seancaulfield/tick/README.md

tick
====

Terribly Illuminated Chronology Keeper
