seancaulfield/tick/hardware/DESCRIPTION.md

Terribly Illuminated Chronology Keeper (T.I.C.K) Mk 4.6.4

RTC, microcontroller, and whatever else my crazy brain thinks would be a good idea to throw in there. Don't ask what happened to the other revisions.

* Includes integrated RTC (DS3231) with CR2032 battery backup.
* ATMega328P uC
* 7-segment, 4 digit LED clock display, 0.8" digit height
* 7-segment, 8 digit LED date display, 0.4" digit height
* 96mm x 53mm PCB, should fit in a Hammond 1591C series enclosure

Design files in EAGLE format, firmware, and licensing info available on github:

[https://github.com/schizobovine/tick](https://github.com/schizobovine/tick)
