seancaulfield/tick/hardware/tick-pcf2129t-breakout-mk-1.0.brd

## EAGLE design hardware/tick-pcf2129t-breakout-mk-1.0.brd (2019-09-15)

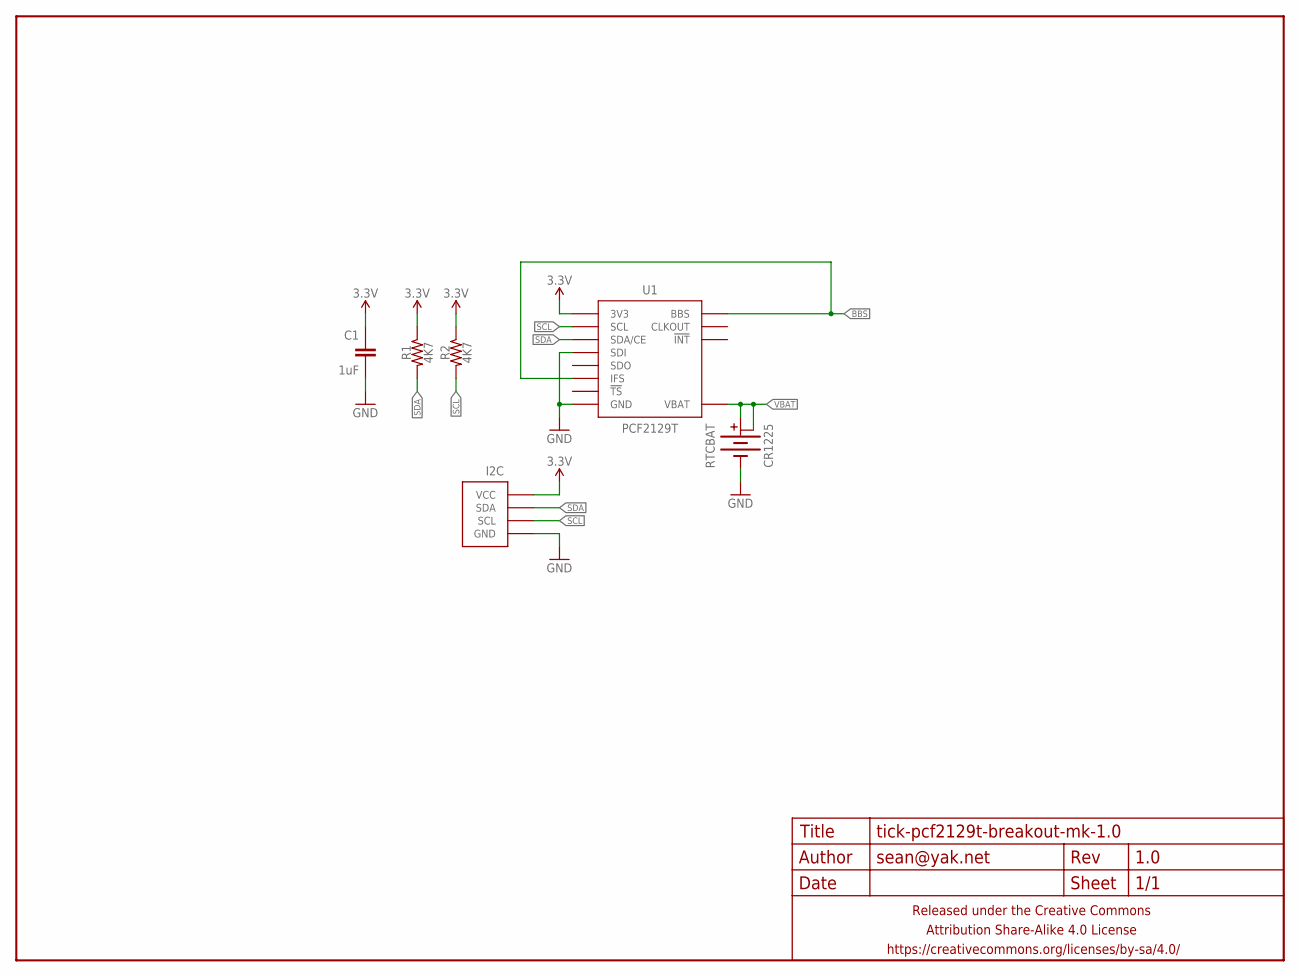
[picture p4: schematic tick-pcf2129t-breakout-mk-1.0.sch]

Parts:
C1: 1uF; C0603-TIGHTER
FRAME1: FRAME-LETTERNO_PACKAGE; DUMMY
I2C: M04-I2CPTH-0.1IN-CENTERED; 1X04-PTH-VERT-I2C-CENTERED
R1, R2: 4K7; R0603-TIGHTER
RTCBAT: CR1225; BATTCON_12MM_SMD
U1: PCF2129T; SO16W

Connections:
3.3V: C1.1, I2C.VCC, R1.1, R2.1, U1.16 (3V3)
BBS: U1.5 (IFS), U1.14 (BBS)
GND: C1.2, I2C.GND, RTCBAT.-, U1.2 (SDI), U1.8 (GND)
SCL: I2C.SCL, R2.2, U1.1 (SCL)
SDA: I2C.SDA, R1.2, U1.4 (SDA/CE)
VBAT: RTCBAT.+@1 (+), RTCBAT.+@2 (+1), U1.15 (VBAT)

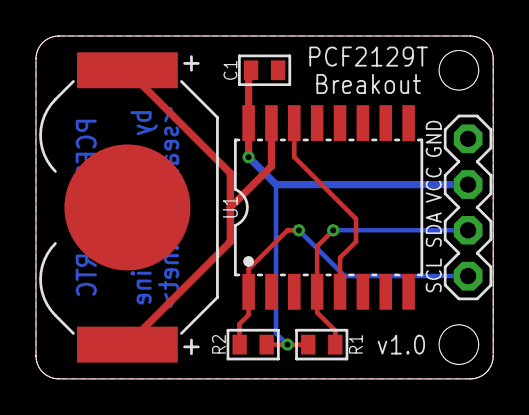
[picture p5: board tick-pcf2129t-breakout-mk-1.0.brd from above]

Board: 2 copper layers, 25.4 x 19.1 mm, 8 parts (1 on the bottom side), 6 nets.

Other parts of the board:
U$1: COW_SMALL
