seancaulfield/tick/hardware/tick-pi-mk-1.0.brd

## EAGLE design hardware/tick-pi-mk-1.0.brd (2019-09-15)

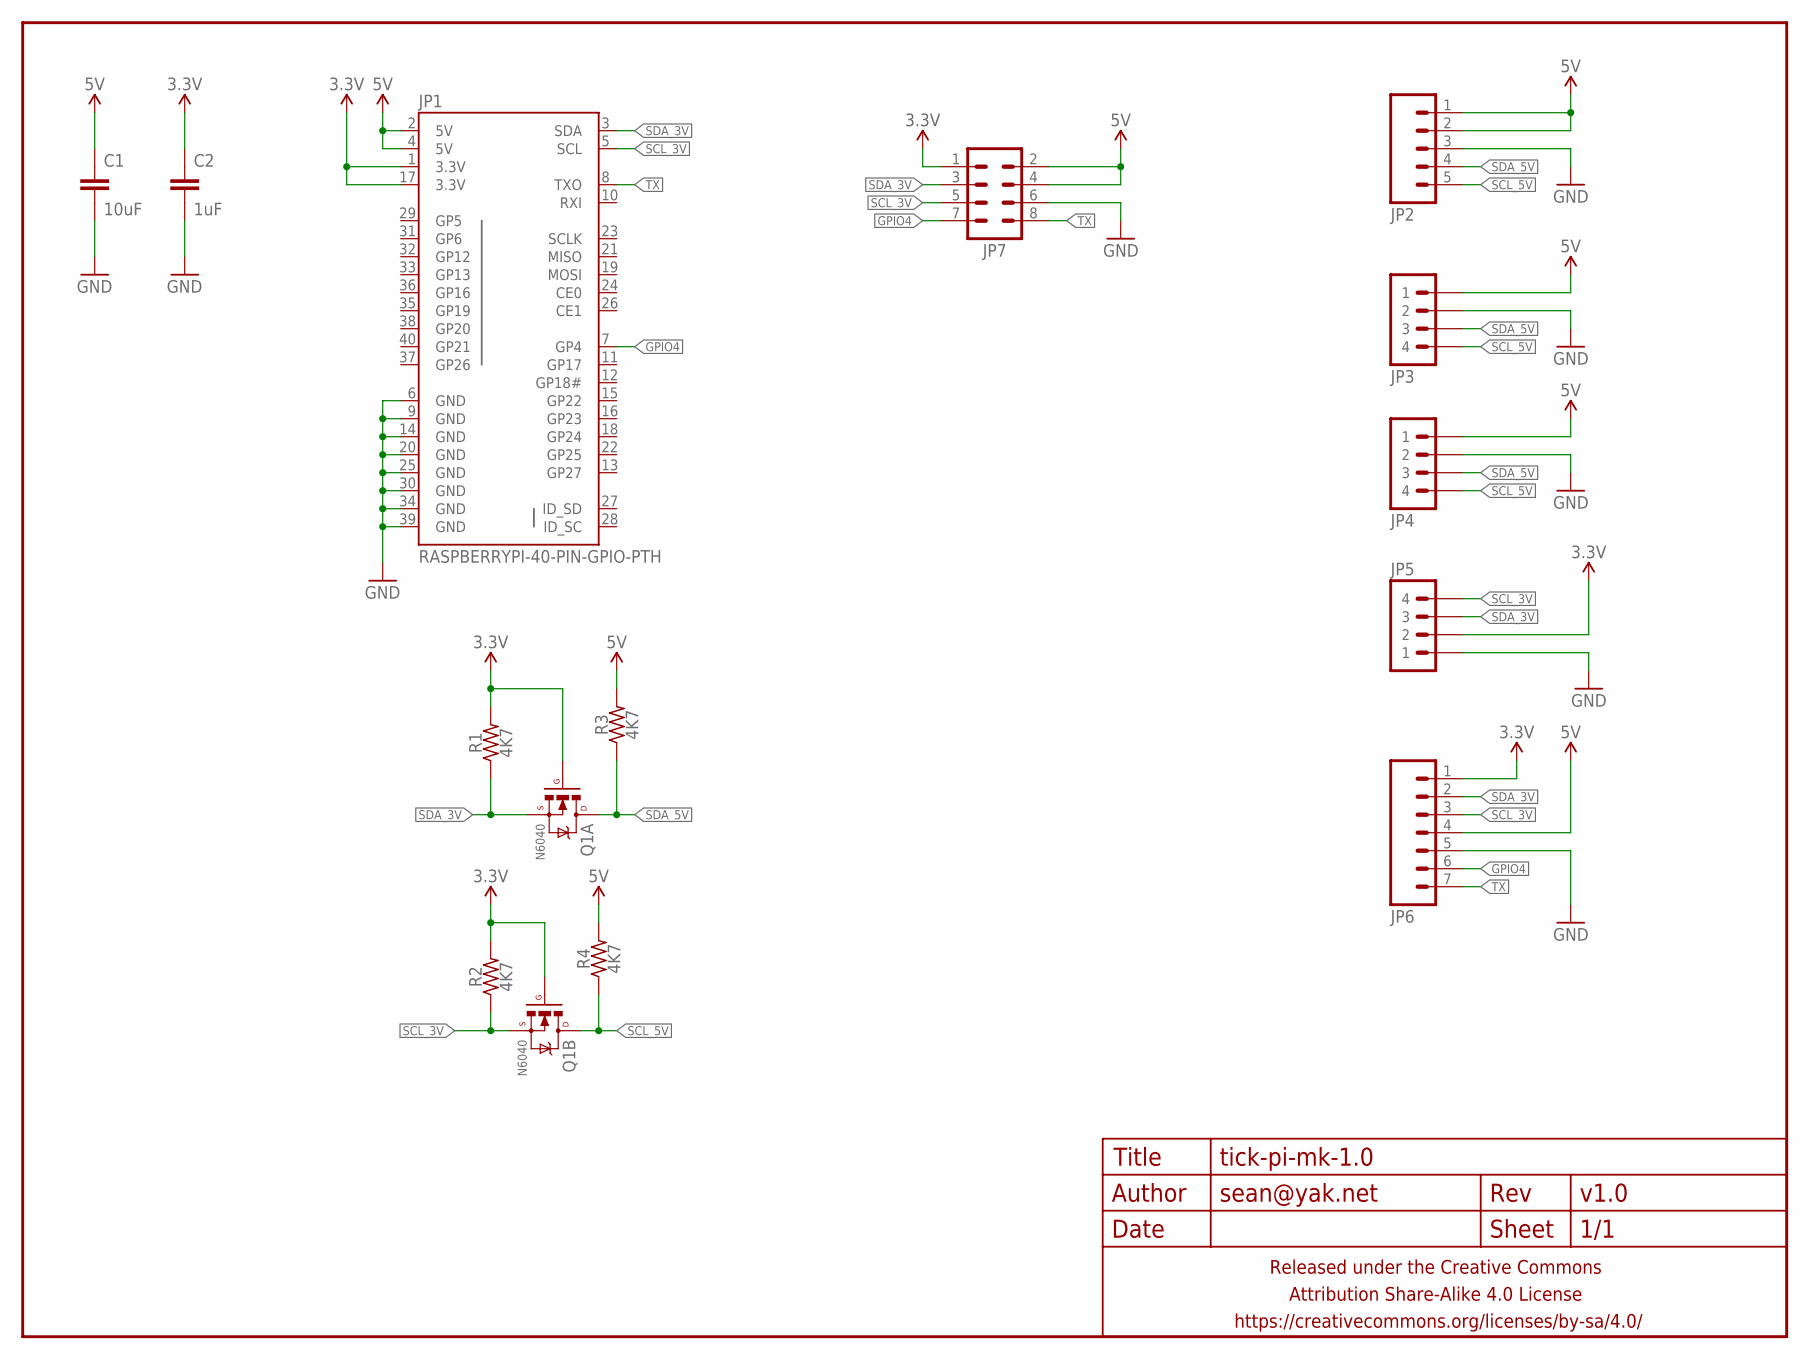
[picture p6: schematic tick-pi-mk-1.0.sch]

Parts:
C1: 10uF; C0805-TIGHTER
C2: 1uF; C0805-TIGHTER
FRAME1: FRAME-LETTERNO_PACKAGE; DUMMY
JP1: RASPBERRYPI-40-PIN-GPIO-PTH; 2X20_PTH
JP2: M05PTH-CENTERED-RA-FEMALE; 1X05_PTH_CENTERED_RA_FEMALE
JP3, JP4, JP5: M04PTH; 1X04-PTH-VERT
JP6: M07; 1X07
JP7: M04X2PTH; 2X4_PTH
Q1: N6040; SO08
R1, R2, R3, R4: 4K7; R0603

Connections:
3.3V: C2.1, JP1.1 (3.3V), JP1.17 (3.3V), JP5.2, JP6.1, JP7.1, Q1.2 (G), Q1.4 (G), R1.2, R2.2
5V: C1.1, JP1.2 (5V), JP1.4 (5V), JP2.1, JP2.2, JP3.1, JP4.1, JP6.4, JP7.2, JP7.4, R3.2, R4.2
GND: C1.2, C2.2, JP1.6 (GND), JP1.9 (GND), JP1.14 (GND), JP1.20 (GND), JP1.25 (GND), JP1.30 (GND), JP1.34 (GND), JP1.39 (GND), JP2.3, JP3.2, JP4.2, JP5.1, JP6.5, JP7.6
GPIO4: JP1.7 (GP4), JP6.6, JP7.7
SCL_3V: JP1.5 (SCL), JP5.4, JP6.3, JP7.5, Q1.3 (S), R2.1
SCL_5V: JP2.5, JP3.4, JP4.4, Q1.5 (D), Q1.6 (D), R4.1
SDA_3V: JP1.3 (SDA), JP5.3, JP6.2, JP7.3, Q1.1 (S), R1.1
SDA_5V: JP2.4, JP3.3, JP4.3, Q1.7 (D), Q1.8 (D), R3.1
TX: JP1.8 (TXO), JP6.7, JP7.8

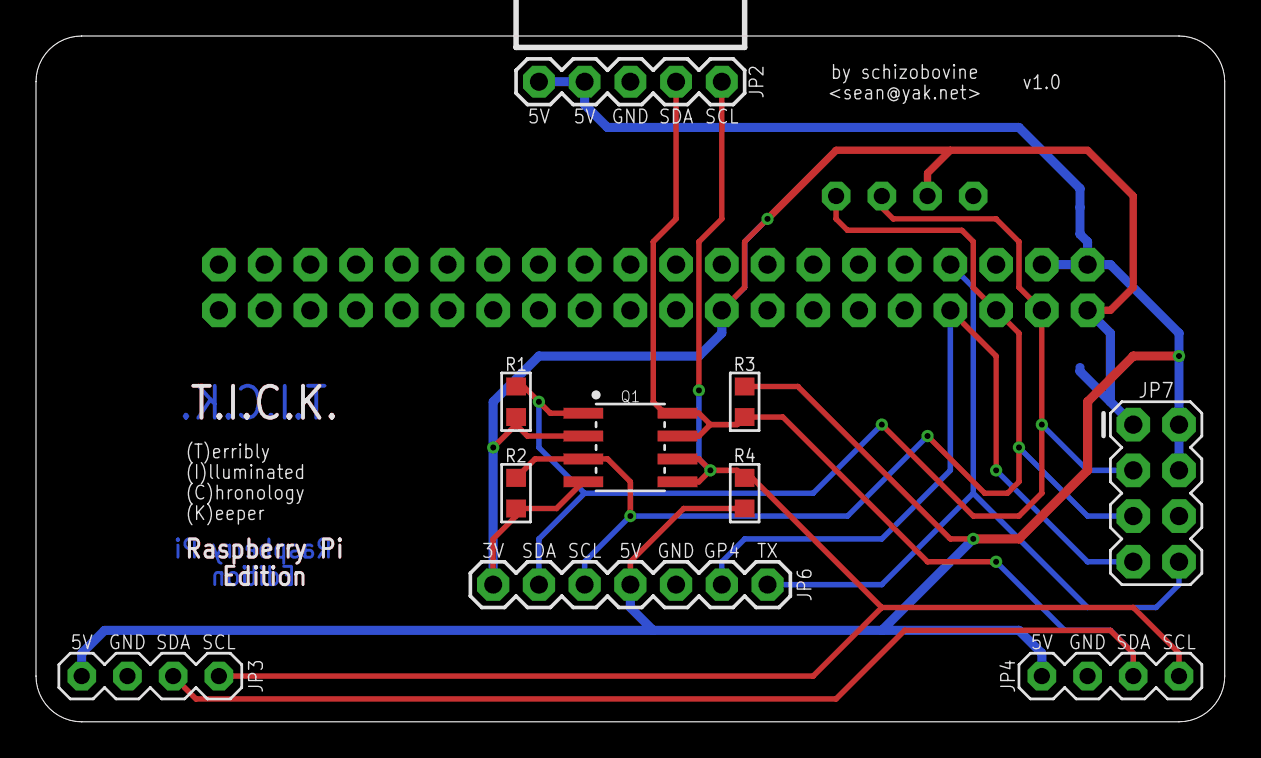
[picture p7: board tick-pi-mk-1.0.brd from above]

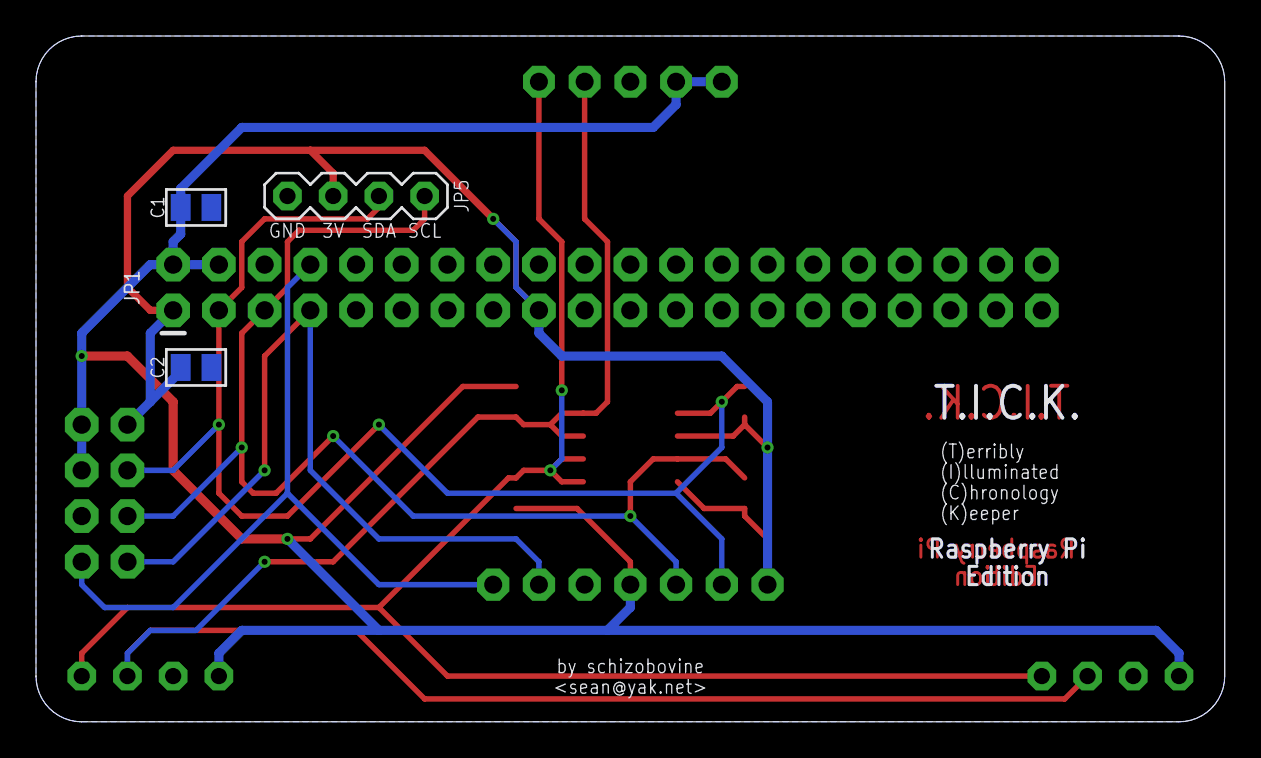
[picture p8: board tick-pi-mk-1.0.brd from below]

Board: 2 copper layers, 66.0 x 38.1 mm, 15 parts (4 on the bottom side), 9 nets.
