seancaulfield/tick/hardware/tick-wifi-mk-1.2.brd

## EAGLE design hardware/tick-wifi-mk-1.2.brd (2016-08-26)

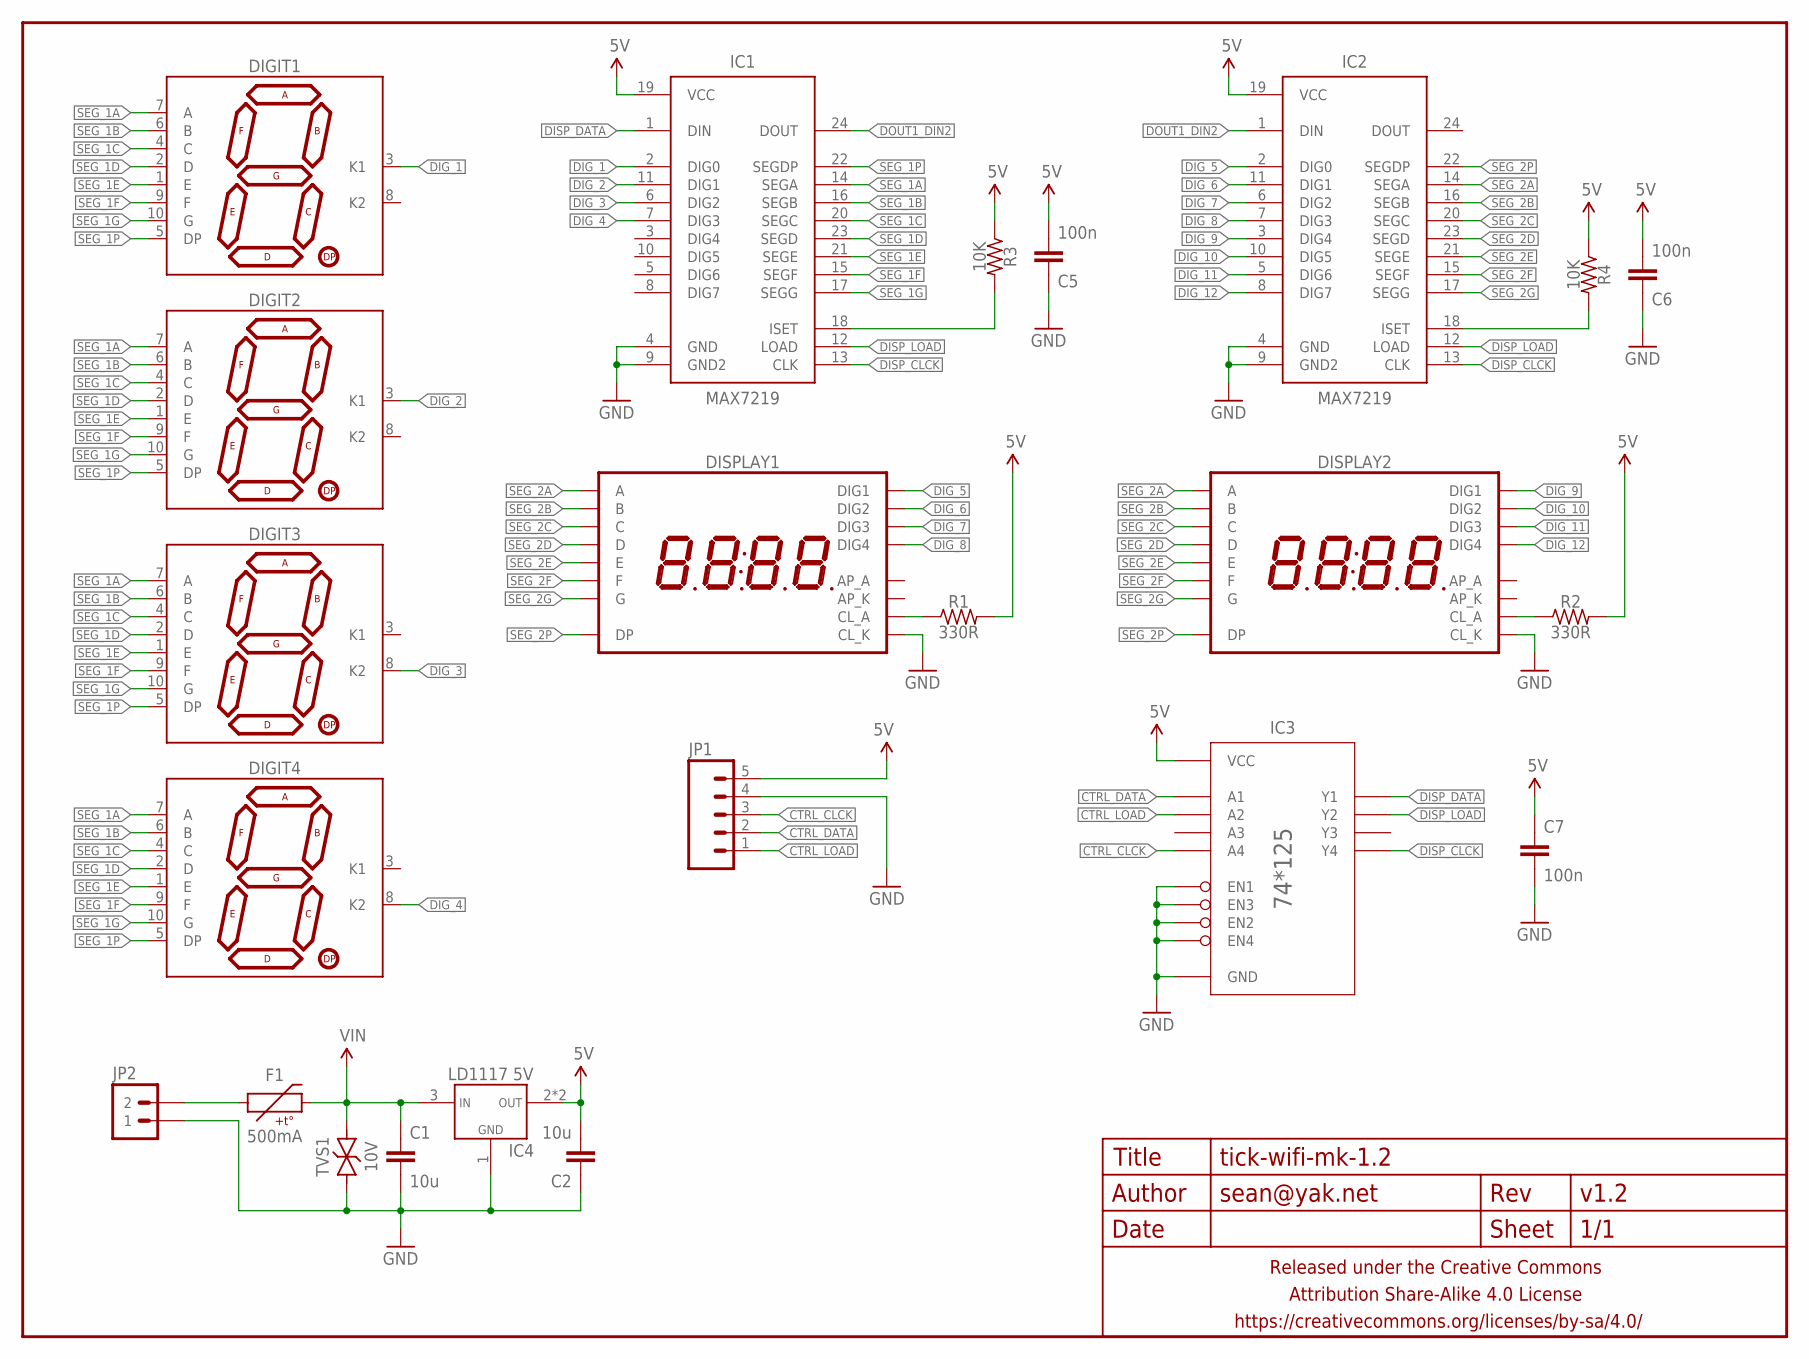
[picture p9: schematic tick-wifi-mk-1.2.sch]

Parts:
C1, C2: 10u; C1210
C5, C6, C7: 100n; C0603
DIGIT1, DIGIT2, DIGIT3, DIGIT4: 7SEG_1DIGPTH-25.4MM-BARE; 7SEG_1DIG_25.4MM_NOSILK
DISPLAY1, DISPLAY2: 7SEG_4DIGIT_COLON_APOS; 7SEG_4DIG_10MM
F1: 500mA; PTC-1210
FRAME1: FRAME-LETTERNO_PACKAGE; DUMMY
IC1, IC2: MAX7219; SO24W
IC3: 74HC125; SO14
IC4: LD1117 5V; SOT223
JP1: M05PTH-CENTERED; 1X05_PTH_CENTERED
JP2: M02PTH-CENTERED-R+; 1X02-CENTER-R+
R1, R2: 330R; R0603
R3, R4: 10K; R0603
TVS1: 10V; SMA-DIODE-TVS-BIDIR

Connections:
5V: C2.2, C5.2, C6.2, C7.1, IC1.19 (VCC), IC2.19 (VCC), IC3.14 (VCC), IC4.2 (VOUT), IC4.4 (VOUT), JP1.5, R1.2, R2.2, R3.1, R4.1
CTRL_CLCK: IC3.12 (A4), JP1.3
CTRL_DATA: IC3.2 (A1), JP1.2
CTRL_LOAD: IC3.5 (A2), JP1.1
DIG_1: DIGIT1.3 (K1), IC1.2 (DIG0)
DIG_2: DIGIT2.3 (K1), IC1.11 (DIG1)
DIG_3: DIGIT3.8 (K2), IC1.6 (DIG2)
DIG_4: DIGIT4.8 (K2), IC1.7 (DIG3)
DIG_5: DISPLAY1.1 (DIG1), IC2.2 (DIG0)
DIG_6: DISPLAY1.2 (DIG2), IC2.11 (DIG1)
DIG_7: DISPLAY1.6 (DIG3), IC2.6 (DIG2)
DIG_8: DISPLAY1.8 (DIG4), IC2.7 (DIG3)
DIG_9: DISPLAY2.1 (DIG1), IC2.3 (DIG4)
DIG_10: DISPLAY2.2 (DIG2), IC2.10 (DIG5)
DIG_11: DISPLAY2.6 (DIG3), IC2.5 (DIG6)
DIG_12: DISPLAY2.8 (DIG4), IC2.8 (DIG7)
DISP_CLCK: IC1.13 (CLK), IC2.13 (CLK), IC3.11 (Y4)
DISP_DATA: IC1.1 (DIN), IC3.3 (Y1)
DISP_LOAD: IC1.12 (LOAD), IC2.12 (LOAD), IC3.6 (Y2)
DOUT1_DIN2: IC1.24 (DOUT), IC2.1 (DIN)
GND: C1.2, C2.1, C5.1, C6.1, C7.2, DISPLAY1.12 (CL_K), DISPLAY2.12 (CL_K), IC1.4 (GND), IC1.9 (GND2), IC2.4 (GND), IC2.9 (GND2), IC3.1 (EN1), IC3.4 (EN2), IC3.7 (GND), IC3.10 (EN3), IC3.13 (EN4), IC4.1 (GND), JP1.4, JP2.1, TVS1.1
unnamed: F1.1, JP2.2
unnamed: IC2.18 (ISET), R4.2
unnamed: DISPLAY1.4 (CL_A), R1.1
unnamed: IC1.18 (ISET), R3.2
unnamed: DISPLAY2.4 (CL_A), R2.1
SEG_1A: DIGIT1.7 (A), DIGIT2.7 (A), DIGIT3.7 (A), DIGIT4.7 (A), IC1.14 (SEGA)
SEG_1B: DIGIT1.6 (B), DIGIT2.6 (B), DIGIT3.6 (B), DIGIT4.6 (B), IC1.16 (SEGB)
SEG_1C: DIGIT1.4 (C), DIGIT2.4 (C), DIGIT3.4 (C), DIGIT4.4 (C), IC1.20 (SEGC)
SEG_1D: DIGIT1.2 (D), DIGIT2.2 (D), DIGIT3.2 (D), DIGIT4.2 (D), IC1.23 (SEGD)
SEG_1E: DIGIT1.1 (E), DIGIT2.1 (E), DIGIT3.1 (E), DIGIT4.1 (E), IC1.21 (SEGE)
SEG_1F: DIGIT1.9 (F), DIGIT2.9 (F), DIGIT3.9 (F), DIGIT4.9 (F), IC1.15 (SEGF)
SEG_1G: DIGIT1.10 (G), DIGIT2.10 (G), DIGIT3.10 (G), DIGIT4.10 (G), IC1.17 (SEGG)
SEG_1P: DIGIT1.5 (DP), DIGIT2.5 (DP), DIGIT3.5 (DP), DIGIT4.5 (DP), IC1.22 (SEGDP)
SEG_2A: DISPLAY1.14 (A), DISPLAY2.14 (A), IC2.14 (SEGA)
SEG_2B: DISPLAY1.16 (B), DISPLAY2.16 (B), IC2.16 (SEGB)
SEG_2C: DISPLAY1.13 (C), DISPLAY2.13 (C), IC2.20 (SEGC)
SEG_2D: DISPLAY1.3 (D), DISPLAY2.3 (D), IC2.23 (SEGD)
SEG_2E: DISPLAY1.5 (E), DISPLAY2.5 (E), IC2.21 (SEGE)
SEG_2F: DISPLAY1.11 (F), DISPLAY2.11 (F), IC2.15 (SEGF)
SEG_2G: DISPLAY1.15 (G), DISPLAY2.15 (G), IC2.17 (SEGG)
SEG_2P: DISPLAY1.7 (DP), DISPLAY2.7 (DP), IC2.22 (SEGDP)
VIN: C1.1, F1.2, IC4.3 (VIN), TVS1.2

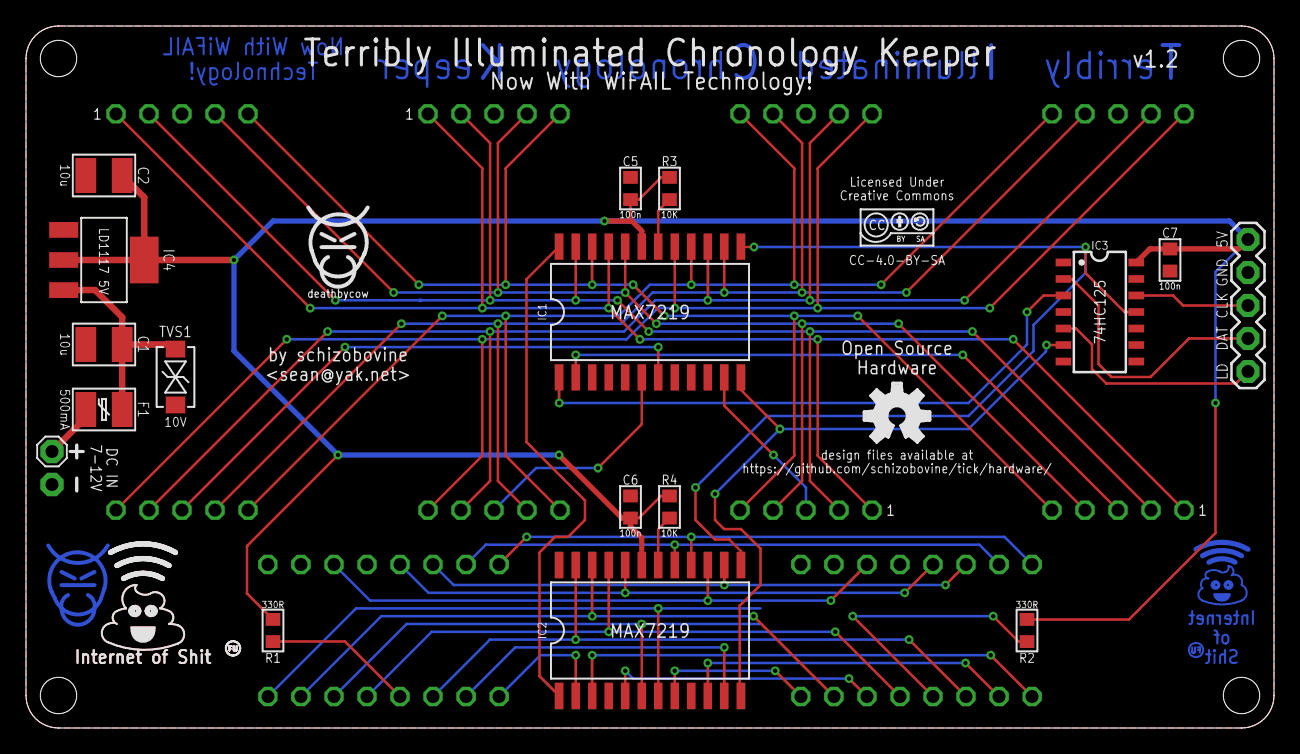
[picture p10: board tick-wifi-mk-1.2.brd from above]

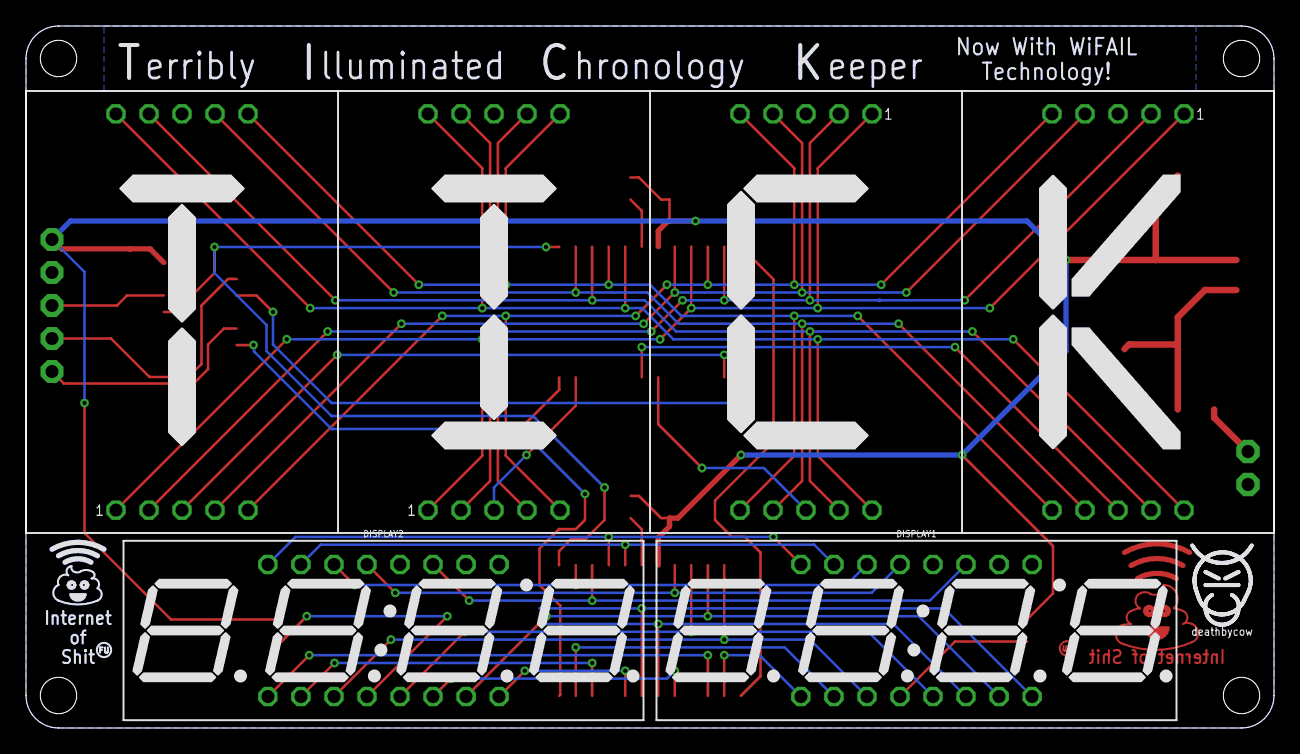
[picture p11: board tick-wifi-mk-1.2.brd from below]

Board: 2 copper layers, 96.0 x 54.0 mm, 34 parts (11 on the bottom side), 43 nets.

Other parts of the board:
U$1: TICK_SYMBOL
U$2, U$5: COW_SMALL
U$3: INTERNET_OF_SHIT_TEXT_METAL
U$4: INTERNET_OF_SHIT_TEXT
U$6: CC-BY-SA-4.0-NO-URL
U$7: OSHWLOGO_SILKONLY
U$8: INTERNET_OF_SHIT_JR_METAL
U$9: COW_SMALL_METAL_NOTEXT
U$10: F_YOU_MARK_METAL
