seancaulfield/tick/hardware/tick-wifi-mini-mk-1.3.brd

## EAGLE design hardware/tick-wifi-mini-mk-1.3.brd (2016-08-19)

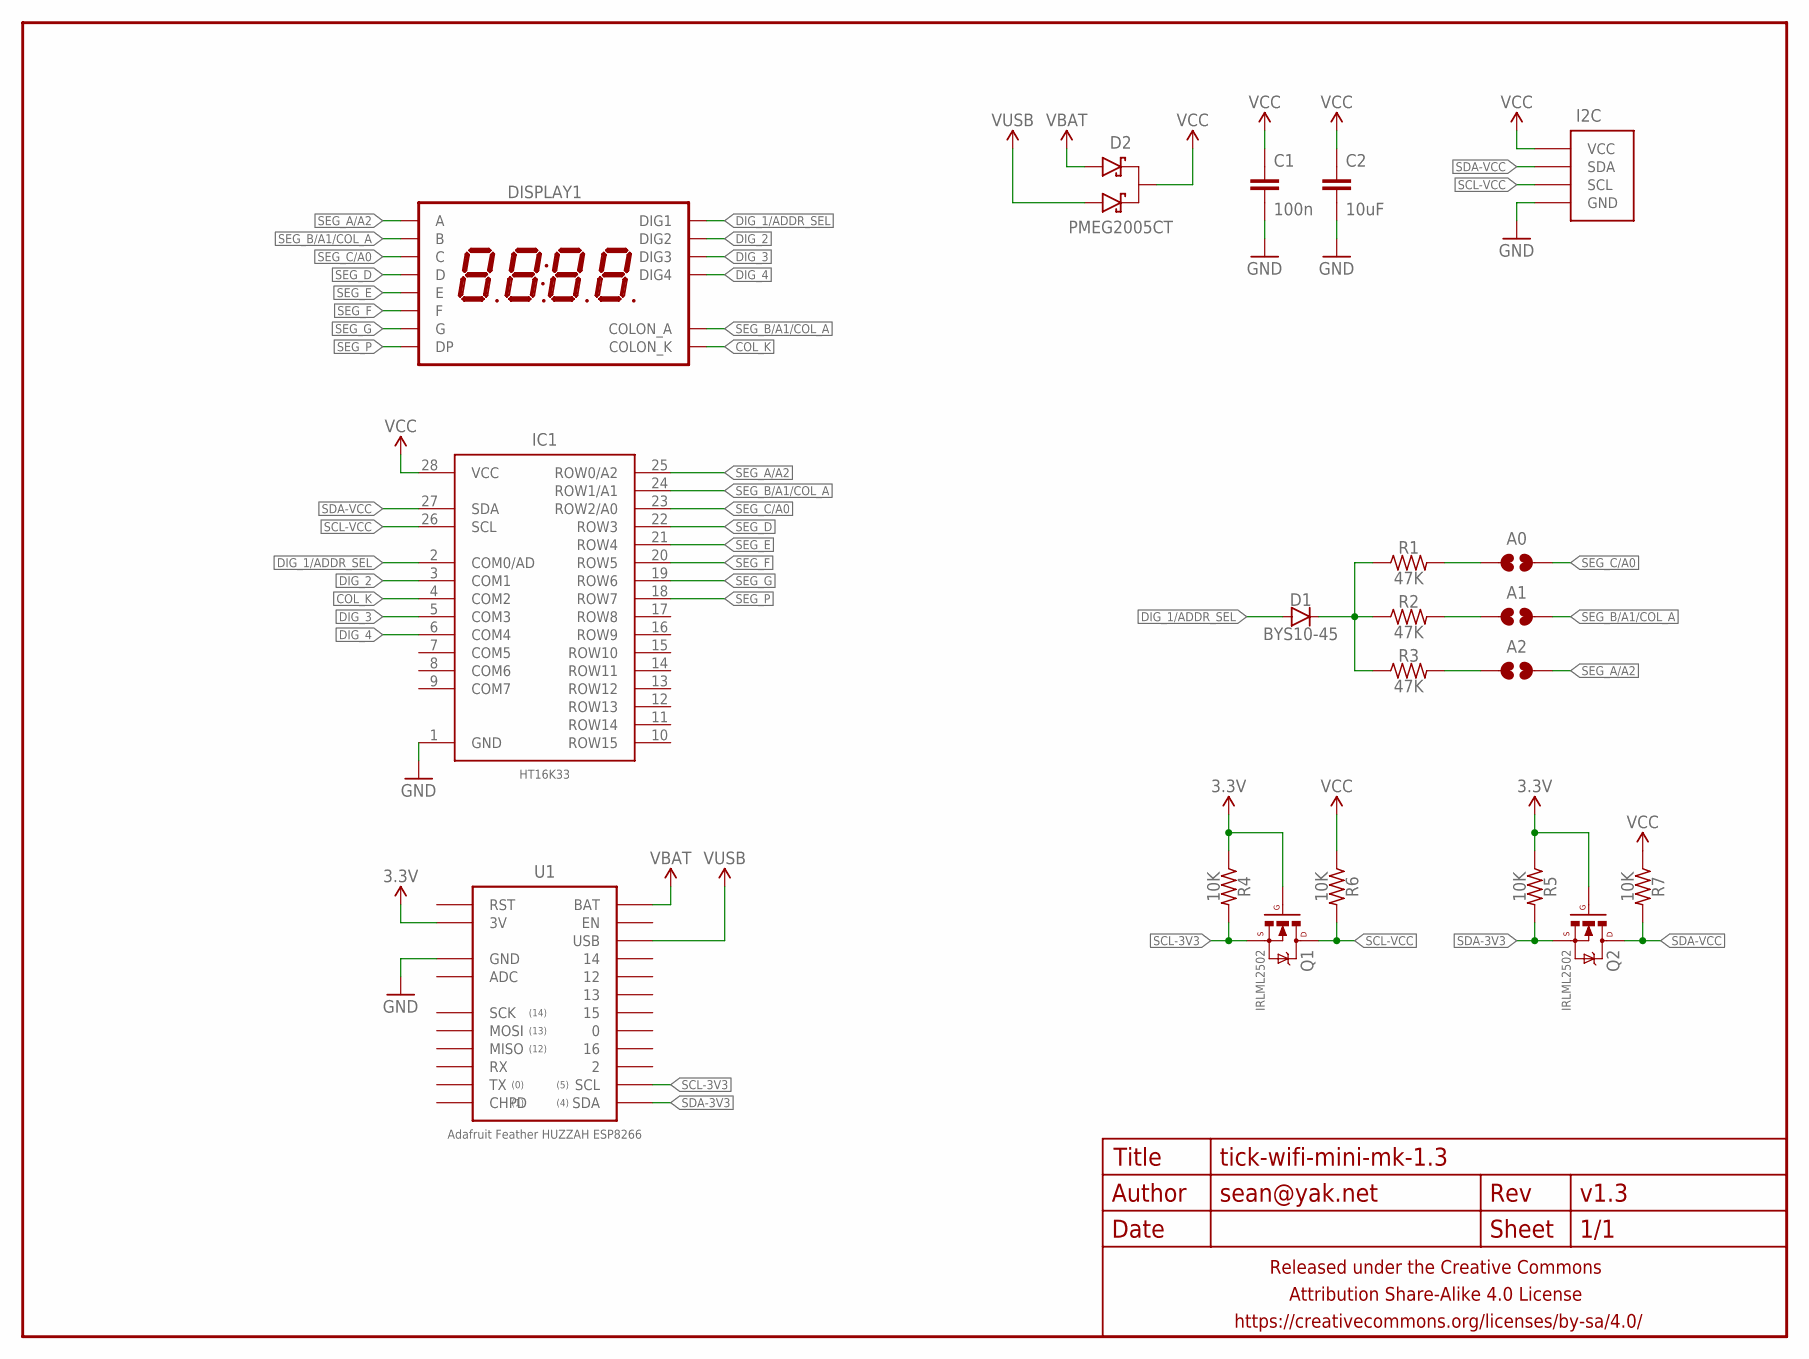
[picture p12: schematic tick-wifi-mini-mk-1.3.sch]

Parts:
A0, A1, A2: JUMPER-PAD-2-NOYES_SILK; PAD-JUMPER-2-NO_YES_SILK
C1: 100n; C0603-TIGHTER
C2: 10uF; C0805-TIGHTER
D1: BYS10-45; SOD323
D2: PMEG2005CT; SOT23
DISPLAY1: 7SEG_4DIGIT_COLON14.2MM-CC; 7SEG_4DIG_0.56IN_14MM_ADAFRUIT
FRAME1: FRAME-LETTERNO_PACKAGE; DUMMY
I2C: M04-I2CPTH-2MM-CENTERED; 1X04-2MM-CENTERED-I2C
IC1: HT16K33; SOIC28W
Q1, Q2: IRLML2502; SOT23
R1, R2, R3: 47K; R0603-TIGHTER
R4, R5, R6, R7: 10K; R0603-TIGHTER
U1: Adafruit Feather HUZZAH ESP8266; ADAFRUIT_FEATHER_HUZZAH_NOSILK

Connections:
3.3V: Q1.1 (G), Q2.1 (G), R4.1, R5.1, U1.3V
COL_K: DISPLAY1.P$7 (COLON_K), IC1.4 (COM2)
DIG_1/ADDR_SEL: D1.A, DISPLAY1.P$14 (DIG1), IC1.2 (COM0/AD)
DIG_2: DISPLAY1.P$11 (DIG2), IC1.3 (COM1)
DIG_3: DISPLAY1.P$10 (DIG3), IC1.5 (COM3)
DIG_4: DISPLAY1.P$6 (DIG4), IC1.6 (COM4)
GND: C1.2, C2.2, I2C.1 (GND), IC1.1 (GND), U1.GND@0 (GND)
unnamed: D1.C, R1.1, R2.1, R3.1
unnamed: A0.1, R1.2
unnamed: A1.1, R2.2
unnamed: A2.1, R3.2
SCL-3V3: Q1.2 (S), R4.2, U1.SCL
SCL-VCC: I2C.4 (SCL), IC1.26 (SCL), Q1.3 (D), R6.2
SDA-3V3: Q2.2 (S), R5.2, U1.SDA
SDA-VCC: I2C.3 (SDA), IC1.27 (SDA), Q2.3 (D), R7.2
SEG_A/A2: A2.2, DISPLAY1.P$13 (A), IC1.25 (ROW0/A2)
SEG_B/A1/COL_A: A1.2, DISPLAY1.P$8 (COLON_A), DISPLAY1.P$9 (B), IC1.24 (ROW1/A1)
SEG_C/A0: A0.2, DISPLAY1.P$4 (C), IC1.23 (ROW2/A0)
SEG_D: DISPLAY1.P$2 (D), IC1.22 (ROW3)
SEG_E: DISPLAY1.P$1 (E), IC1.21 (ROW4)
SEG_F: DISPLAY1.P$12 (F), IC1.20 (ROW5)
SEG_G: DISPLAY1.P$5 (G), IC1.19 (ROW6)
SEG_P: DISPLAY1.P$3 (DP), IC1.18 (ROW7)
VBAT: D2.1 (A1), U1.BAT
VCC: C1.1, C2.1, D2.3 (K), I2C.2 (VCC), IC1.28 (VCC), R6.1, R7.1
VUSB: D2.2 (A2), U1.USB

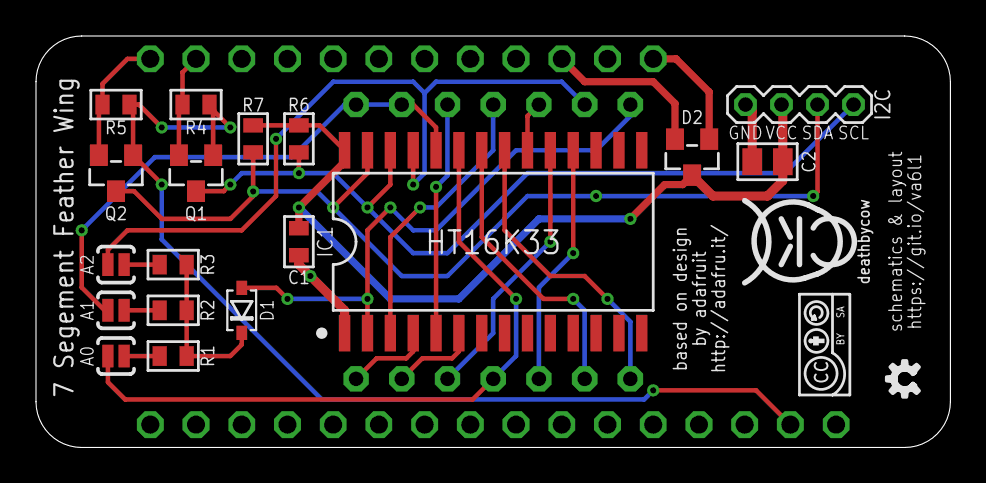
[picture p13: board tick-wifi-mini-mk-1.3.brd from above]

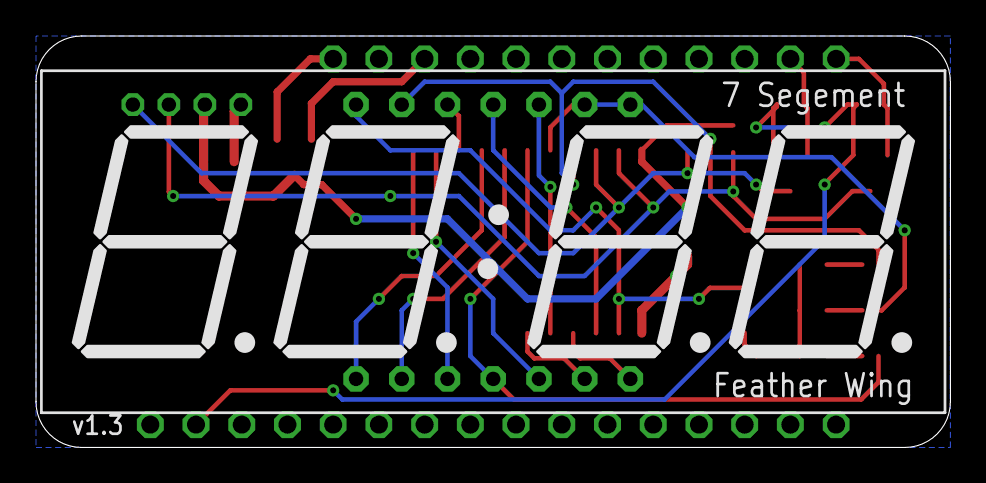
[picture p14: board tick-wifi-mini-mk-1.3.brd from below]

Board: 2 copper layers, 50.8 x 22.9 mm, 24 parts (2 on the bottom side), 26 nets.

Other parts of the board:
U$2: COW_SMALL
U$3: OSHWLOGO_TINY_SILKONLY
U$4: CC-BY-SA-4.0-NO-URL
