seancaulfield/tick/hardware/tick-box-1591A-mk-5.0.brd

## EAGLE design hardware/tick-box-1591A-mk-5.0.brd (2015-12-01)

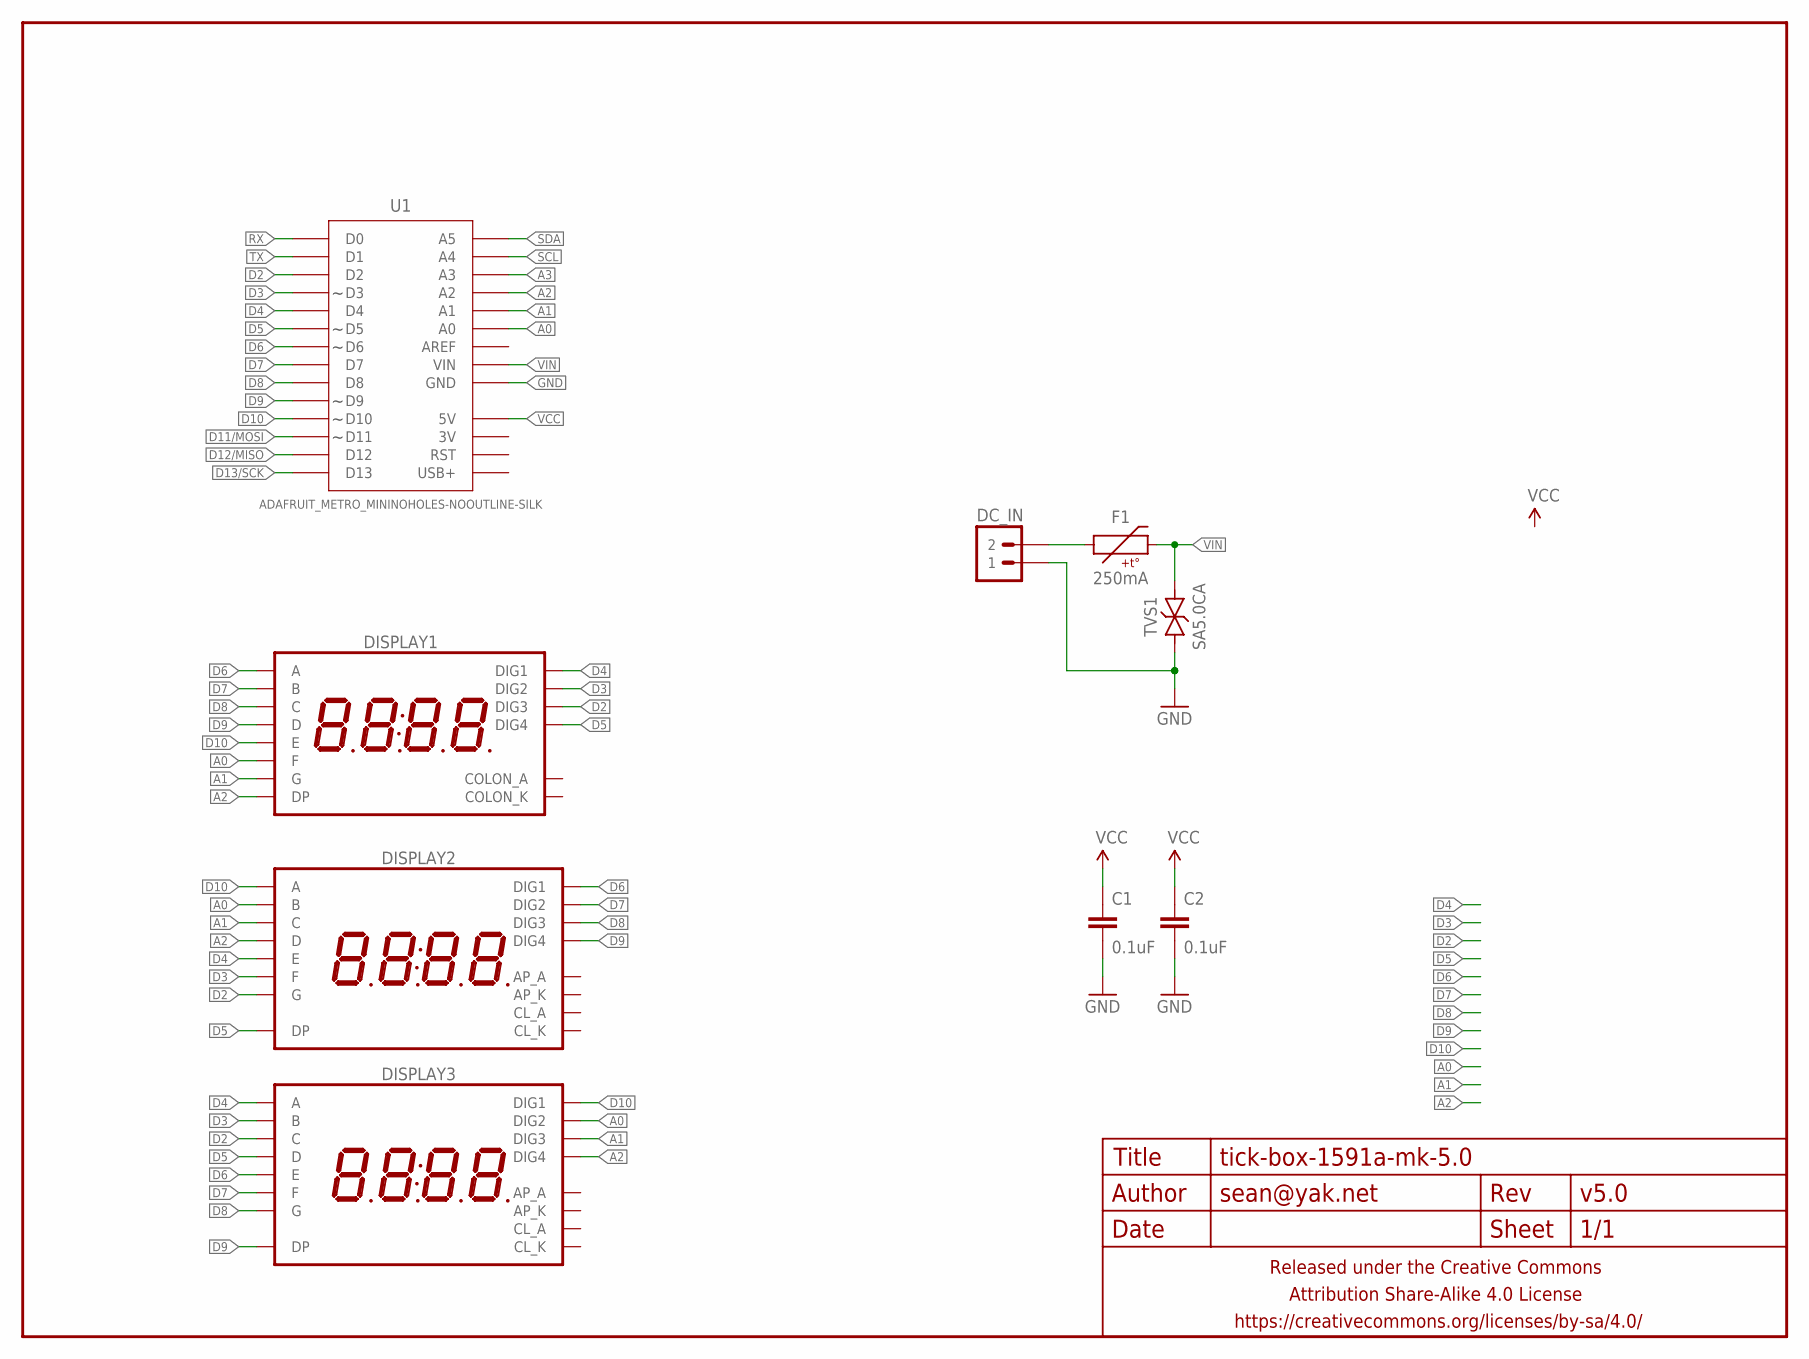
[picture p15: schematic tick-box-1591A-mk-5.0.sch]

Parts:
C1, C2: 0.1uF; C0603
DC_IN: M02PTH-CENTERED-R+; 1X02-CENTER-R+
DISPLAY1: 7SEG_4DIGIT_COLON14.2MM-CC-NS; 7SEG_4DIG_NS
DISPLAY2, DISPLAY3: 7SEG_4DIGIT_COLON_APOS; 7SEG_4DIG_10MM
F1: 250mA; PTC-1210
FRAME1: FRAME-LETTERNO_PACKAGE; DUMMY
TVS1: SA5.0CA; SMA-DIODE-TVS-BIDIR
U1: ADAFRUIT_METRO_MININOHOLES-NOOUTLINE-SILK; ADAFRUIT_METRO_MINI

Connections:
A0: DISPLAY1.P$12 (F), DISPLAY2.16 (B), DISPLAY3.2 (DIG2), U1.23 (A0)
A1: DISPLAY1.P$5 (G), DISPLAY2.13 (C), DISPLAY3.6 (DIG3), U1.24 (A1)
A2: DISPLAY1.P$3 (DP), DISPLAY2.3 (D), DISPLAY3.8 (DIG4), U1.25 (A2)
A3: U1.26 (A3)
D2: DISPLAY1.P$10 (DIG3), DISPLAY2.15 (G), DISPLAY3.13 (C), U1.3 (D2)
D3: DISPLAY1.P$11 (DIG2), DISPLAY2.11 (F), DISPLAY3.16 (B), U1.4 (D3)
D4: DISPLAY1.P$14 (DIG1), DISPLAY2.5 (E), DISPLAY3.14 (A), U1.5 (D4)
D5: DISPLAY1.P$6 (DIG4), DISPLAY2.7 (DP), DISPLAY3.3 (D), U1.6 (D5)
D6: DISPLAY1.P$13 (A), DISPLAY2.1 (DIG1), DISPLAY3.5 (E), U1.7 (D6)
D7: DISPLAY1.P$9 (B), DISPLAY2.2 (DIG2), DISPLAY3.11 (F), U1.8 (D7)
D8: DISPLAY1.P$4 (C), DISPLAY2.6 (DIG3), DISPLAY3.15 (G), U1.9 (D8)
D9: DISPLAY1.P$2 (D), DISPLAY2.8 (DIG4), DISPLAY3.7 (DP), U1.10 (D9)
D10: DISPLAY1.P$1 (E), DISPLAY2.14 (A), DISPLAY3.1 (DIG1), U1.11 (D10)
D11/MOSI: U1.12 (D11)
D12/MISO: U1.13 (D12)
D13/SCK: U1.14 (D13)
GND: C1.2, C2.2, DC_IN.1, TVS1.1, U1.19 (GND), U1.20 (GND)
unnamed: DC_IN.2, F1.1
RX: U1.1 (D0)
SCL: U1.27 (A4)
SDA: U1.28 (A5)
TX: U1.2 (D1)
VCC: C1.1, C2.1, U1.18 (5V)
VIN: F1.2, TVS1.2, U1.21 (VIN)

Board: 2 copper layers, 10 parts (3 on the bottom side), 16 nets, no tracks yet.
