seancaulfield/tick/hardware/tick-mk-5.1.brd

## EAGLE design hardware/tick-mk-5.1.brd (2015-11-30)

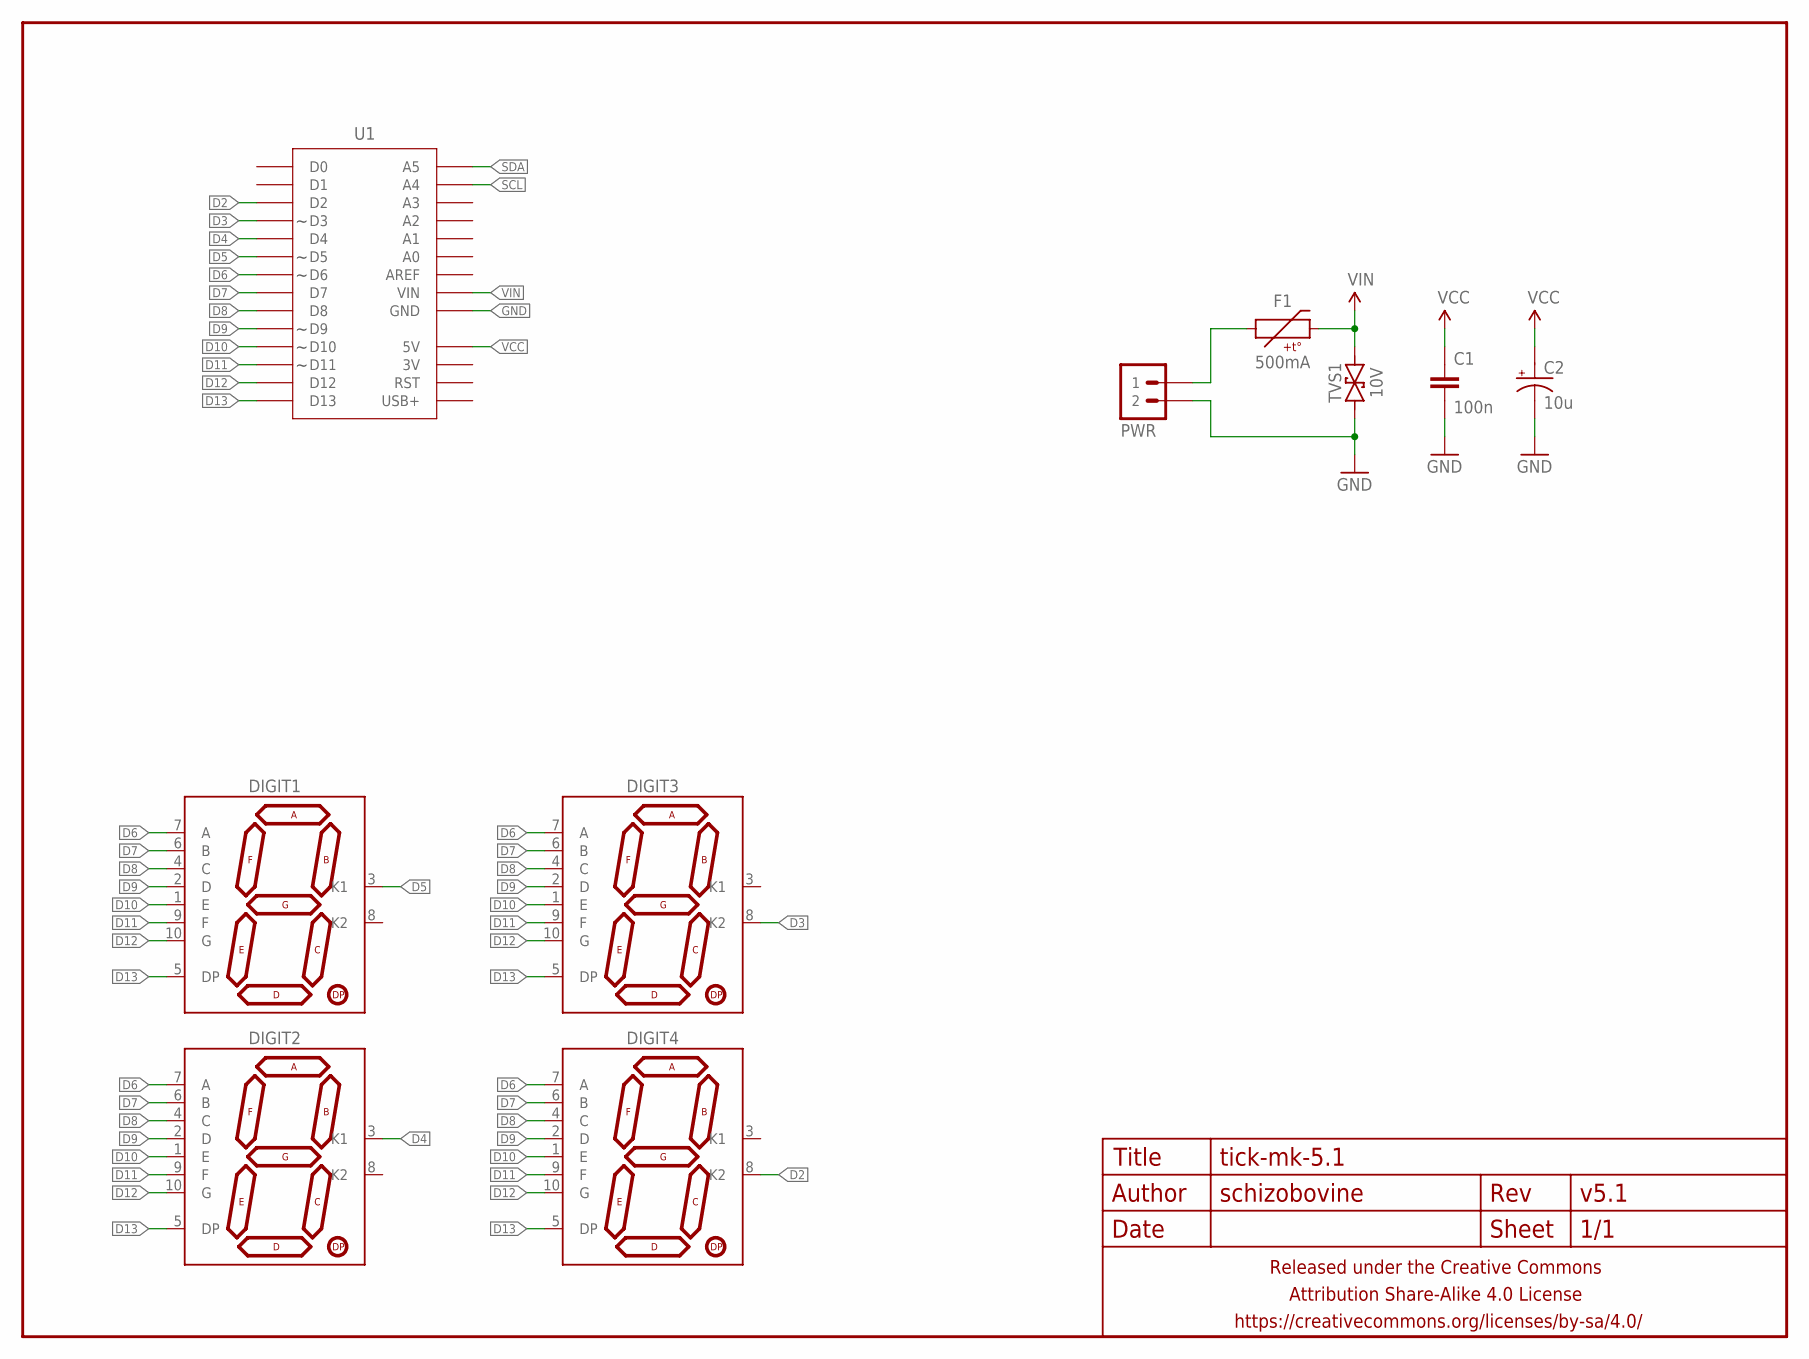
[picture p16: schematic tick-mk-5.1.sch]

Parts:
C1: 100n; C025-024X044
C2: 10u; E2-5
DIGIT1, DIGIT2, DIGIT3, DIGIT4: 7SEG_1DIGPTH-25.4MM-BARE; 7SEG_1DIG_25.4MM_NOSILK
F1: 500mA; PTC-PTH-5.08MM
FRAME1: FRAME-LETTERNO_PACKAGE; DUMMY
PWR: M02JST-PTH-VERT; JST-2-PH-VERT-PTH
TVS1: 10V; DO-41-TVS-BI-10.16MM
U1: ADAFRUIT_METRO_MININOHOLES-NOOUTLINE-SILK; ADAFRUIT_METRO_MINI

Connections:
D2: DIGIT4.8 (K2), U1.3 (D2)
D3: DIGIT3.8 (K2), U1.4 (D3)
D4: DIGIT2.3 (K1), U1.5 (D4)
D5: DIGIT1.3 (K1), U1.6 (D5)
D6: DIGIT1.7 (A), DIGIT2.7 (A), DIGIT3.7 (A), DIGIT4.7 (A), U1.7 (D6)
D7: DIGIT1.6 (B), DIGIT2.6 (B), DIGIT3.6 (B), DIGIT4.6 (B), U1.8 (D7)
D8: DIGIT1.4 (C), DIGIT2.4 (C), DIGIT3.4 (C), DIGIT4.4 (C), U1.9 (D8)
D9: DIGIT1.2 (D), DIGIT2.2 (D), DIGIT3.2 (D), DIGIT4.2 (D), U1.10 (D9)
D10: DIGIT1.1 (E), DIGIT2.1 (E), DIGIT3.1 (E), DIGIT4.1 (E), U1.11 (D10)
D11: DIGIT1.9 (F), DIGIT2.9 (F), DIGIT3.9 (F), DIGIT4.9 (F), U1.12 (D11)
D12: DIGIT1.10 (G), DIGIT2.10 (G), DIGIT3.10 (G), DIGIT4.10 (G), U1.13 (D12)
D13: DIGIT1.5 (DP), DIGIT2.5 (DP), DIGIT3.5 (DP), DIGIT4.5 (DP), U1.14 (D13)
GND: C1.2, C2.-, PWR.2, TVS1.P$1 (1), U1.19 (GND), U1.20 (GND)
unnamed: F1.P$1 (1), PWR.1
SCL: U1.27 (A4)
SDA: U1.28 (A5)
VCC: C1.1, C2.+, U1.18 (5V)
VIN: F1.P$2 (2), TVS1.P$2 (2), U1.21 (VIN)

Board: 2 copper layers, 15 parts (5 on the bottom side), 16 nets, no tracks yet.

Other parts of the board:
U$1: TICK_SYMBOL
U$2: COW_SMALL
U$4: CC-BY-SA-4.0-NO-URL
U$5: OSHWLOGO_TOP_0.2
