seancaulfield/tick/hardware/tick-mk-5.0.brd

## EAGLE design hardware/tick-mk-5.0.brd (2015-11-30)

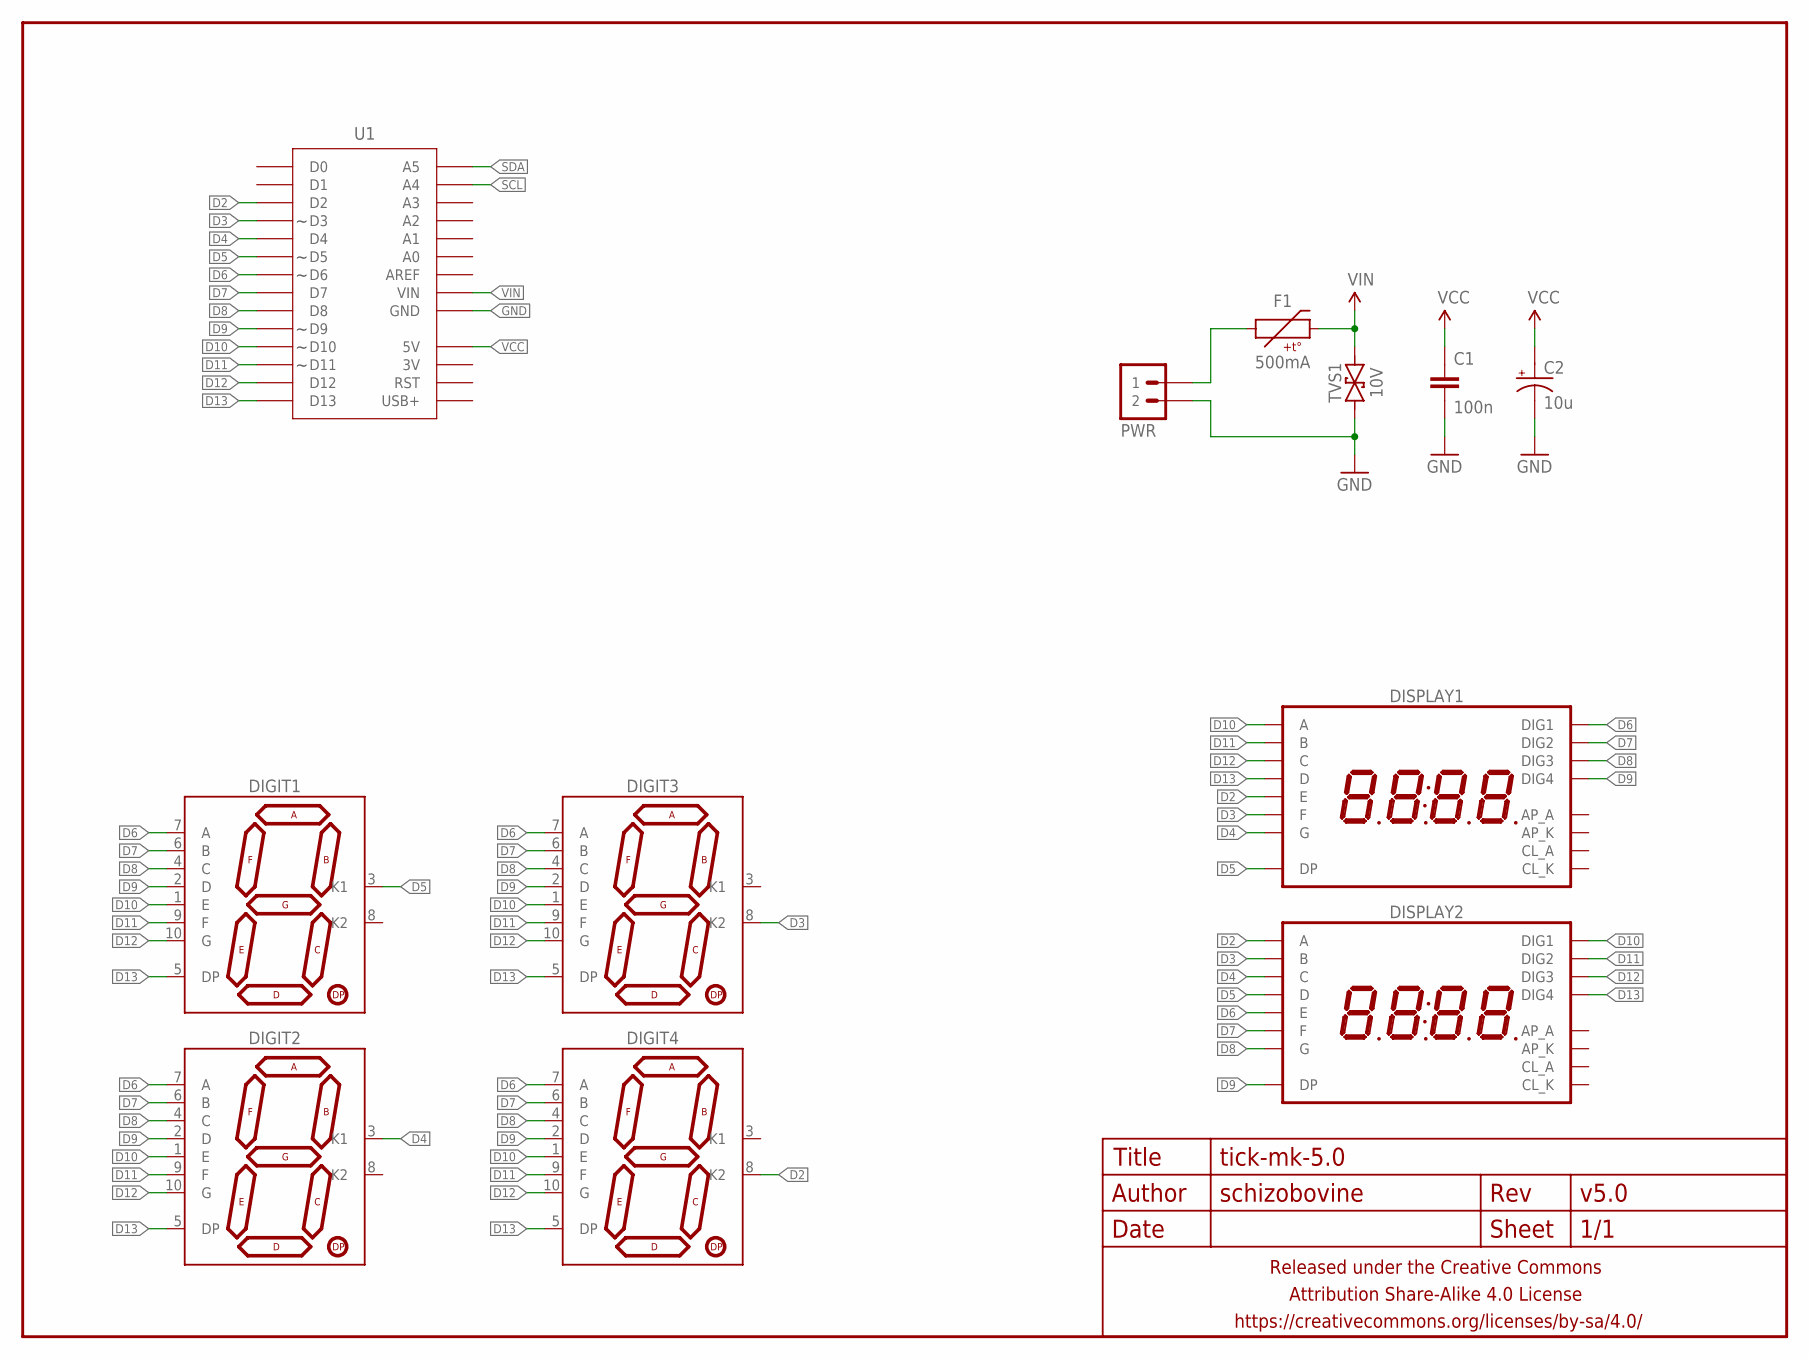
[picture p17: schematic tick-mk-5.0.sch]

Parts:
C1: 100n; C025-024X044
C2: 10u; E2-5
DIGIT1, DIGIT2, DIGIT3, DIGIT4: 7SEG_1DIGPTH-25.4MM-BARE; 7SEG_1DIG_25.4MM_NOSILK
DISPLAY1, DISPLAY2: 7SEG_4DIGIT_COLON_APOS; 7SEG_4DIG_10MM
F1: 500mA; PTC-PTH-5.08MM
FRAME1: FRAME-LETTERNO_PACKAGE; DUMMY
PWR: M02JST-PTH-VERT; JST-2-PH-VERT-PTH
TVS1: 10V; DO-41-TVS-BI-10.16MM
U1: ADAFRUIT_METRO_MININOHOLES-NOOUTLINE-SILK; ADAFRUIT_METRO_MINI

Connections:
D2: DIGIT4.8 (K2), DISPLAY1.5 (E), DISPLAY2.14 (A), U1.3 (D2)
D3: DIGIT3.8 (K2), DISPLAY1.11 (F), DISPLAY2.16 (B), U1.4 (D3)
D4: DIGIT2.3 (K1), DISPLAY1.15 (G), DISPLAY2.13 (C), U1.5 (D4)
D5: DIGIT1.3 (K1), DISPLAY1.7 (DP), DISPLAY2.3 (D), U1.6 (D5)
D6: DIGIT1.7 (A), DIGIT2.7 (A), DIGIT3.7 (A), DIGIT4.7 (A), DISPLAY1.1 (DIG1), DISPLAY2.5 (E), U1.7 (D6)
D7: DIGIT1.6 (B), DIGIT2.6 (B), DIGIT3.6 (B), DIGIT4.6 (B), DISPLAY1.2 (DIG2), DISPLAY2.11 (F), U1.8 (D7)
D8: DIGIT1.4 (C), DIGIT2.4 (C), DIGIT3.4 (C), DIGIT4.4 (C), DISPLAY1.6 (DIG3), DISPLAY2.15 (G), U1.9 (D8)
D9: DIGIT1.2 (D), DIGIT2.2 (D), DIGIT3.2 (D), DIGIT4.2 (D), DISPLAY1.8 (DIG4), DISPLAY2.7 (DP), U1.10 (D9)
D10: DIGIT1.1 (E), DIGIT2.1 (E), DIGIT3.1 (E), DIGIT4.1 (E), DISPLAY1.14 (A), DISPLAY2.1 (DIG1), U1.11 (D10)
D11: DIGIT1.9 (F), DIGIT2.9 (F), DIGIT3.9 (F), DIGIT4.9 (F), DISPLAY1.16 (B), DISPLAY2.2 (DIG2), U1.12 (D11)
D12: DIGIT1.10 (G), DIGIT2.10 (G), DIGIT3.10 (G), DIGIT4.10 (G), DISPLAY1.13 (C), DISPLAY2.6 (DIG3), U1.13 (D12)
D13: DIGIT1.5 (DP), DIGIT2.5 (DP), DIGIT3.5 (DP), DIGIT4.5 (DP), DISPLAY1.3 (D), DISPLAY2.8 (DIG4), U1.14 (D13)
GND: C1.2, C2.-, PWR.2, TVS1.P$1 (1), U1.19 (GND), U1.20 (GND)
unnamed: F1.P$1 (1), PWR.1
SCL: U1.27 (A4)
SDA: U1.28 (A5)
VCC: C1.1, C2.+, U1.18 (5V)
VIN: F1.P$2 (2), TVS1.P$2 (2), U1.21 (VIN)

Board: 2 copper layers, 19 parts (9 on the bottom side), 16 nets, no tracks yet.

Other parts of the board:
U$1: TICK_SYMBOL
U$2: COW_SMALL
U$4, U$7: CC-BY-SA-4.0-NO-URL
U$5, U$6: OSHWLOGO_TOP_0.2
