seancaulfield/tick/hardware/tick-shield-mk-2.0.brd

## EAGLE design hardware/tick-shield-mk-2.0.brd (2015-08-10)

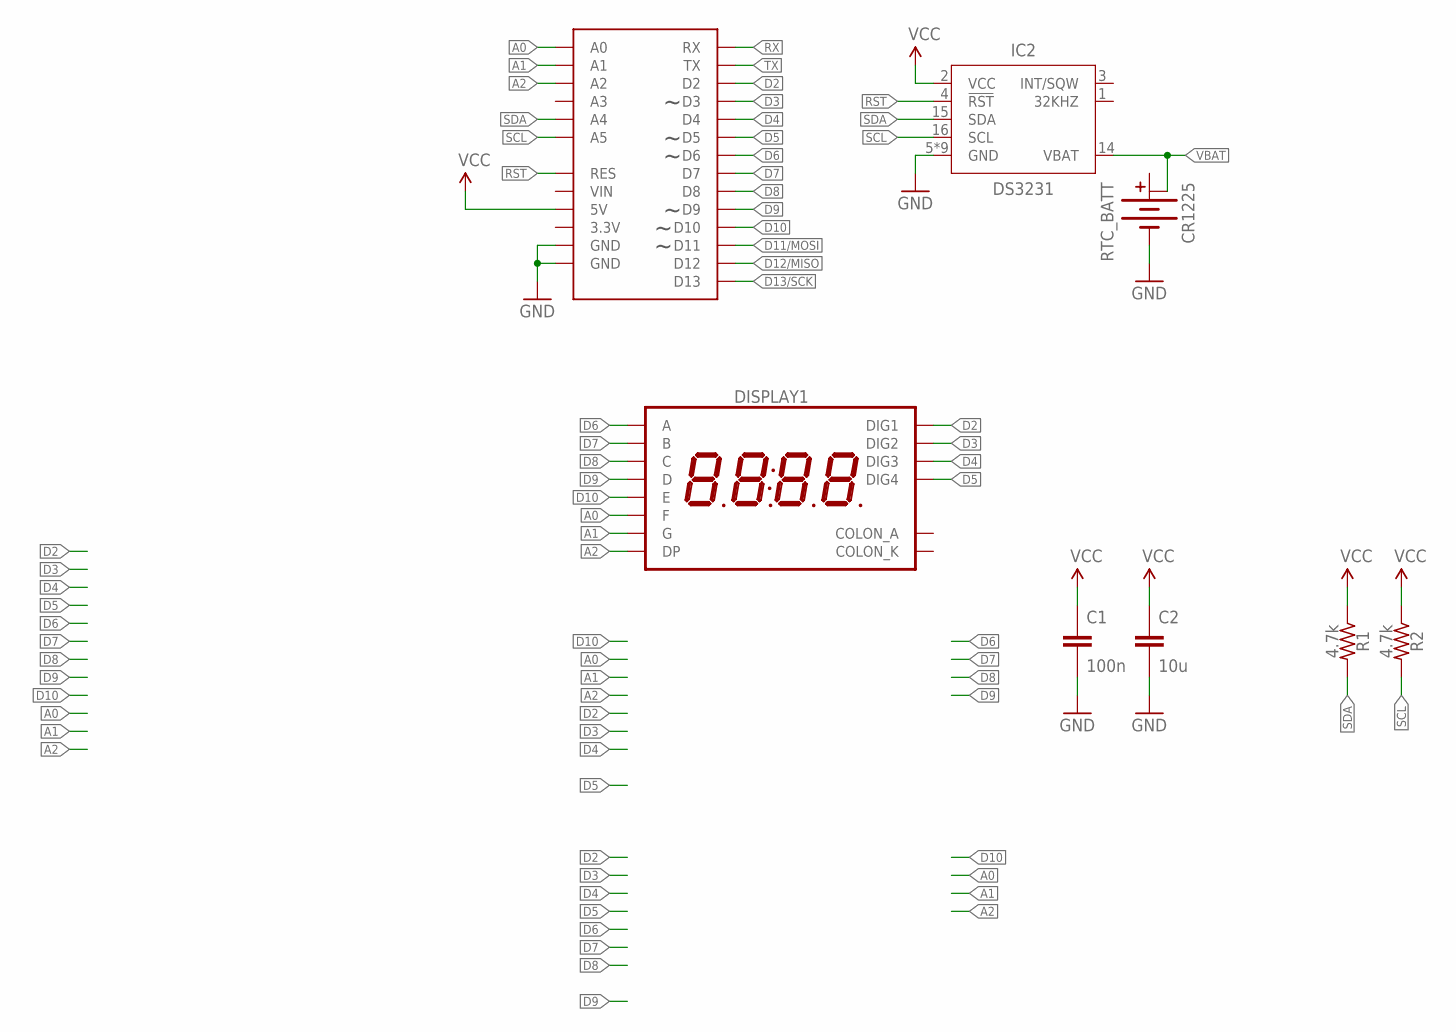
[picture p18: schematic tick-shield-mk-2.0.sch]

Parts:
C1: 100n; C025-024X044
C2: 10u; C050-025X075
DISPLAY1: 7SEG_4DIGIT_COLONTICK; 7SEG_4DIG_TICK
IC2: DS3231; SO16W
R1, R2: 4.7k; RESISTOR-AXIAL-PTH-7.62MM
RTC_BATT: CR1225; BATTCON_12MM_PTH3
U$1: ARDUINO_SHIELD_SMALLER; ARDUINO_SHIELD_NOOUTLINE_INSIDE_SMALLER

Connections:
A0: DISPLAY1.P$12 (F), U$1.A0
A1: DISPLAY1.P$5 (G), U$1.A1
A2: DISPLAY1.P$3 (DP), U$1.A2
D2: DISPLAY1.P$14 (DIG1), U$1.D2
D3: DISPLAY1.P$11 (DIG2), U$1.D3
D4: DISPLAY1.P$10 (DIG3), U$1.D4
D5: DISPLAY1.P$6 (DIG4), U$1.D5
D6: DISPLAY1.P$13 (A), U$1.D6
D7: DISPLAY1.P$9 (B), U$1.D7
D8: DISPLAY1.P$4 (C), U$1.D8
D9: DISPLAY1.P$2 (D), U$1.D9
D10: DISPLAY1.P$1 (E), U$1.D10
D11/MOSI: U$1.D11
D12/MISO: U$1.D12
D13/SCK: U$1.D13
GND: C1.2, C2.2, IC2.5 (GND), IC2.6 (GND), IC2.7 (GND), IC2.8 (GND), IC2.9 (GND), IC2.10 (GND), IC2.11 (GND), IC2.12 (GND), IC2.13 (GND), RTC_BATT.-, U$1.GND@0 (GND), U$1.GND@1 (GND)
RST: IC2.4 (!RST), U$1.RES
RX: U$1.RX
SCL: IC2.16 (SCL), R2.P$2 (2), U$1.A5
SDA: IC2.15 (SDA), R1.P$2 (2), U$1.A4
TX: U$1.TX
VBAT: IC2.14 (VBAT), RTC_BATT.+@3 (+1), RTC_BATT.+@4 (+1)
VCC: C1.1, C2.1, IC2.2 (VCC), R1.P$1 (1), R2.P$1 (1), U$1.5V

Board: 2 copper layers, 12 parts (2 on the bottom side), 18 nets, no tracks yet.

Other parts of the board:
U$3, U$4: CC-BY-SA-4.0-NO-URL
U$7, U$8: OSHWLOGO_TOP_0.2_A
