seancaulfield/tick/hardware/tick-mini-shield-mk-1.0.brd

## EAGLE design hardware/tick-mini-shield-mk-1.0.brd (2015-08-10)

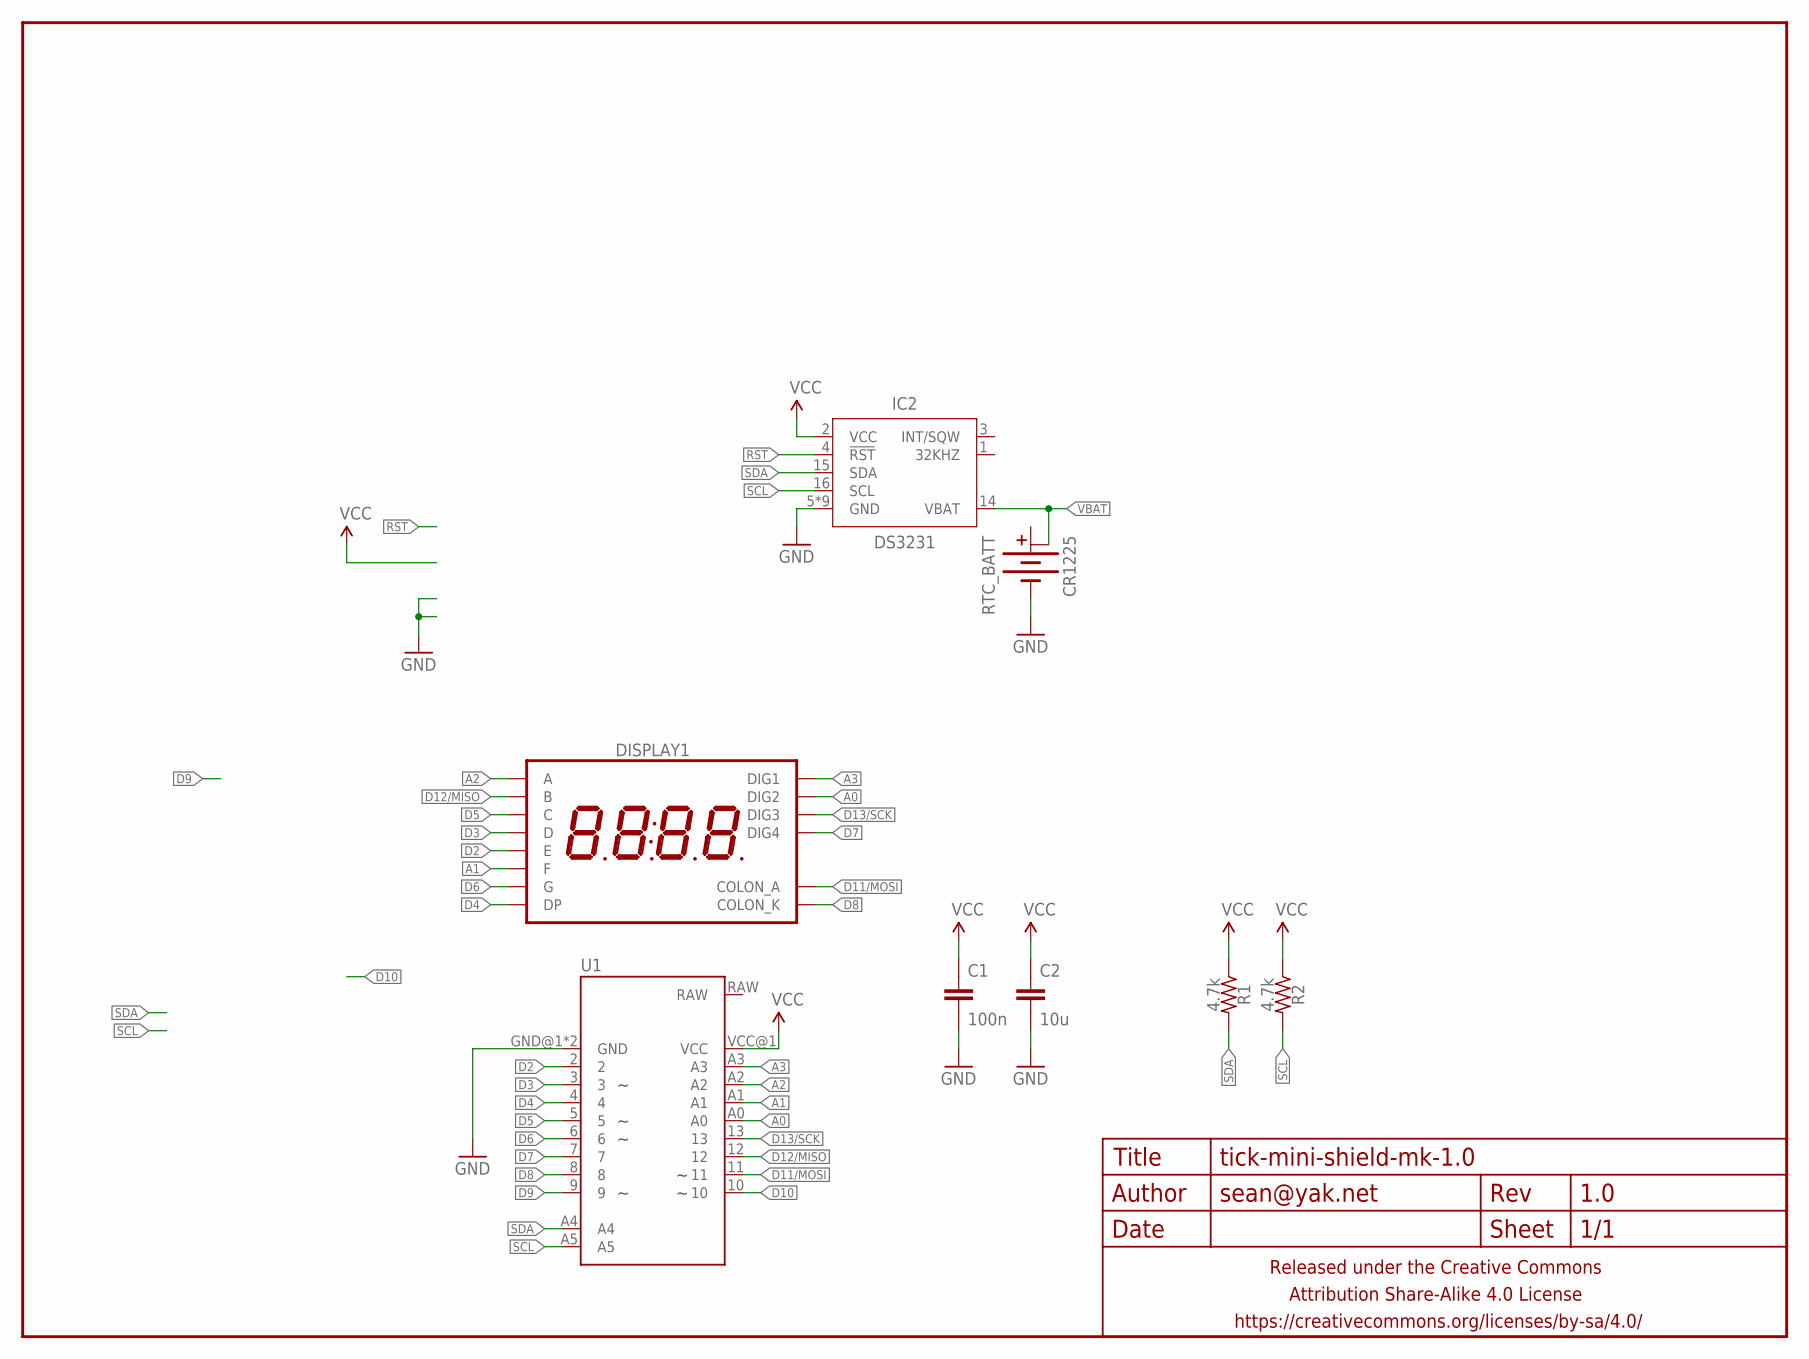
[picture p19: schematic tick-mini-shield-mk-1.0.sch]

Parts:
C1: 100n; C025-024X044
C2: 10u; C050-025X075
DISPLAY1: 7SEG_4DIGIT_COLONTICK; 7SEG_4DIG_TICK
FRAME1: FRAME-LETTERNO_PACKAGE; DUMMY
IC2: DS3231; SO16W
R1, R2: 4.7k; RESISTOR-AXIAL-PTH-7.62MM
RTC_BATT: CR1225; BATTCON_12MM_PTH3
U1: ARDUINO_PRO_MINI_TICK2

Connections:
A0: DISPLAY1.P$11 (DIG2), U1.A0
A1: DISPLAY1.P$12 (F), U1.A1
A2: DISPLAY1.P$13 (A), U1.A2
A3: DISPLAY1.P$14 (DIG1), U1.A3
D2: DISPLAY1.P$1 (E), U1.2
D3: DISPLAY1.P$2 (D), U1.3
D4: DISPLAY1.P$3 (DP), U1.4
D5: DISPLAY1.P$4 (C), U1.5
D6: DISPLAY1.P$5 (G), U1.6
D7: DISPLAY1.P$6 (DIG4), U1.7
D8: DISPLAY1.P$7 (COLON_K), U1.8
D9: U1.9
D10: U1.10
D11/MOSI: DISPLAY1.P$8 (COLON_A), U1.11
D12/MISO: DISPLAY1.P$9 (B), U1.12
D13/SCK: DISPLAY1.P$10 (DIG3), U1.13
GND: C1.2, C2.2, IC2.5 (GND), IC2.6 (GND), IC2.7 (GND), IC2.8 (GND), IC2.9 (GND), IC2.10 (GND), IC2.11 (GND), IC2.12 (GND), IC2.13 (GND), RTC_BATT.-, U1.GND@1 (GND), U1.GND@2 (GND)
RST: IC2.4 (!RST)
SCL: IC2.16 (SCL), R2.P$2 (2), U1.A5
SDA: IC2.15 (SDA), R1.P$2 (2), U1.A4
VBAT: IC2.14 (VBAT), RTC_BATT.+@3 (+1), RTC_BATT.+@4 (+1)
VCC: C1.1, C2.1, IC2.2 (VCC), R1.P$1 (1), R2.P$1 (1), U1.VCC@1 (VCC)

Board: 2 copper layers, 12 parts (5 on the bottom side), 19 nets, no tracks yet.

Other parts of the board:
U$4: CC-BY-SA-4.0-NO-URL
U$7, U$8: OSHWLOGO_TOP_0.2_A
