seancaulfield/tick/hardware/tick-mini-mk-4.2.brd

## EAGLE design hardware/tick-mini-mk-4.2.brd (2015-08-10)

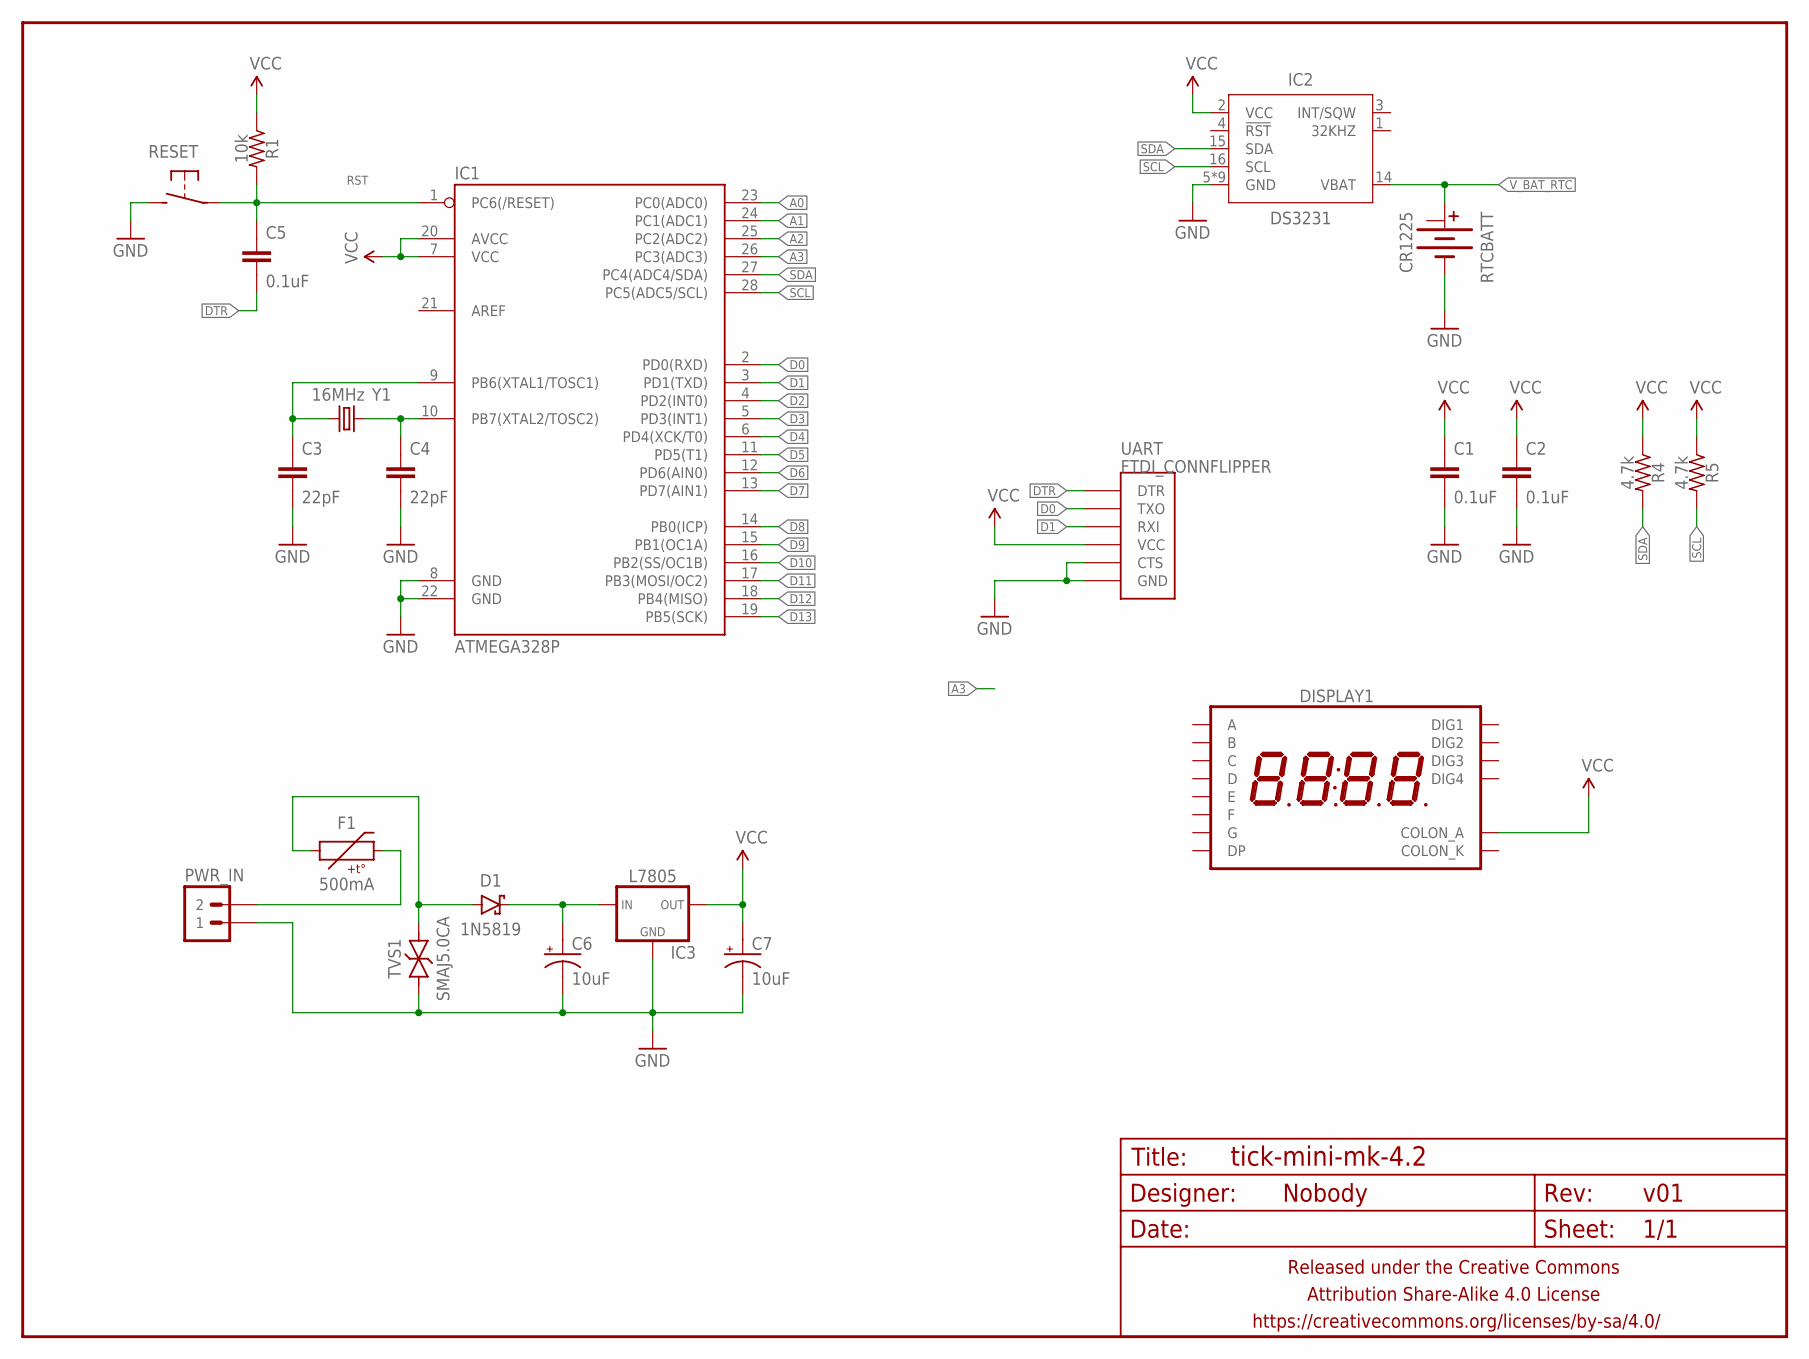
[picture p20: schematic tick-mini-mk-4.2.sch]

Parts:
C1, C2, C5: 0.1uF; C025-024X044
C3, C4: 22pF; C025-024X044
C6, C7: 10uF; E2-5
D1: 1N5819; DIODE-10.16MM
DISPLAY1: 7SEG_4DIGIT_COLON14.2MM-CC-NS; 7SEG_4DIG_NS
F1: 500mA; PTC-PTH-5.08MM
FRAME1: FRAME-LETTERNO_PACKAGE; DUMMY
IC1: ATMEGA328P; DIL28-3
IC2: DS3231; SO16W
IC3: L7805; TO-92-AMMO
PWR_IN: M02JST-PTH-RA-R+; JST-2-PH-RA-PTH-R+
R1: 10k; RESISTOR-AXIAL-PTH-5.08MM
R4, R5: 4.7k; RESISTOR-AXIAL-PTH-5.08MM
RESET: SPST-NO-TACT3MM-PTH-SMALL-PADS; DTS-3-SMALL-PADS
RTCBATT: CR1225; BATTCON_12MM_SMD
TVS1: SMAJ5.0CA; DO-41-TVS-BI-10.16MM
UART: FTDI_CONNFLIPPER; FTDI_CONN_FLIP
Y1: 16MHz; HC49U-V

Connections:
A0: IC1.23 (PC0(ADC0))
A1: IC1.24 (PC1(ADC1))
A2: IC1.25 (PC2(ADC2))
A3: IC1.26 (PC3(ADC3))
D0: IC1.2 (PD0(RXD)), UART.TXO
D1: IC1.3 (PD1(TXD)), UART.RXI
D2: IC1.4 (PD2(INT0))
D3: IC1.5 (PD3(INT1))
D4: IC1.6 (PD4(XCK/T0))
D5: IC1.11 (PD5(T1))
D6: IC1.12 (PD6(AIN0))
D7: IC1.13 (PD7(AIN1))
D8: IC1.14 (PB0(ICP))
D9: IC1.15 (PB1(OC1A))
D10: IC1.16 (PB2(SS/OC1B))
D11: IC1.17 (PB3(MOSI/OC2))
D12: IC1.18 (PB4(MISO))
D13: IC1.19 (PB5(SCK))
DTR: C5.2, UART.DTR
GND: C1.2, C2.2, C3.2, C4.2, C6.-, C7.-, IC1.8 (GND), IC1.22 (GND), IC2.5 (GND), IC2.6 (GND), IC2.7 (GND), IC2.8 (GND), IC2.9 (GND), IC2.10 (GND), IC2.11 (GND), IC2.12 (GND), IC2.13 (GND), IC3.2 (GND), PWR_IN.1, RESET.2, RTCBATT.-, TVS1.P$1 (1), UART.CTS, UART.GND
unnamed: C4.1, IC1.10 (PB7(XTAL2/TOSC2)), Y1.1
unnamed: C3.1, IC1.9 (PB6(XTAL1/TOSC1)), Y1.2
unnamed: D1.A, F1.P$1 (1), TVS1.P$2 (2)
unnamed: F1.P$2 (2), PWR_IN.2
unnamed: C6.+, D1.C, IC3.1 (IN)
RST: C5.1, IC1.1 (PC6(/RESET)), R1.P$2 (2), RESET.1
SCL: IC1.28 (PC5(ADC5/SCL)), IC2.16 (SCL), R5.P$2 (2)
SDA: IC1.27 (PC4(ADC4/SDA)), IC2.15 (SDA), R4.P$2 (2)
VCC: C1.1, C2.1, C7.+, DISPLAY1.P$8 (COLON_A), IC1.7 (VCC), IC1.20 (AVCC), IC2.2 (VCC), IC3.3 (OUT), R1.P$1 (1), R4.P$1 (1), R5.P$1 (1), UART.VCC
V_BAT_RTC: IC2.14 (VBAT), RTCBATT.+@1 (+)

Board: 2 copper layers, 28 parts (4 on the bottom side), 14 nets, no tracks yet.

Other parts of the board:
U$1, U$5: CC-BY-SA-4.0-NO-URL
U$2, U$4: COW_SMALL_METAL_NOTEXT
U$3: OSHWLOGO_TOP_0.2
