seancaulfield/tick/hardware/tick-tiny-mk-2.0.brd

## EAGLE design hardware/tick-tiny-mk-2.0.brd (2015-08-10)

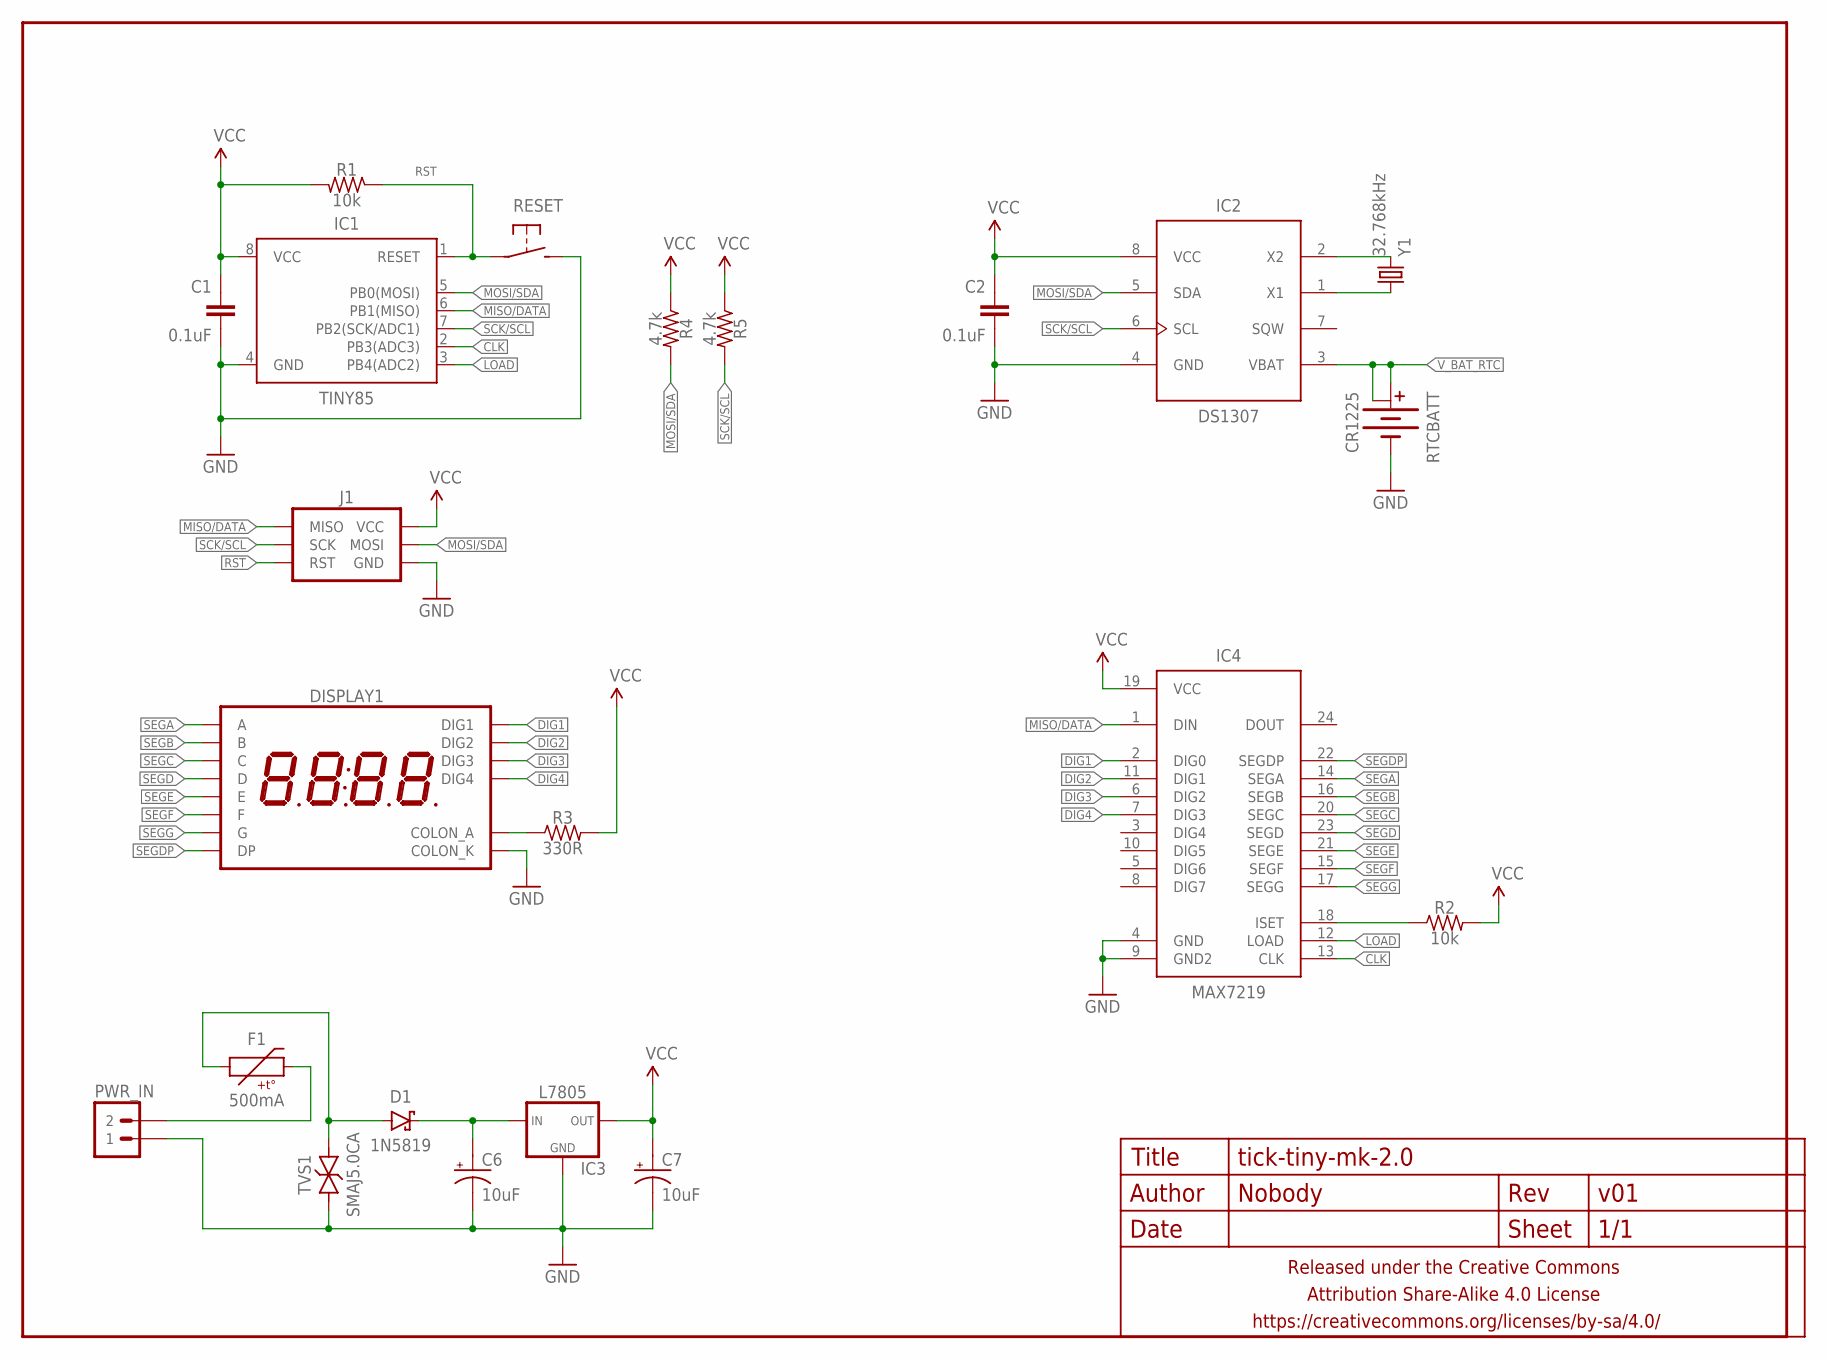
[picture p21: schematic tick-tiny-mk-2.0.sch]

Parts:
C1, C2: 0.1uF; C025-024X044
C6, C7: 10uF; E2-5
D1: 1N5819; DIODE-10.16MM
DISPLAY1: 7SEG_4DIGIT_COLON14.2MM-CC-NS; 7SEG_4DIG_NS
F1: 500mA; PTC-PTH-5.08MM
FRAME1: FRAME-LETTERNO_PACKAGE; DUMMY
IC1: TINY85; DIP08
IC2: DS1307; DIL08
IC3: L7805; TO-92-AMMO
IC4: MAX7219; SO24W
J1: AVR_SPI_PRG_6PTH; 2X3
PWR_IN: M02JST-PTH-RA-R+; JST-2-PH-RA-PTH-R+
R1: 10k; RESISTOR-AXIAL-PTH-7.62MM
R2: 10k; RESISTOR-AXIAL-PTH-5.08MM
R3: 330R; RESISTOR-AXIAL-PTH-5.08MM
R4, R5: 4.7k; RESISTOR-AXIAL-PTH-7.62MM
RESET: SPST-NO-TACT3MM-PTH-SMALL-PADS; DTS-3-SMALL-PADS
RTCBATT: CR1225; BATTCON_12MM_SMD
TVS1: SMAJ5.0CA; DO-41-TVS-BI-10.16MM
Y1: 32.768kHz; TC26H

Connections:
CLK: IC1.2 (PB3(ADC3)), IC4.13 (CLK)
DIG1: DISPLAY1.P$14 (DIG1), IC4.2 (DIG0)
DIG2: DISPLAY1.P$11 (DIG2), IC4.11 (DIG1)
DIG3: DISPLAY1.P$10 (DIG3), IC4.6 (DIG2)
DIG4: DISPLAY1.P$6 (DIG4), IC4.7 (DIG3)
GND: C1.2, C2.2, C6.-, C7.-, DISPLAY1.P$7 (COLON_K), IC1.4 (GND), IC2.4 (GND), IC3.2 (GND), IC4.4 (GND), IC4.9 (GND2), J1.6 (GND), PWR_IN.1, RESET.2, RTCBATT.-, TVS1.P$1 (1)
LOAD: IC1.3 (PB4(ADC2)), IC4.12 (LOAD)
MISO/DATA: IC1.6 (PB1(MISO)), IC4.1 (DIN), J1.1 (MISO)
MOSI/SDA: IC1.5 (PB0(MOSI)), IC2.5 (SDA), J1.4 (MOSI), R4.P$2 (2)
unnamed: IC2.2 (X2), Y1.2
unnamed: IC2.1 (X1), Y1.1
unnamed: D1.A, F1.P$1 (1), TVS1.P$2 (2)
unnamed: IC4.18 (ISET), R2.P$1 (1)
unnamed: F1.P$2 (2), PWR_IN.2
unnamed: DISPLAY1.P$8 (COLON_A), R3.P$1 (1)
unnamed: C6.+, D1.C, IC3.1 (IN)
RST: IC1.1 (RESET), J1.5 (RST), R1.P$1 (1), RESET.1
SCK/SCL: IC1.7 (PB2(SCK/ADC1)), IC2.6 (SCL), J1.3 (SCK), R5.P$2 (2)
SEGA: DISPLAY1.P$13 (A), IC4.14 (SEGA)
SEGB: DISPLAY1.P$9 (B), IC4.16 (SEGB)
SEGC: DISPLAY1.P$4 (C), IC4.20 (SEGC)
SEGD: DISPLAY1.P$2 (D), IC4.23 (SEGD)
SEGDP: DISPLAY1.P$3 (DP), IC4.22 (SEGDP)
SEGE: DISPLAY1.P$1 (E), IC4.21 (SEGE)
SEGF: DISPLAY1.P$12 (F), IC4.15 (SEGF)
SEGG: DISPLAY1.P$5 (G), IC4.17 (SEGG)
VCC: C1.1, C2.1, C7.+, IC1.8 (VCC), IC2.8 (VCC), IC3.3 (OUT), IC4.19 (VCC), J1.2 (VCC), R1.P$2 (2), R2.P$2 (2), R3.P$2 (2), R4.P$1 (1), R5.P$1 (1)
V_BAT_RTC: IC2.3 (VBAT), RTCBATT.+@1 (+), RTCBATT.+@2 (+1)

Board: 2 copper layers, 28 parts (4 on the bottom side), 28 nets, no tracks yet.

Other parts of the board:
U$1, U$5: CC-BY-SA-4.0-NO-URL
U$2, U$4: COW_SMALL_METAL_NOTEXT
U$3: OSHWLOGO_TOP_0.2
