seancaulfield/tick/hardware/tick-ds3231-breakout-mk-2.1.brd

## EAGLE design hardware/tick-ds3231-breakout-mk-2.1.brd (2015-08-10)

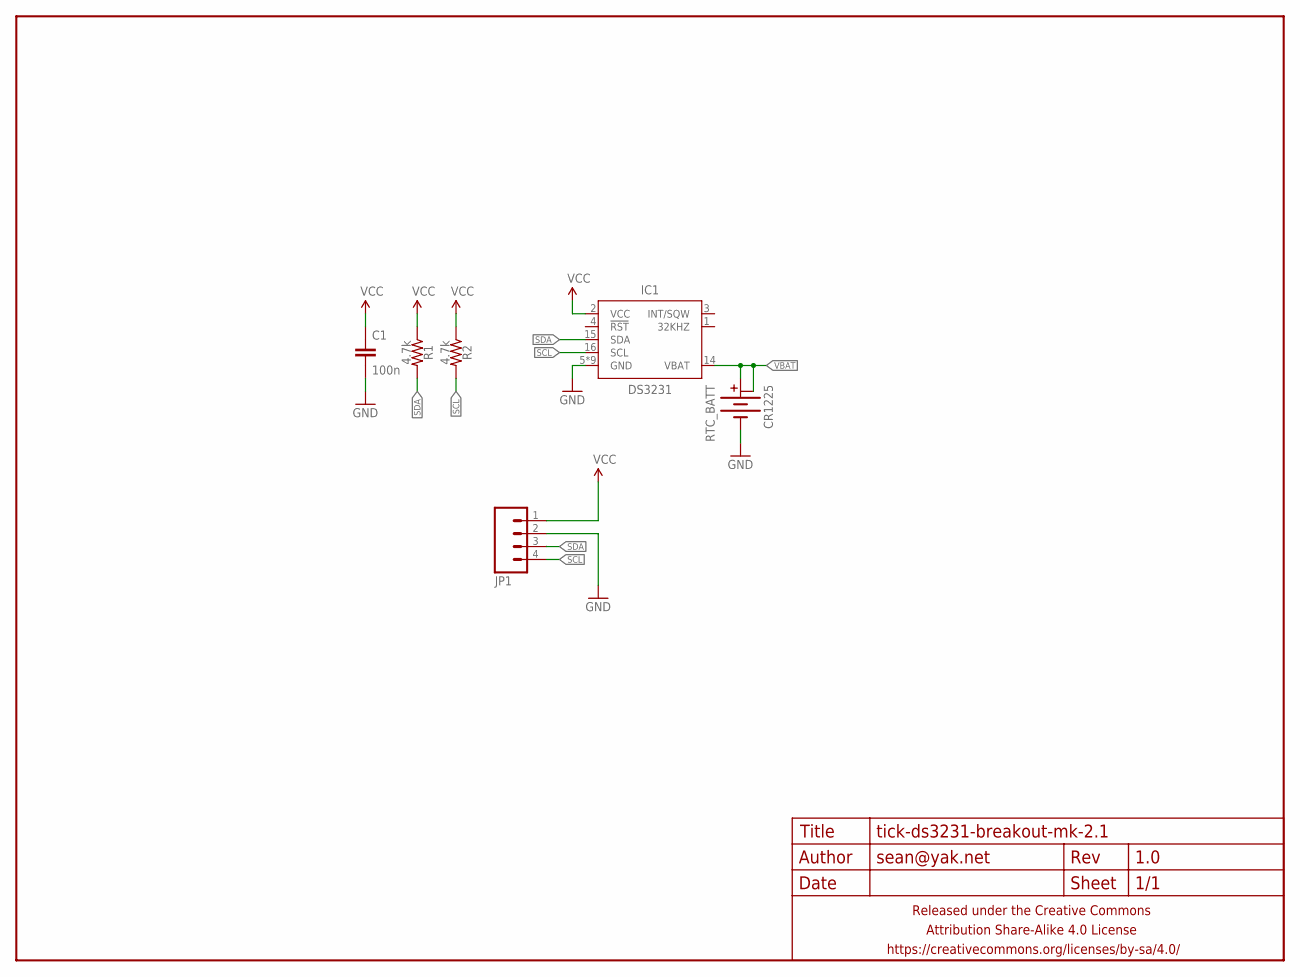
[picture p22: schematic tick-ds3231-breakout-mk-2.1.sch]

Parts:
C1: 100n; C0805
FRAME1: FRAME-LETTERNO_PACKAGE; DUMMY
IC1: DS3231; SO16W
JP1: M04PTH; 1X04-PTH-VERT
R1, R2: 4.7k; R0805
RTC_BATT: CR1225; BATTCON_12MM_SMD

Connections:
GND: C1.2, IC1.5 (GND), IC1.6 (GND), IC1.7 (GND), IC1.8 (GND), IC1.9 (GND), IC1.10 (GND), IC1.11 (GND), IC1.12 (GND), IC1.13 (GND), JP1.2, RTC_BATT.-
SCL: IC1.16 (SCL), JP1.4, R2.2
SDA: IC1.15 (SDA), JP1.3, R1.2
VBAT: IC1.14 (VBAT), RTC_BATT.+@1 (+), RTC_BATT.+@2 (+1)
VCC: C1.1, IC1.2 (VCC), JP1.1, R1.1, R2.1

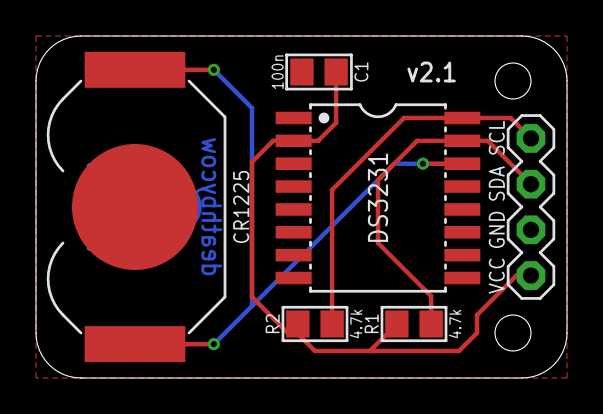
[picture p23: board tick-ds3231-breakout-mk-2.1.brd from above]

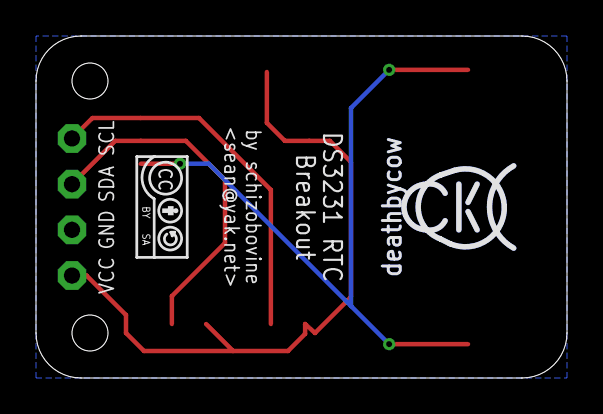
[picture p24: board tick-ds3231-breakout-mk-2.1.brd from below]

Board: 2 copper layers, 29.5 x 19.0 mm, 9 parts (2 on the bottom side), 5 nets.

Other parts of the board:
U$1: COW_SMALL_METAL
U$2: CC-BY-SA-4.0-NO-URL
