seancaulfield/tick/hardware/tick-ds3231-breakout-mk-2.0.brd

## EAGLE design hardware/tick-ds3231-breakout-mk-2.0.brd (2015-08-10)

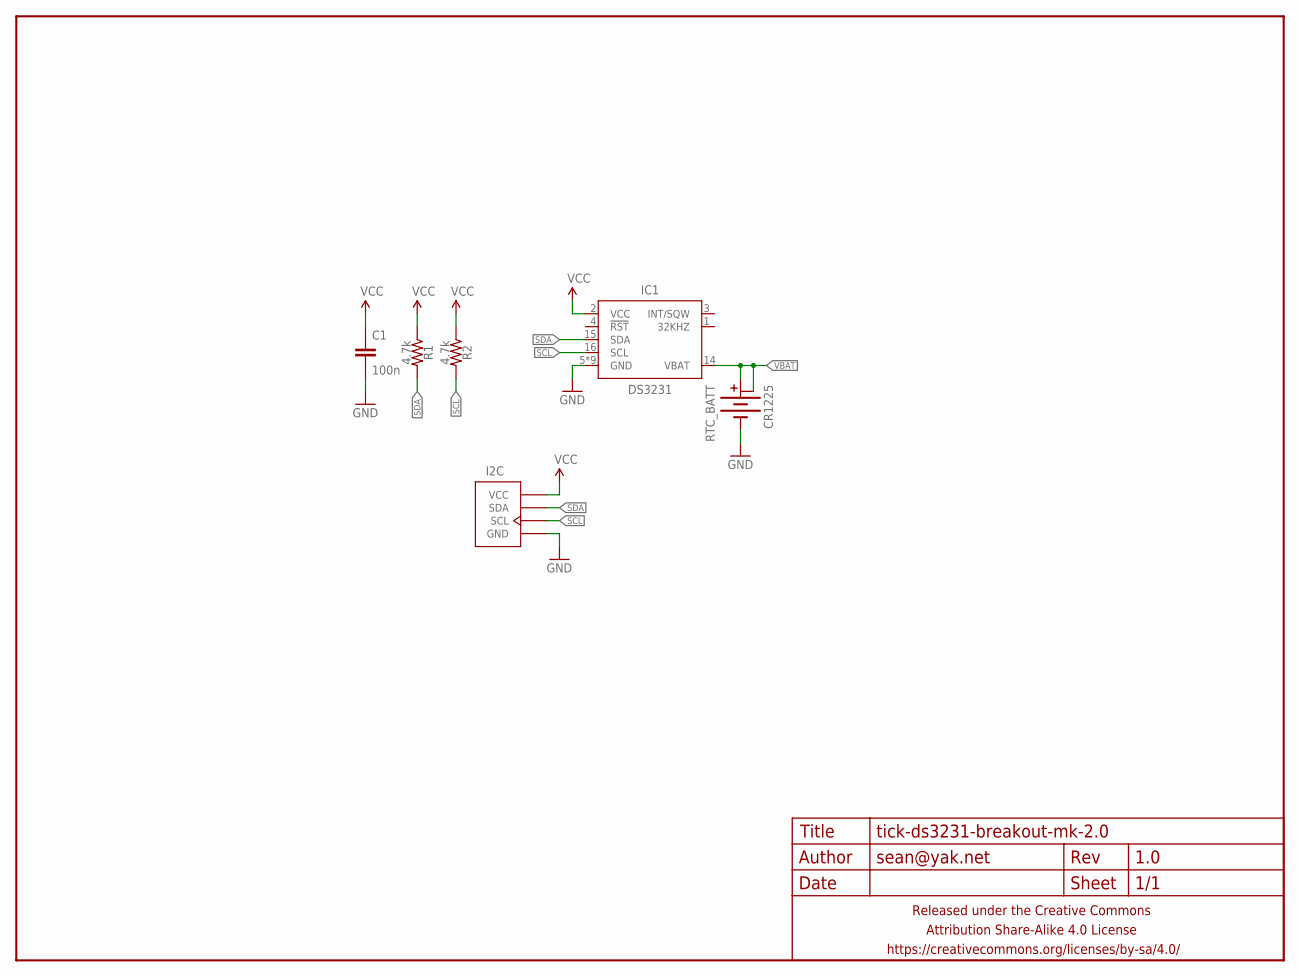
[picture p25: schematic tick-ds3231-breakout-mk-2.0.sch]

Parts:
C1: 100n; C0805
FRAME1: FRAME-LETTERNO_PACKAGE; DUMMY
I2C: M04-I2CPTH-0.1IN-CENTERED; 1X04-PTH-VERT-I2C-CENTERED
IC1: DS3231; SO16W
R1, R2: 4.7k; R0805
RTC_BATT: CR1225; BATTCON_12MM_SMD

Connections:
GND: C1.2, I2C.GND, IC1.5 (GND), IC1.6 (GND), IC1.7 (GND), IC1.8 (GND), IC1.9 (GND), IC1.10 (GND), IC1.11 (GND), IC1.12 (GND), IC1.13 (GND), RTC_BATT.-
SCL: I2C.SCL, IC1.16 (SCL), R2.2
SDA: I2C.SDA, IC1.15 (SDA), R1.2
VBAT: IC1.14 (VBAT), RTC_BATT.+@1 (+), RTC_BATT.+@2 (+1)
VCC: C1.1, I2C.VCC, IC1.2 (VCC), R1.1, R2.1

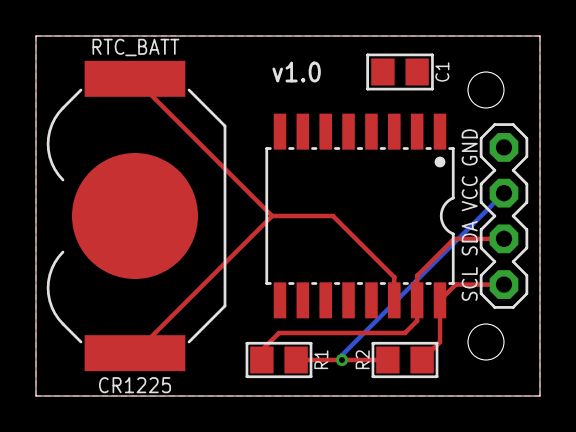
[picture p26: board tick-ds3231-breakout-mk-2.0.brd from above]

Board: 2 copper layers, 28.0 x 20.0 mm, 7 parts (0 on the bottom side), 5 nets.
