seancaulfield/tick/hardware/tick-mk-5.0.1.brd

## EAGLE design hardware/tick-mk-5.0.1.brd (2015-07-18)

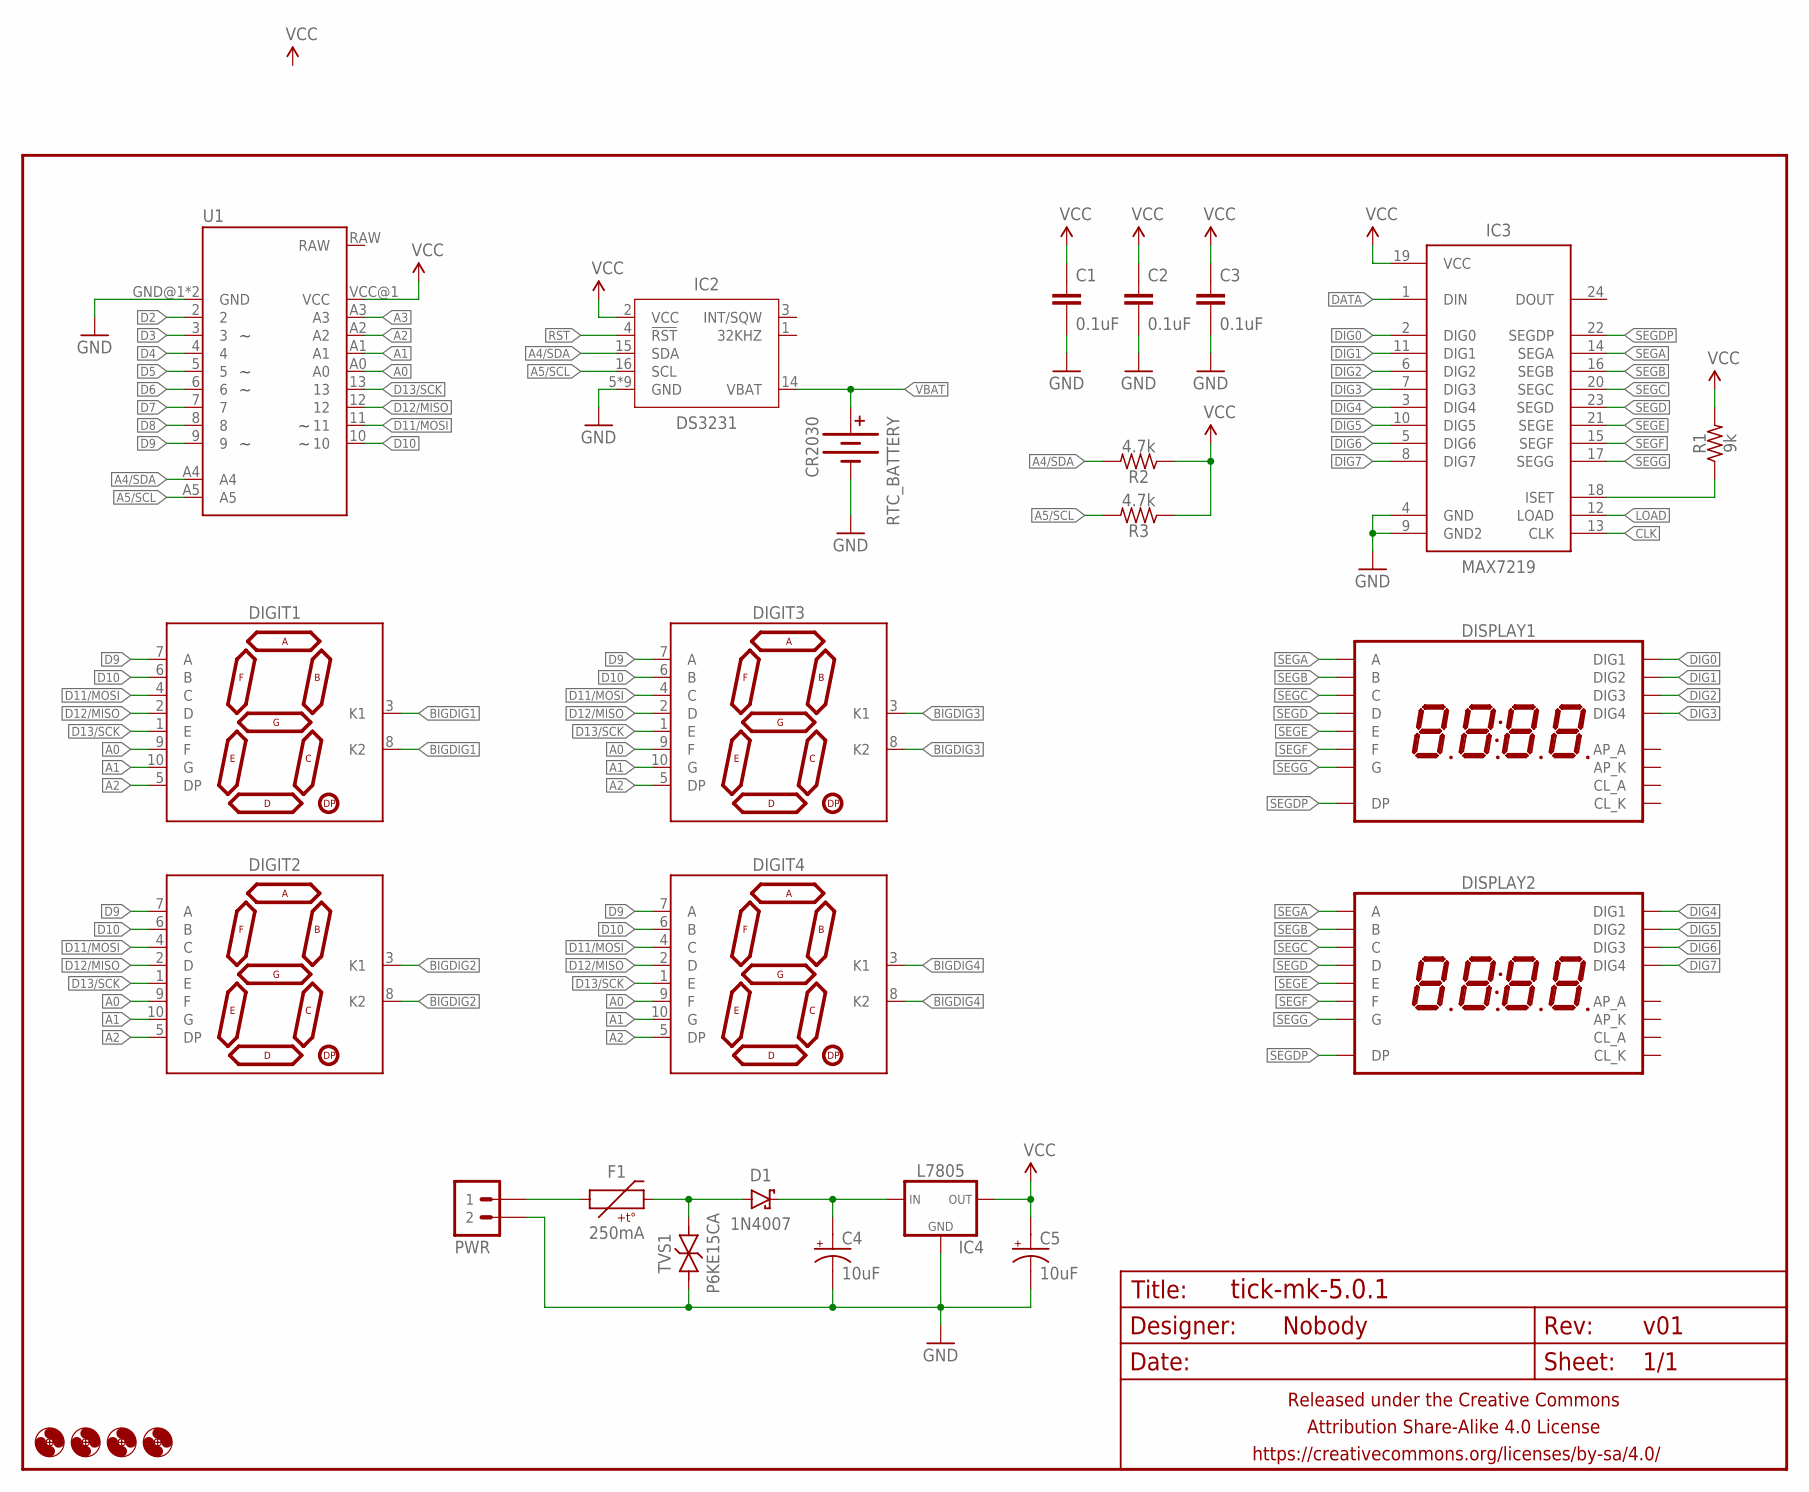
[picture p27: schematic tick-mk-5.0.1.sch]

Parts:
C1, C2: 0.1uF; C025-024X044
C3: 0.1uF; C0603
C4, C5: 10uF; E2-5
D1: 1N4007; DIODE-10.16MM
DIGIT1, DIGIT2, DIGIT3, DIGIT4: 7SEG_1DIGPTH-25.4MM-BARE; 7SEG_1DIG_25.4MM_NOSILK
DISPLAY1, DISPLAY2: 7SEG_4DIGIT_COLON_APOS; 7SEG_4DIG_10MM
F1: 250mA; PTC-PTH-5.08MM
FRAME1: FRAME-LETTERNO_PACKAGE; DUMMY
H1, H2, H3, H4: HOLE2,5; 2,5
IC2: DS3231; SO16W
IC3: MAX7219; SO24W
IC4: L7805; TO220-IGO-THERMPAD
PWR: M02JST-PTH-RA-L+; JST-2-PH-RA-PTH-L+
R1: 9k; R0603
R2, R3: 4.7k; RESISTOR-AXIAL-PTH-6.35MM
RTC_BATTERY: CR2030; BATTCON_20MM_MINE_STAHPIT
TVS1: P6KE15CA; DO-41-TVS-BI-10.16MM
U1: ARDUINO_PRO_MINI_TICK2

Connections:
A0: DIGIT1.9 (F), DIGIT2.9 (F), DIGIT3.9 (F), DIGIT4.9 (F), U1.A0
A1: DIGIT1.10 (G), DIGIT2.10 (G), DIGIT3.10 (G), DIGIT4.10 (G), U1.A1
A2: DIGIT1.5 (DP), DIGIT2.5 (DP), DIGIT3.5 (DP), DIGIT4.5 (DP), U1.A2
A3: U1.A3
A4/SDA: IC2.15 (SDA), R2.P$2 (2), U1.A4
A5/SCL: IC2.16 (SCL), R3.P$2 (2), U1.A5
BIGDIG1: DIGIT1.3 (K1), DIGIT1.8 (K2)
BIGDIG2: DIGIT2.3 (K1), DIGIT2.8 (K2)
BIGDIG3: DIGIT3.3 (K1), DIGIT3.8 (K2)
BIGDIG4: DIGIT4.3 (K1), DIGIT4.8 (K2)
CLK: IC3.13 (CLK)
D2: U1.2
D3: U1.3
D4: U1.4
D5: U1.5
D6: U1.6
D7: U1.7
D8: U1.8
D9: DIGIT1.7 (A), DIGIT2.7 (A), DIGIT3.7 (A), DIGIT4.7 (A), U1.9
D10: DIGIT1.6 (B), DIGIT2.6 (B), DIGIT3.6 (B), DIGIT4.6 (B), U1.10
D11/MOSI: DIGIT1.4 (C), DIGIT2.4 (C), DIGIT3.4 (C), DIGIT4.4 (C), U1.11
D12/MISO: DIGIT1.2 (D), DIGIT2.2 (D), DIGIT3.2 (D), DIGIT4.2 (D), U1.12
D13/SCK: DIGIT1.1 (E), DIGIT2.1 (E), DIGIT3.1 (E), DIGIT4.1 (E), U1.13
DATA: IC3.1 (DIN)
DIG0: DISPLAY1.1 (DIG1), IC3.2 (DIG0)
DIG1: DISPLAY1.2 (DIG2), IC3.11 (DIG1)
DIG2: DISPLAY1.6 (DIG3), IC3.6 (DIG2)
DIG3: DISPLAY1.8 (DIG4), IC3.7 (DIG3)
DIG4: DISPLAY2.1 (DIG1), IC3.3 (DIG4)
DIG5: DISPLAY2.2 (DIG2), IC3.10 (DIG5)
DIG6: DISPLAY2.6 (DIG3), IC3.5 (DIG6)
DIG7: DISPLAY2.8 (DIG4), IC3.8 (DIG7)
GND: C1.2, C2.2, C3.2, C4.-, C5.-, IC2.5 (GND), IC2.6 (GND), IC2.7 (GND), IC2.8 (GND), IC2.9 (GND), IC2.10 (GND), IC2.11 (GND), IC2.12 (GND), IC2.13 (GND), IC3.4 (GND), IC3.9 (GND2), IC4.4 (GND), IC4.GND, PWR.2, RTC_BATTERY.BOTTOM (-), TVS1.P$1 (1), U1.GND@1 (GND), U1.GND@2 (GND)
LOAD: IC3.12 (LOAD)
unnamed: D1.A, F1.P$2 (2), TVS1.P$2 (2)
unnamed: IC3.18 (ISET), R1.1
unnamed: F1.P$1 (1), PWR.1
unnamed: C4.+, D1.C, IC4.IN
RST: IC2.4 (!RST)
SEGA: DISPLAY1.14 (A), DISPLAY2.14 (A), IC3.14 (SEGA)
SEGB: DISPLAY1.16 (B), DISPLAY2.16 (B), IC3.16 (SEGB)
SEGC: DISPLAY1.13 (C), DISPLAY2.13 (C), IC3.20 (SEGC)
SEGD: DISPLAY1.3 (D), DISPLAY2.3 (D), IC3.23 (SEGD)
SEGDP: DISPLAY1.7 (DP), DISPLAY2.7 (DP), IC3.22 (SEGDP)
SEGE: DISPLAY1.5 (E), DISPLAY2.5 (E), IC3.21 (SEGE)
SEGF: DISPLAY1.11 (F), DISPLAY2.11 (F), IC3.15 (SEGF)
SEGG: DISPLAY1.15 (G), DISPLAY2.15 (G), IC3.17 (SEGG)
VBAT: IC2.14 (VBAT), RTC_BATTERY.TOP@1 (+), RTC_BATTERY.TOP@2 (+)
VCC: C1.1, C2.1, C3.1, C5.+, IC2.2 (VCC), IC3.19 (VCC), IC4.OUT, R1.2, R2.P$1 (1), R3.P$1 (1), U1.VCC@1 (VCC)

Board: 2 copper layers, 29 parts (7 on the bottom side), 37 nets, no tracks yet.

Other parts of the board:
U$1: TICK_SYMBOL
