seancaulfield/tick/hardware/tick-mk-4.6.6.brd

## EAGLE design hardware/tick-mk-4.6.6.brd (2015-07-18)

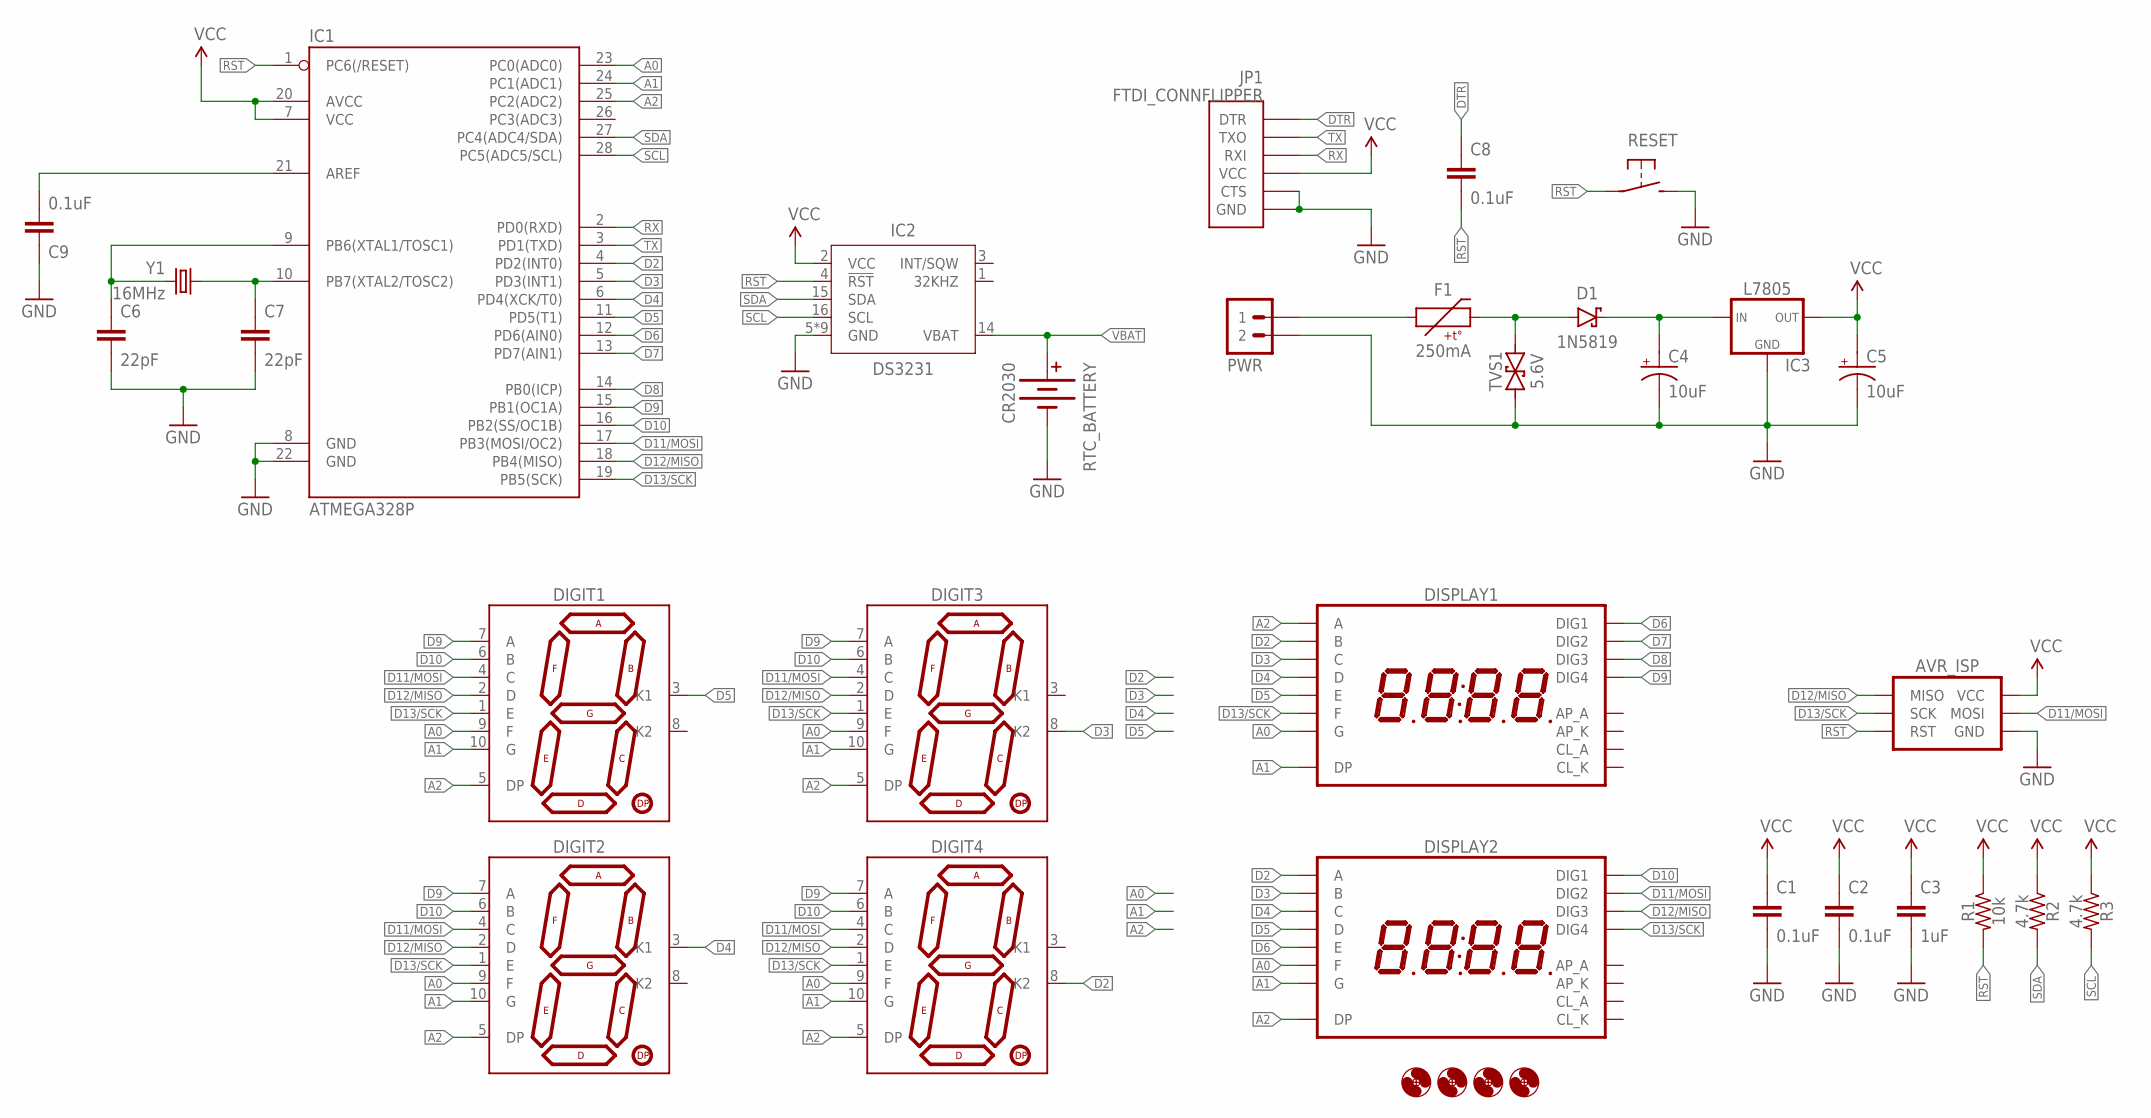
[picture p28: schematic tick-mk-4.6.6.sch]

Parts:
AVR_ISP: AVR_SPI_PRG_6PTH; 2X3
C1, C2, C8, C9: 0.1uF; C025-024X044
C3: 1uF; C025-024X044
C4, C5: 10uF; E2-5
C6, C7: 22pF; C025-024X044
D1: 1N5819; DIODE-10.16MM
DIGIT1, DIGIT2, DIGIT3, DIGIT4: 7SEG_1DIGPTH-25.4MM-BARE; 7SEG_1DIG_25.4MM_NOSILK
DISPLAY1, DISPLAY2: 7SEG_4DIGIT_COLON_APOS; 7SEG_4DIG_10MM
F1: 250mA; PTC-PTH-5.08MM
H1, H2, H3, H4: HOLE#2; HOLE-#2
IC1: ATMEGA328P; DIL28-3
IC2: DS3231; SO16W
IC3: L7805; TO220-IGO-THERMPAD
JP1: FTDI_CONNFLIPPER; FTDI_CONN_FLIP
PWR: M02JST-PTH-VERT; JST-2-PH-VERT-PTH
R1: 10k; RESISTOR-AXIAL-PTH-7.62MM
R2, R3: 4.7k; RESISTOR-AXIAL-PTH-6.35MM
RESET: SPST-NO-TACT6MM-PTH-SMALL-PADS; DTS-6-SMALL-PADS
RTC_BATTERY: CR2030; BATTCON_20MM_MINE
TVS1: 5.6V; DO-41-TVS-BI-10.16MM
Y1: 16MHz; HC49U-V

Connections:
A0: DIGIT1.9 (F), DIGIT2.9 (F), DIGIT3.9 (F), DIGIT4.9 (F), DISPLAY1.15 (G), DISPLAY2.11 (F), IC1.23 (PC0(ADC0))
A1: DIGIT1.10 (G), DIGIT2.10 (G), DIGIT3.10 (G), DIGIT4.10 (G), DISPLAY1.7 (DP), DISPLAY2.15 (G), IC1.24 (PC1(ADC1))
A2: DIGIT1.5 (DP), DIGIT2.5 (DP), DIGIT3.5 (DP), DIGIT4.5 (DP), DISPLAY1.14 (A), DISPLAY2.7 (DP), IC1.25 (PC2(ADC2))
D2: DIGIT4.8 (K2), DISPLAY1.16 (B), DISPLAY2.14 (A), IC1.4 (PD2(INT0))
D3: DIGIT3.8 (K2), DISPLAY1.13 (C), DISPLAY2.16 (B), IC1.5 (PD3(INT1))
D4: DIGIT2.3 (K1), DISPLAY1.3 (D), DISPLAY2.13 (C), IC1.6 (PD4(XCK/T0))
D5: DIGIT1.3 (K1), DISPLAY1.5 (E), DISPLAY2.3 (D), IC1.11 (PD5(T1))
D6: DISPLAY1.1 (DIG1), DISPLAY2.5 (E), IC1.12 (PD6(AIN0))
D7: DISPLAY1.2 (DIG2), IC1.13 (PD7(AIN1))
D8: DISPLAY1.6 (DIG3), IC1.14 (PB0(ICP))
D9: DIGIT1.7 (A), DIGIT2.7 (A), DIGIT3.7 (A), DIGIT4.7 (A), DISPLAY1.8 (DIG4), IC1.15 (PB1(OC1A))
D10: DIGIT1.6 (B), DIGIT2.6 (B), DIGIT3.6 (B), DIGIT4.6 (B), DISPLAY2.1 (DIG1), IC1.16 (PB2(SS/OC1B))
D11/MOSI: AVR_ISP.4 (MOSI), DIGIT1.4 (C), DIGIT2.4 (C), DIGIT3.4 (C), DIGIT4.4 (C), DISPLAY2.2 (DIG2), IC1.17 (PB3(MOSI/OC2))
D12/MISO: AVR_ISP.1 (MISO), DIGIT1.2 (D), DIGIT2.2 (D), DIGIT3.2 (D), DIGIT4.2 (D), DISPLAY2.6 (DIG3), IC1.18 (PB4(MISO))
D13/SCK: AVR_ISP.3 (SCK), DIGIT1.1 (E), DIGIT2.1 (E), DIGIT3.1 (E), DIGIT4.1 (E), DISPLAY1.11 (F), DISPLAY2.8 (DIG4), IC1.19 (PB5(SCK))
DTR: C8.1, JP1.DTR
GND: AVR_ISP.6 (GND), C1.2, C2.2, C3.2, C4.-, C5.-, C6.2, C7.2, C9.1, IC1.8 (GND), IC1.22 (GND), IC2.5 (GND), IC2.6 (GND), IC2.7 (GND), IC2.8 (GND), IC2.9 (GND), IC2.10 (GND), IC2.11 (GND), IC2.12 (GND), IC2.13 (GND), IC3.4 (GND), IC3.GND, JP1.CTS, JP1.GND, PWR.2, RESET.3 (2), RESET.4 (2), RTC_BATTERY.BOTTOM (-), TVS1.P$1 (1)
unnamed: C9.2, IC1.21 (AREF)
unnamed: D1.A, F1.P$2 (2), TVS1.P$2 (2)
unnamed: C6.1, IC1.9 (PB6(XTAL1/TOSC1)), Y1.2
unnamed: F1.P$1 (1), PWR.1
unnamed: C4.+, D1.C, IC3.IN
unnamed: C7.1, IC1.10 (PB7(XTAL2/TOSC2)), Y1.1
RST: AVR_ISP.5 (RST), C8.2, IC1.1 (PC6(/RESET)), IC2.4 (!RST), R1.P$2 (2), RESET.1, RESET.2 (1)
RX: IC1.2 (PD0(RXD)), JP1.RXI
SCL: IC1.28 (PC5(ADC5/SCL)), IC2.16 (SCL), R3.P$2 (2)
SDA: IC1.27 (PC4(ADC4/SDA)), IC2.15 (SDA), R2.P$2 (2)
TX: IC1.3 (PD1(TXD)), JP1.TXO
VBAT: IC2.14 (VBAT), RTC_BATTERY.TOP@1 (+), RTC_BATTERY.TOP@2 (+)
VCC: AVR_ISP.2 (VCC), C1.1, C2.1, C3.1, C5.+, IC1.7 (VCC), IC1.20 (AVCC), IC2.2 (VCC), IC3.OUT, JP1.VCC, R1.P$1 (1), R2.P$1 (1), R3.P$1 (1)

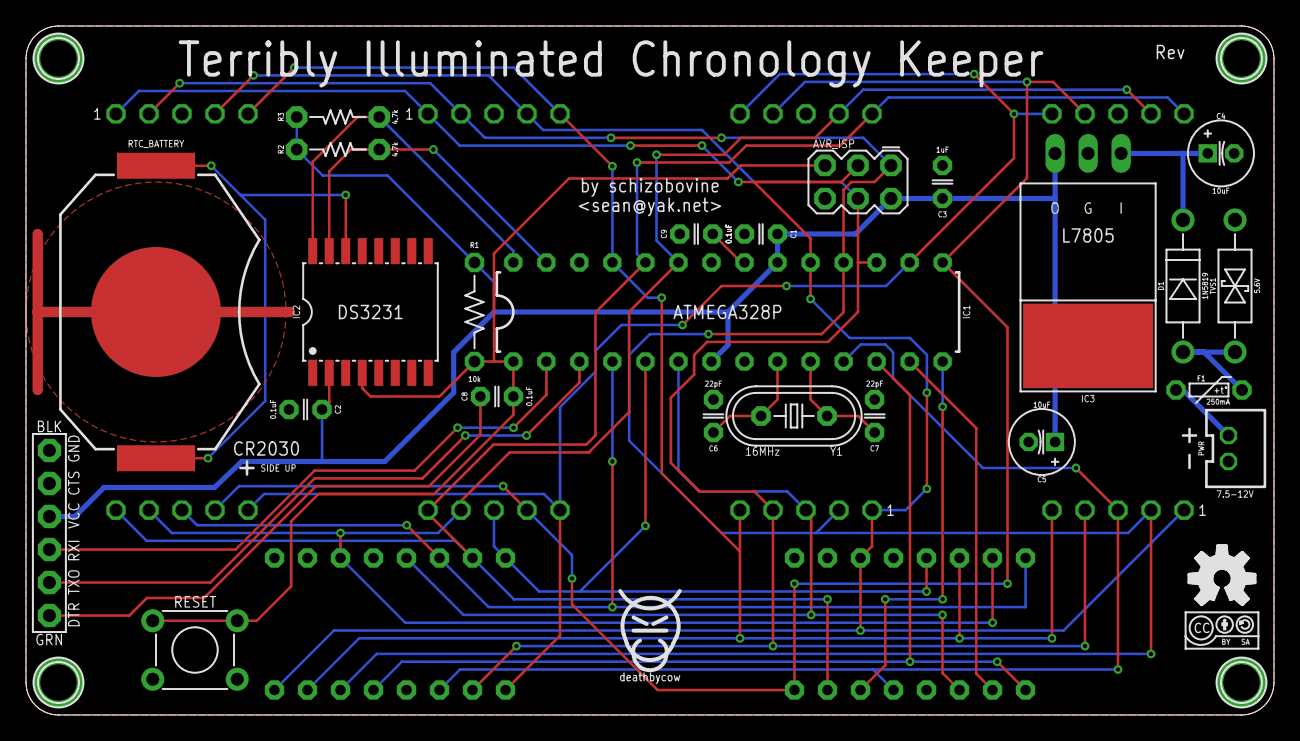
[picture p29: board tick-mk-4.6.6.brd from above]

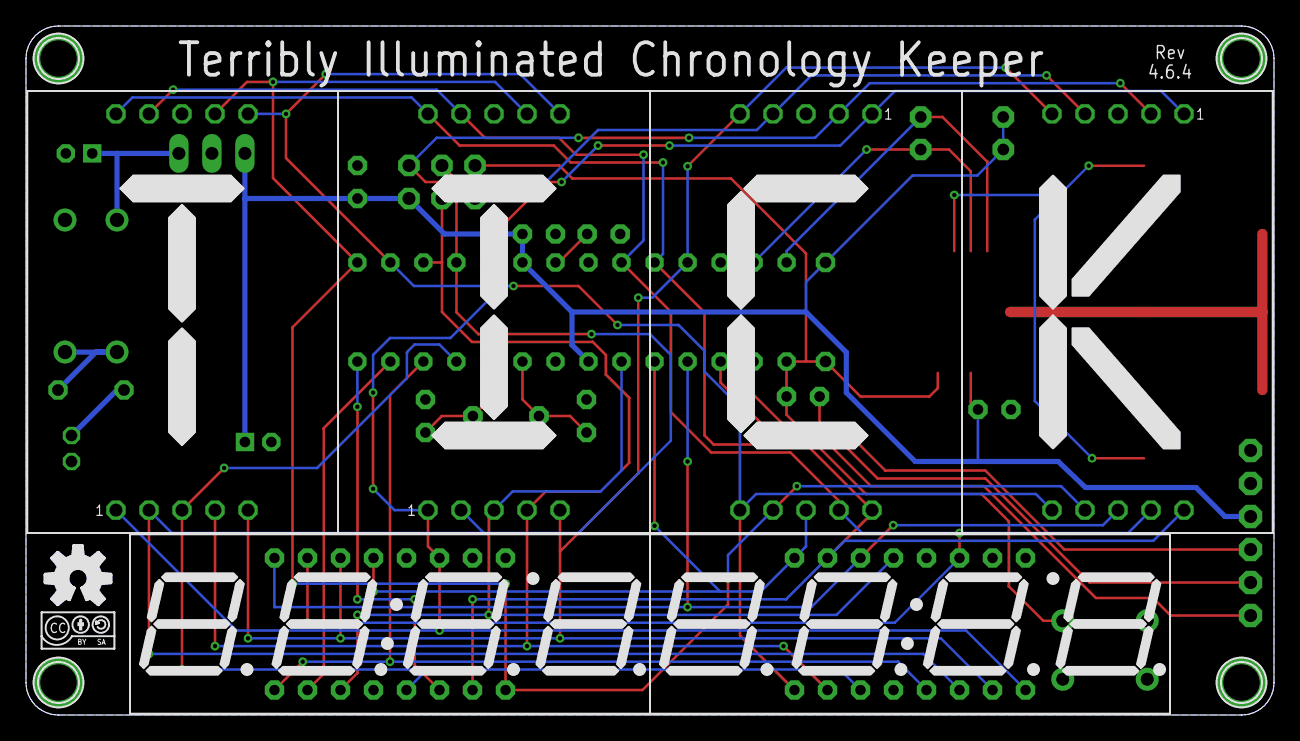
[picture p30: board tick-mk-4.6.6.brd from below]

Board: 2 copper layers, 96.0 x 53.0 mm, 40 parts (9 on the bottom side), 30 nets.

Other parts of the board:
U$1: TICK_SYMBOL
U$2: COW_SMALL
U$4, U$7: CC-BY-SA-4.0-NO-URL
U$5, U$6: OSHWLOGO_TOP_0.2
