seancaulfield/tick/hardware/tick-mini-mk-3.0.brd

## EAGLE design hardware/tick-mini-mk-3.0.brd (2015-06-22)

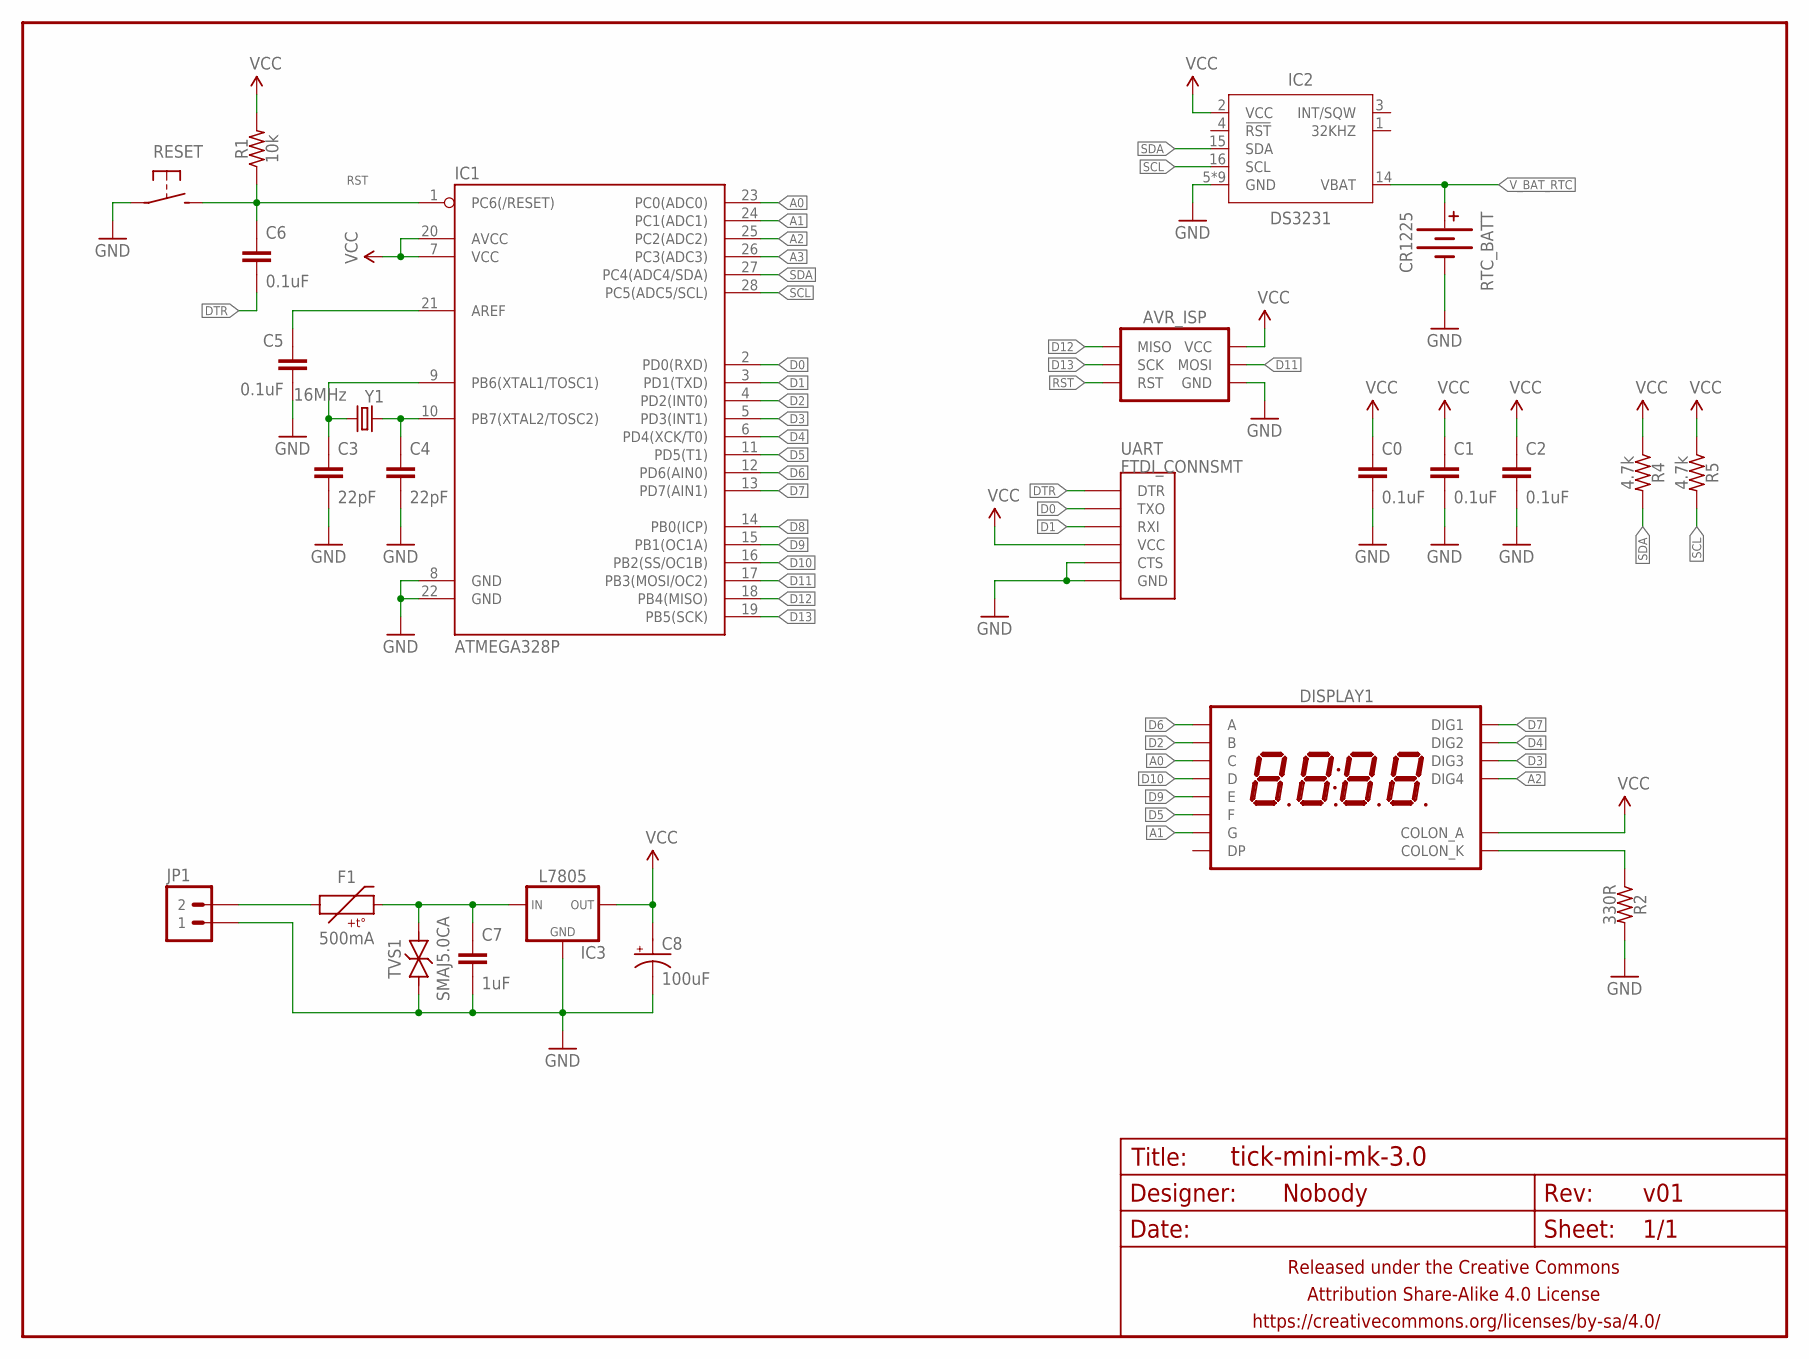
[picture p31: schematic tick-mini-mk-3.0.sch]

Parts:
AVR_ISP: AVR_SPI_PRG_6PTH; 2X3
C0, C1, C2, C5, C6: 0.1uF; C0603
C3, C4: 22pF; C0603
C7: 1uF; C0805
C8: 100uF; E2,5-5
DISPLAY1: 7SEG_4DIGIT_COLON14.2MM-CC-NS; 7SEG_4DIG_NS
F1: 500mA; PTC-1206
FRAME1: FRAME-LETTERNO_PACKAGE; DUMMY
IC1: ATMEGA328P; DIL28-3
IC2: DS3231; SO16W
IC3: L7805; SO08
JP1: M02PTH-CENTERED-R+; 1X02-CENTER-R+
R1: 10k; R0603
R2: 330R; RESISTOR-AXIAL-PTH-7.62MM
R4, R5: 4.7k; R0603
RESET: SPST-NO-TACT3MM-PTH-SMALL-PADS; DTS-3-SMALL-PADS
RTC_BATT: CR1225; BATTCON_12MM
TVS1: SMAJ5.0CA; SMA-DIODE-TVS-BIDIR
UART: FTDI_CONNSMT; FTDI_CONN_SMT
Y1: 16MHz; HC49U-V

Connections:
A0: DISPLAY1.P$4 (C), IC1.23 (PC0(ADC0))
A1: DISPLAY1.P$5 (G), IC1.24 (PC1(ADC1))
A2: DISPLAY1.P$6 (DIG4), IC1.25 (PC2(ADC2))
A3: IC1.26 (PC3(ADC3))
D0: IC1.2 (PD0(RXD)), UART.TXO
D1: IC1.3 (PD1(TXD)), UART.RXI
D2: DISPLAY1.P$9 (B), IC1.4 (PD2(INT0))
D3: DISPLAY1.P$10 (DIG3), IC1.5 (PD3(INT1))
D4: DISPLAY1.P$11 (DIG2), IC1.6 (PD4(XCK/T0))
D5: DISPLAY1.P$12 (F), IC1.11 (PD5(T1))
D6: DISPLAY1.P$13 (A), IC1.12 (PD6(AIN0))
D7: DISPLAY1.P$14 (DIG1), IC1.13 (PD7(AIN1))
D8: IC1.14 (PB0(ICP))
D9: DISPLAY1.P$1 (E), IC1.15 (PB1(OC1A))
D10: DISPLAY1.P$2 (D), IC1.16 (PB2(SS/OC1B))
D11: AVR_ISP.4 (MOSI), IC1.17 (PB3(MOSI/OC2))
D12: AVR_ISP.1 (MISO), IC1.18 (PB4(MISO))
D13: AVR_ISP.3 (SCK), IC1.19 (PB5(SCK))
DTR: C6.2, UART.DTR
GND: AVR_ISP.6 (GND), C0.2, C1.2, C2.2, C3.2, C4.2, C5.2, C7.2, C8.-, IC1.8 (GND), IC1.22 (GND), IC2.5 (GND), IC2.6 (GND), IC2.7 (GND), IC2.8 (GND), IC2.9 (GND), IC2.10 (GND), IC2.11 (GND), IC2.12 (GND), IC2.13 (GND), IC3.2 (GND), IC3.3 (GND), IC3.4 (GND), IC3.5 (GND), IC3.6 (GND), IC3.7 (GND), JP1.1, R2.P$2 (2), RESET.1, RTC_BATT.GND (-), TVS1.1, UART.CTS, UART.GND
unnamed: C4.1, IC1.10 (PB7(XTAL2/TOSC2)), Y1.1
unnamed: C3.1, IC1.9 (PB6(XTAL1/TOSC1)), Y1.2
unnamed: C5.1, IC1.21 (AREF)
unnamed: DISPLAY1.P$7 (COLON_K), R2.P$1 (1)
unnamed: F1.1, JP1.2
unnamed: C7.1, F1.2, IC3.8 (IN), TVS1.2
RST: AVR_ISP.5 (RST), C6.1, IC1.1 (PC6(/RESET)), R1.1, RESET.2
SCL: IC1.28 (PC5(ADC5/SCL)), IC2.16 (SCL), R5.2
SDA: IC1.27 (PC4(ADC4/SDA)), IC2.15 (SDA), R4.2
VCC: AVR_ISP.2 (VCC), C0.1, C1.1, C2.1, C8.+, DISPLAY1.P$8 (COLON_A), IC1.7 (VCC), IC1.20 (AVCC), IC2.2 (VCC), IC3.1 (OUT), R1.2, R4.1, R5.1, UART.VCC
V_BAT_RTC: IC2.14 (VBAT), RTC_BATT.PWR@1 (+)

Board: 2 copper layers, 26 parts (2 on the bottom side), 29 nets, no tracks yet.
