seancaulfield/tick/hardware/tick-mini-mk-2.0.brd

## EAGLE design hardware/tick-mini-mk-2.0.brd (2015-05-26)

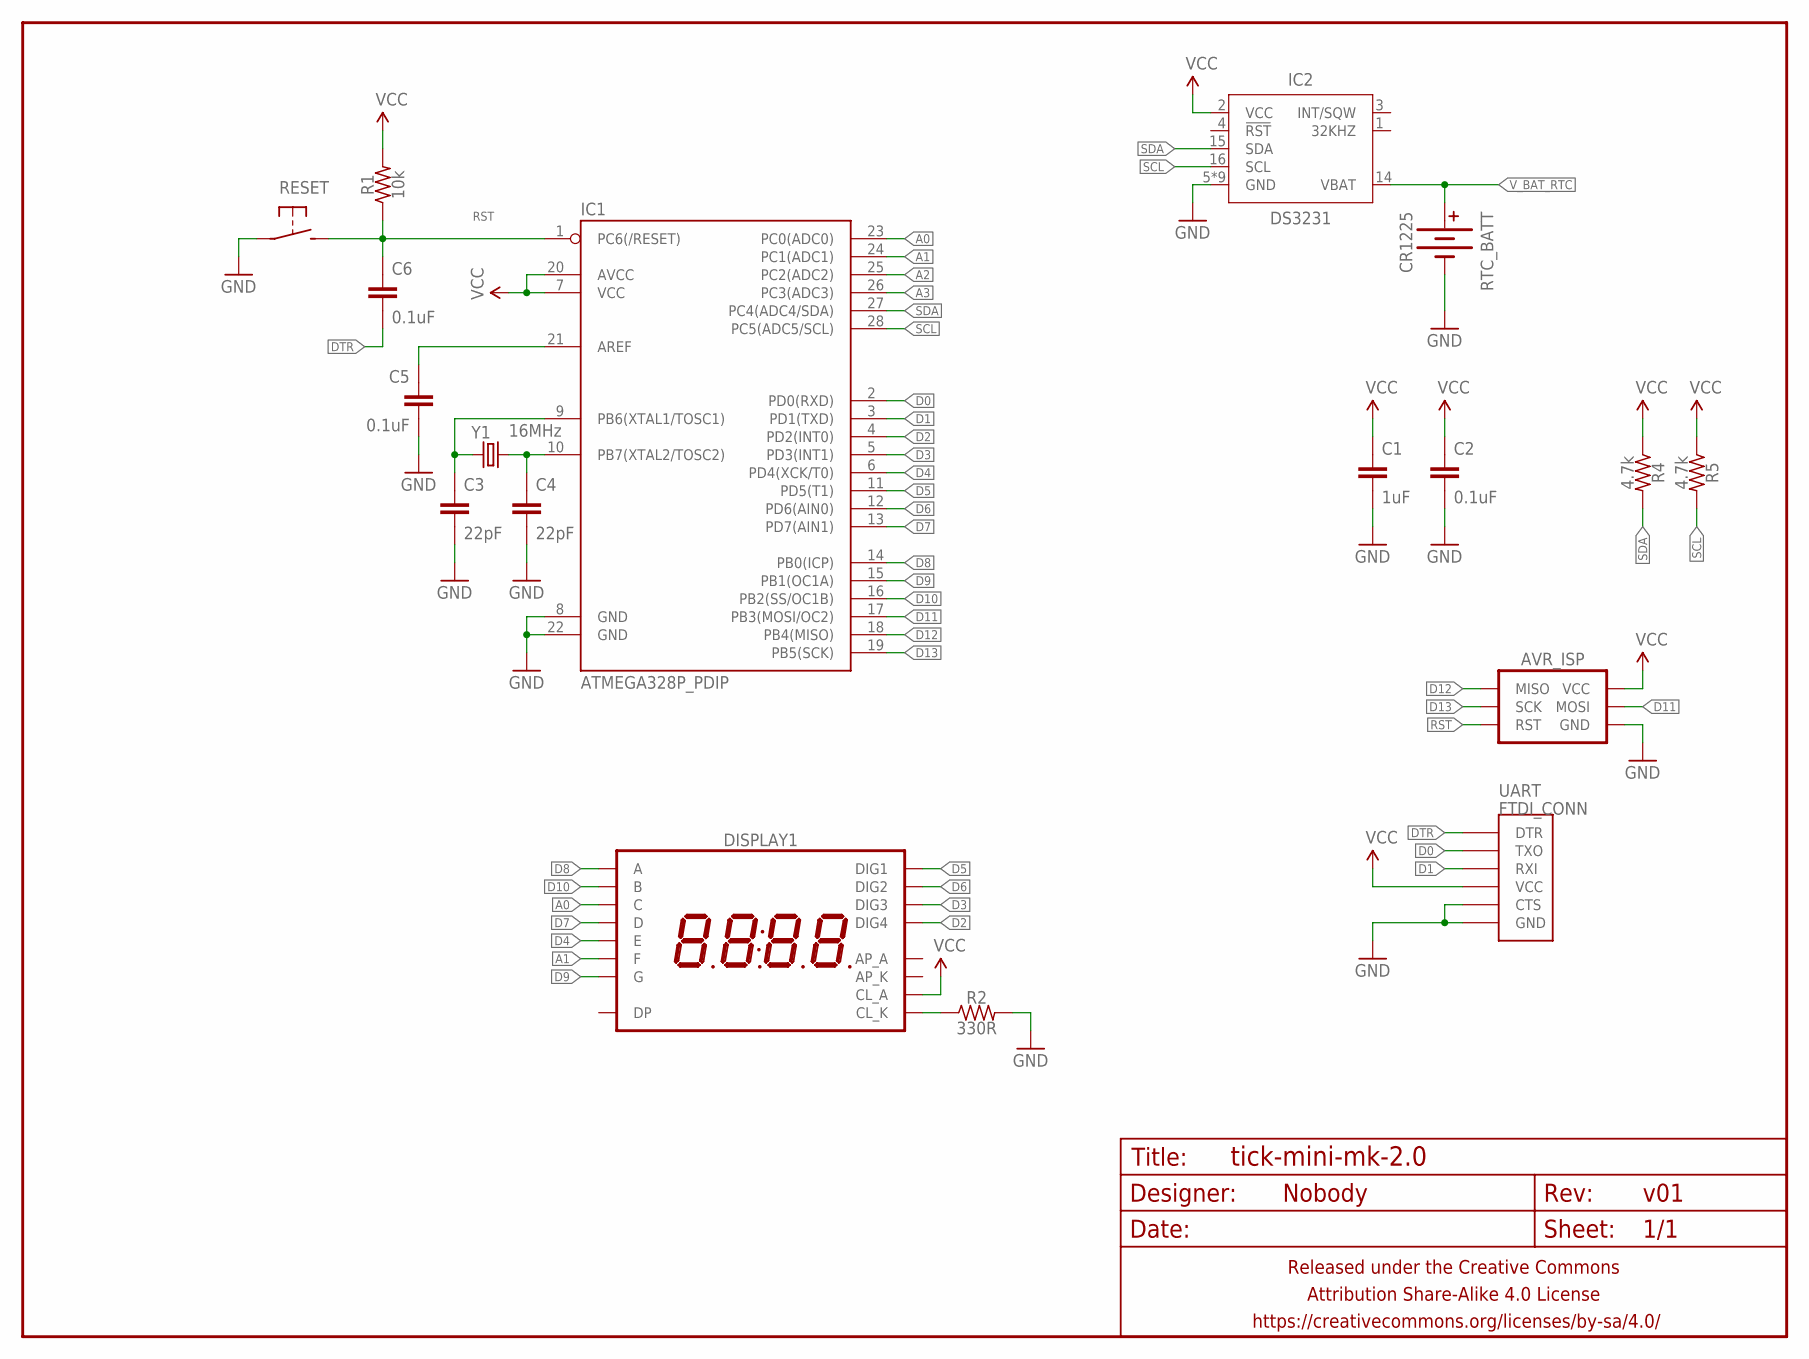
[picture p32: schematic tick-mini-mk-2.0.sch]

Parts:
AVR_ISP: AVR_SPI_PRG_6PTH; 2X3
C1: 1uF; C025-024X044
C2, C5, C6: 0.1uF; C025-024X044
C3, C4: 22pF; C025-024X044
DISPLAY1: 7SEG_4DIGIT_COLON_APOS; 7SEG_4DIG_10MM
FRAME1: FRAME-LETTERNO_PACKAGE; DUMMY
IC1: ATMEGA328P_PDIP; DIL28-3
IC2: DS3231; SO16W
R1: 10k; RESISTOR-AXIAL-PTH-6.35MM
R2: 330R; RESISTOR-AXIAL-PTH-6.35MM
R4, R5: 4.7k; RESISTOR-AXIAL-PTH-6.35MM
RESET: SPST-NO-TACT6MM-PTH-SMALL-PADS; DTS-6-SMALL-PADS
RTC_BATT: CR1225; BATTCON_12MM_PTH_TOPLOAD
UART: FTDI_CONN
Y1: 16MHz; HC49U-V

Connections:
A0: DISPLAY1.13 (C), IC1.23 (PC0(ADC0))
A1: DISPLAY1.11 (F), IC1.24 (PC1(ADC1))
A2: IC1.25 (PC2(ADC2))
A3: IC1.26 (PC3(ADC3))
D0: IC1.2 (PD0(RXD)), UART.TXO
D1: IC1.3 (PD1(TXD)), UART.RXI
D2: DISPLAY1.8 (DIG4), IC1.4 (PD2(INT0))
D3: DISPLAY1.6 (DIG3), IC1.5 (PD3(INT1))
D4: DISPLAY1.5 (E), IC1.6 (PD4(XCK/T0))
D5: DISPLAY1.1 (DIG1), IC1.11 (PD5(T1))
D6: DISPLAY1.2 (DIG2), IC1.12 (PD6(AIN0))
D7: DISPLAY1.3 (D), IC1.13 (PD7(AIN1))
D8: DISPLAY1.14 (A), IC1.14 (PB0(ICP))
D9: DISPLAY1.15 (G), IC1.15 (PB1(OC1A))
D10: DISPLAY1.16 (B), IC1.16 (PB2(SS/OC1B))
D11: AVR_ISP.4 (MOSI), IC1.17 (PB3(MOSI/OC2))
D12: AVR_ISP.1 (MISO), IC1.18 (PB4(MISO))
D13: AVR_ISP.3 (SCK), IC1.19 (PB5(SCK))
DTR: C6.2, UART.DTR
GND: AVR_ISP.6 (GND), C1.2, C2.2, C3.2, C4.2, C5.2, IC1.8 (GND), IC1.22 (GND), IC2.5 (GND), IC2.6 (GND), IC2.7 (GND), IC2.8 (GND), IC2.9 (GND), IC2.10 (GND), IC2.11 (GND), IC2.12 (GND), IC2.13 (GND), R2.P$2 (2), RESET.1, RESET.2 (1), RTC_BATT.-, UART.CTS, UART.GND
unnamed: C4.1, IC1.10 (PB7(XTAL2/TOSC2)), Y1.2
unnamed: C3.1, IC1.9 (PB6(XTAL1/TOSC1)), Y1.1
unnamed: C5.1, IC1.21 (AREF)
unnamed: DISPLAY1.12 (CL_K), R2.P$1 (1)
RST: AVR_ISP.5 (RST), C6.1, IC1.1 (PC6(/RESET)), R1.P$1 (1), RESET.3 (2), RESET.4 (2)
SCL: IC1.28 (PC5(ADC5/SCL)), IC2.16 (SCL), R5.P$2 (2)
SDA: IC1.27 (PC4(ADC4/SDA)), IC2.15 (SDA), R4.P$2 (2)
VCC: AVR_ISP.2 (VCC), C1.1, C2.1, DISPLAY1.4 (CL_A), IC1.7 (VCC), IC1.20 (AVCC), IC2.2 (VCC), R1.P$2 (2), R4.P$1 (1), R5.P$1 (1), UART.VCC
V_BAT_RTC: IC2.14 (VBAT), RTC_BATT.+

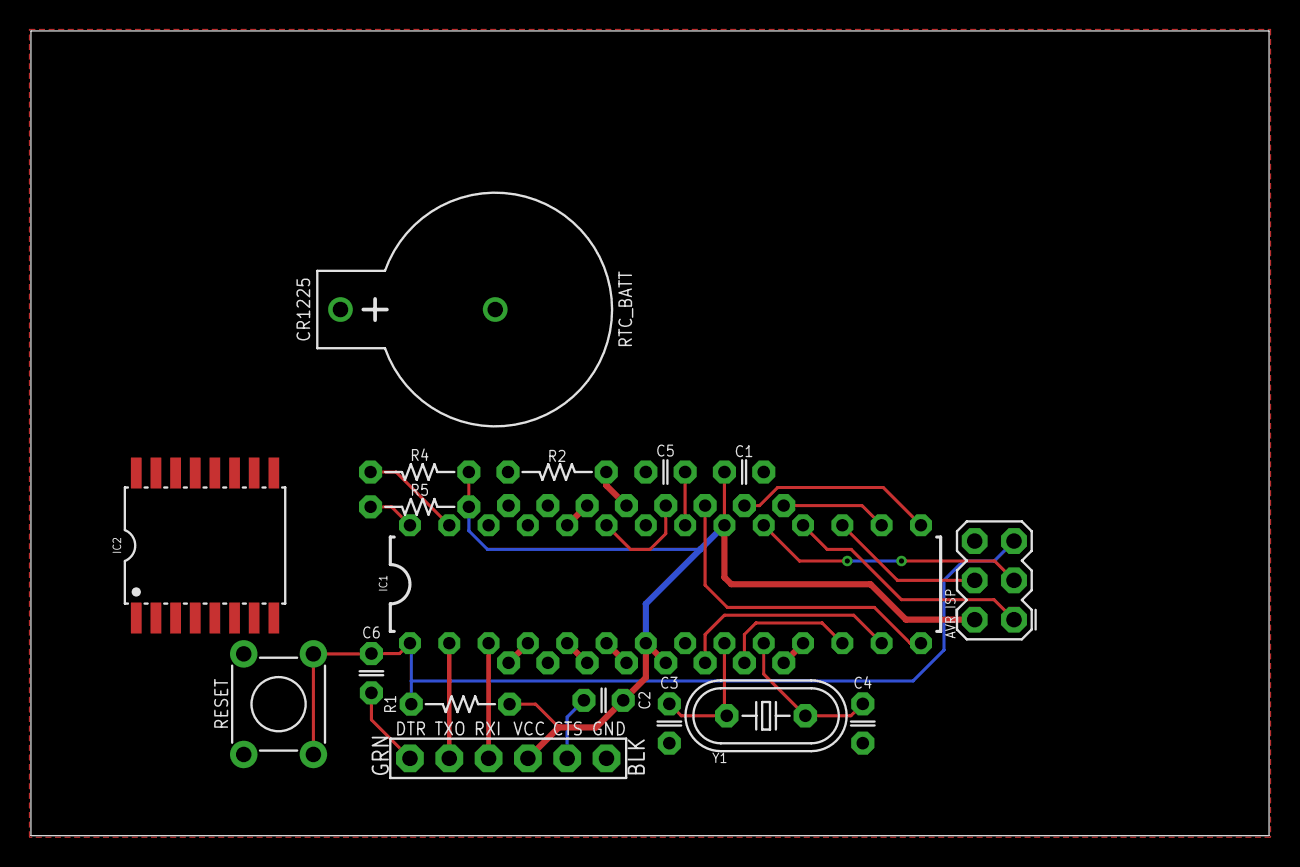
[picture p33: board tick-mini-mk-2.0.brd from above]

Board: 2 copper layers, 80.0 x 52.0 mm, 19 parts (1 on the bottom side), 27 nets.
