seancaulfield/tick/hardware/tick-box-1591A-mk-2.2.brd

## EAGLE design hardware/tick-box-1591A-mk-2.2.brd (2015-05-26)

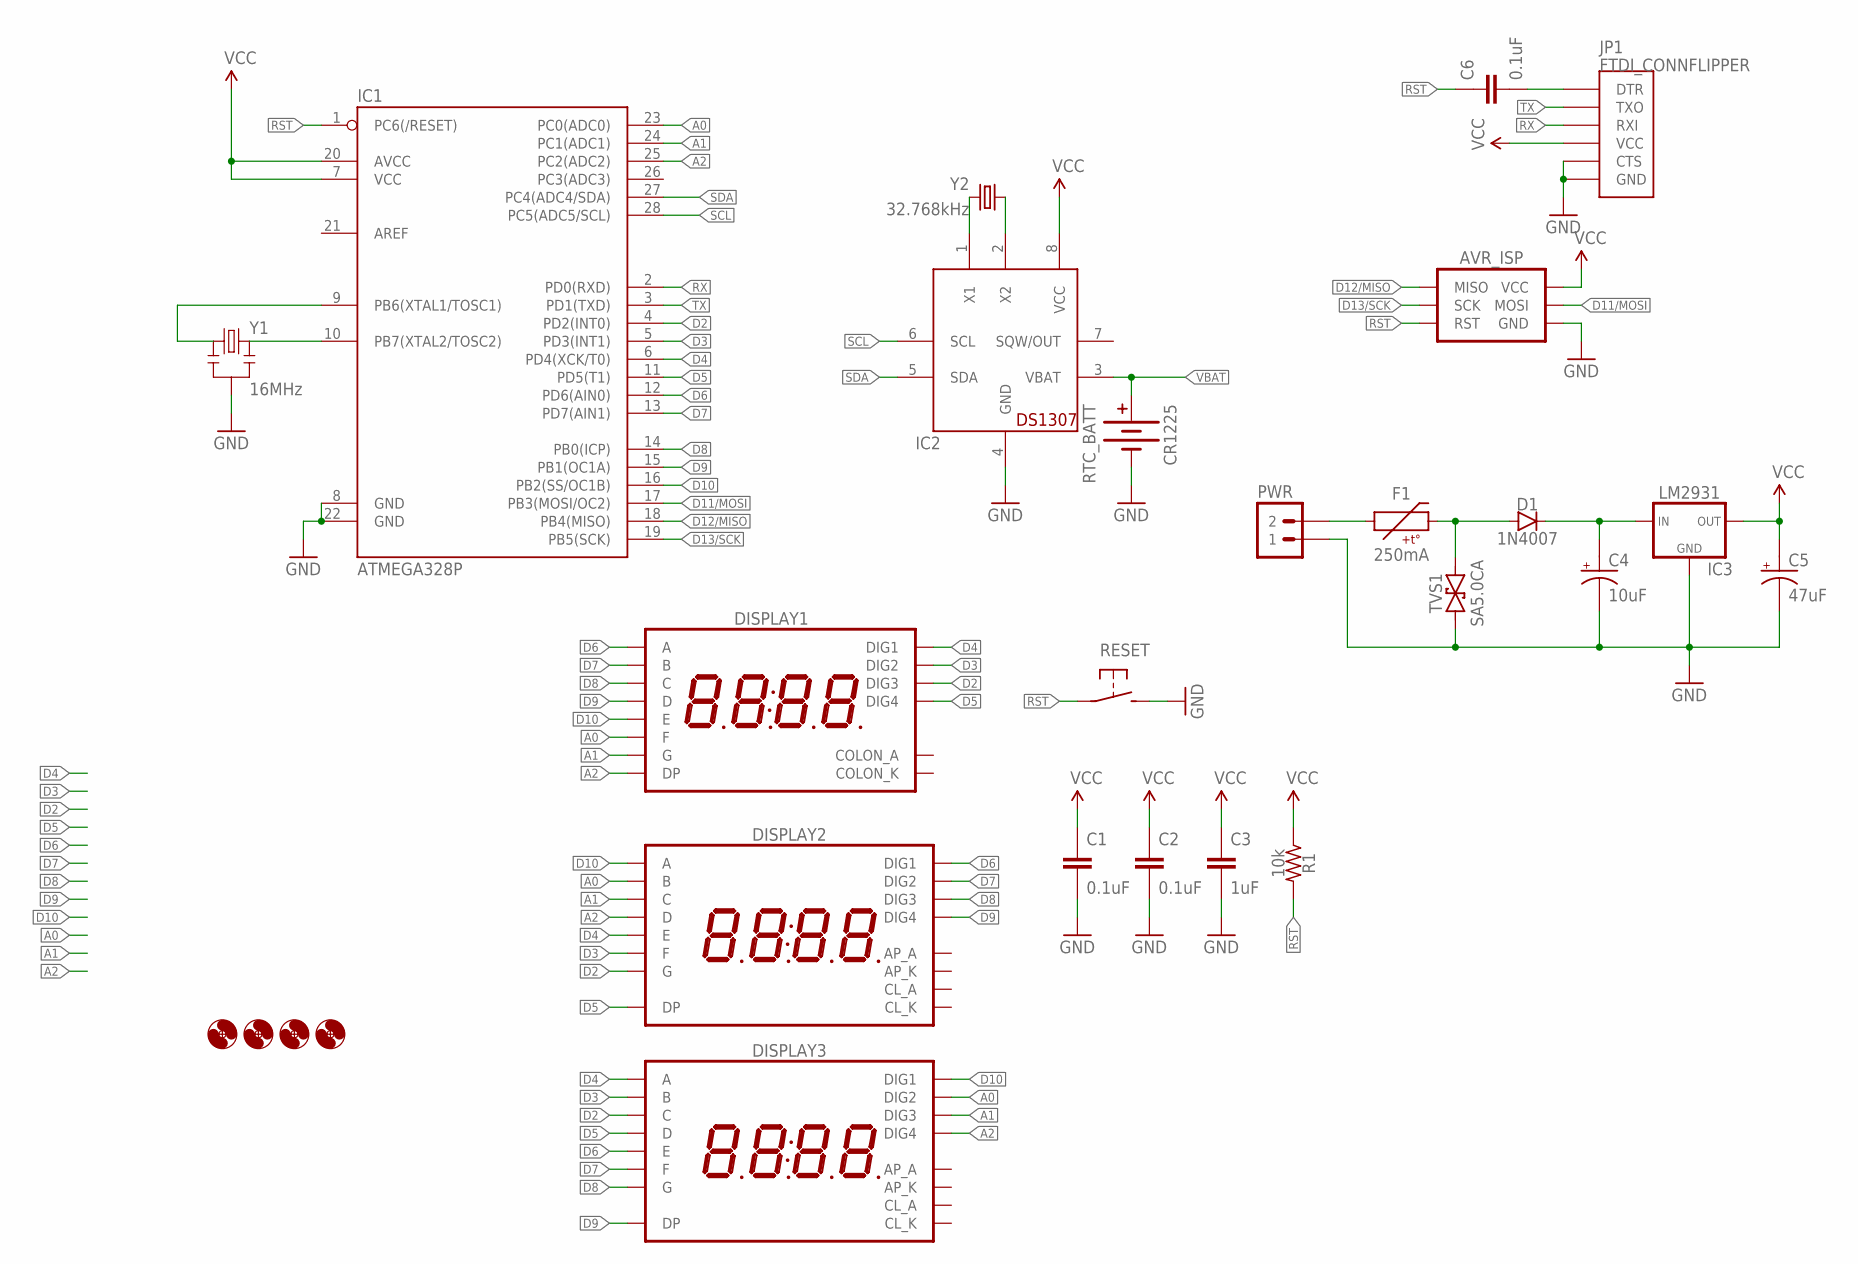
[picture p34: schematic tick-box-1591A-mk-2.2.sch]

Parts:
AVR_ISP: AVR_SPI_PRG_6PTH; 2X3
C1, C2, C6: 0.1uF; C025-024X044
C3: 1uF; C025-024X044
C4: 10uF; E2-5
C5: 47uF; E2,5-6
D1: 1N4007; DIODE-10.16MM
DISPLAY1: 7SEG_4DIGIT_COLON14.2MM-CC-NS; 7SEG_4DIG_NS
DISPLAY2, DISPLAY3: 7SEG_4DIGIT_COLON_APOS; 7SEG_4DIG_10MM
F1: 250mA; PTC-PTH-5.08MM
H1, H2, H3, H4: HOLE#2; HOLE-#2
IC1: ATMEGA328P; DIL28-3
IC2: DS1307; DIL08
IC3: LM2931; TO-92-AMMO
JP1: FTDI_CONNFLIPPER; FTDI_CONN_FLIP
PWR: M02PTH-CENTERED; 1X02-CENTER
R1: 10k; RESISTOR-AXIAL-PTH-6.35MM
RESET: SPST-NO-TACT3MM-PTH-SMALL-PADS; DTS-3-SMALL-PADS
RTC_BATT: CR1225; BATTCON_12MM_PTH_TOPLOAD
TVS1: SA5.0CA; DO-41-TVS-BI-10.16MM
Y1: 16MHz; RESONATOR-PTH
Y2: 32.768kHz; TC26H

Connections:
A0: DISPLAY1.P$12 (F), DISPLAY2.16 (B), DISPLAY3.2 (DIG2), IC1.23 (PC0(ADC0))
A1: DISPLAY1.P$5 (G), DISPLAY2.13 (C), DISPLAY3.6 (DIG3), IC1.24 (PC1(ADC1))
A2: DISPLAY1.P$3 (DP), DISPLAY2.3 (D), DISPLAY3.8 (DIG4), IC1.25 (PC2(ADC2))
D2: DISPLAY1.P$10 (DIG3), DISPLAY2.15 (G), DISPLAY3.13 (C), IC1.4 (PD2(INT0))
D3: DISPLAY1.P$11 (DIG2), DISPLAY2.11 (F), DISPLAY3.16 (B), IC1.5 (PD3(INT1))
D4: DISPLAY1.P$14 (DIG1), DISPLAY2.5 (E), DISPLAY3.14 (A), IC1.6 (PD4(XCK/T0))
D5: DISPLAY1.P$6 (DIG4), DISPLAY2.7 (DP), DISPLAY3.3 (D), IC1.11 (PD5(T1))
D6: DISPLAY1.P$13 (A), DISPLAY2.1 (DIG1), DISPLAY3.5 (E), IC1.12 (PD6(AIN0))
D7: DISPLAY1.P$9 (B), DISPLAY2.2 (DIG2), DISPLAY3.11 (F), IC1.13 (PD7(AIN1))
D8: DISPLAY1.P$4 (C), DISPLAY2.6 (DIG3), DISPLAY3.15 (G), IC1.14 (PB0(ICP))
D9: DISPLAY1.P$2 (D), DISPLAY2.8 (DIG4), DISPLAY3.7 (DP), IC1.15 (PB1(OC1A))
D10: DISPLAY1.P$1 (E), DISPLAY2.14 (A), DISPLAY3.1 (DIG1), IC1.16 (PB2(SS/OC1B))
D11/MOSI: AVR_ISP.4 (MOSI), IC1.17 (PB3(MOSI/OC2))
D12/MISO: AVR_ISP.1 (MISO), IC1.18 (PB4(MISO))
D13/SCK: AVR_ISP.3 (SCK), IC1.19 (PB5(SCK))
GND: AVR_ISP.6 (GND), C1.2, C2.2, C3.2, C4.-, C5.-, IC1.8 (GND), IC1.22 (GND), IC2.4 (GND), IC3.2 (GND), JP1.CTS, JP1.GND, PWR.1, RESET.2, RTC_BATT.-, TVS1.P$1 (1), Y1.2
unnamed: IC1.10 (PB7(XTAL2/TOSC2)), Y1.3
unnamed: IC1.9 (PB6(XTAL1/TOSC1)), Y1.1
unnamed: D1.A, F1.P$2 (2), TVS1.P$2 (2)
unnamed: F1.P$1 (1), PWR.2
unnamed: C4.+, D1.C, IC3.1 (IN)
unnamed: IC2.2 (X2), Y2.1
unnamed: C6.2, JP1.DTR
unnamed: IC2.1 (X1), Y2.2
RST: AVR_ISP.5 (RST), C6.1, IC1.1 (PC6(/RESET)), R1.P$2 (2), RESET.1
RX: IC1.2 (PD0(RXD)), JP1.RXI
SCL: IC1.28 (PC5(ADC5/SCL)), IC2.6 (SCL)
SDA: IC1.27 (PC4(ADC4/SDA)), IC2.5 (SDA)
TX: IC1.3 (PD1(TXD)), JP1.TXO
VBAT: IC2.3 (VBAT), RTC_BATT.+
VCC: AVR_ISP.2 (VCC), C1.1, C2.1, C3.1, C5.+, IC1.7 (VCC), IC1.20 (AVCC), IC2.8 (VCC), IC3.3 (OUT), JP1.VCC, R1.P$1 (1)

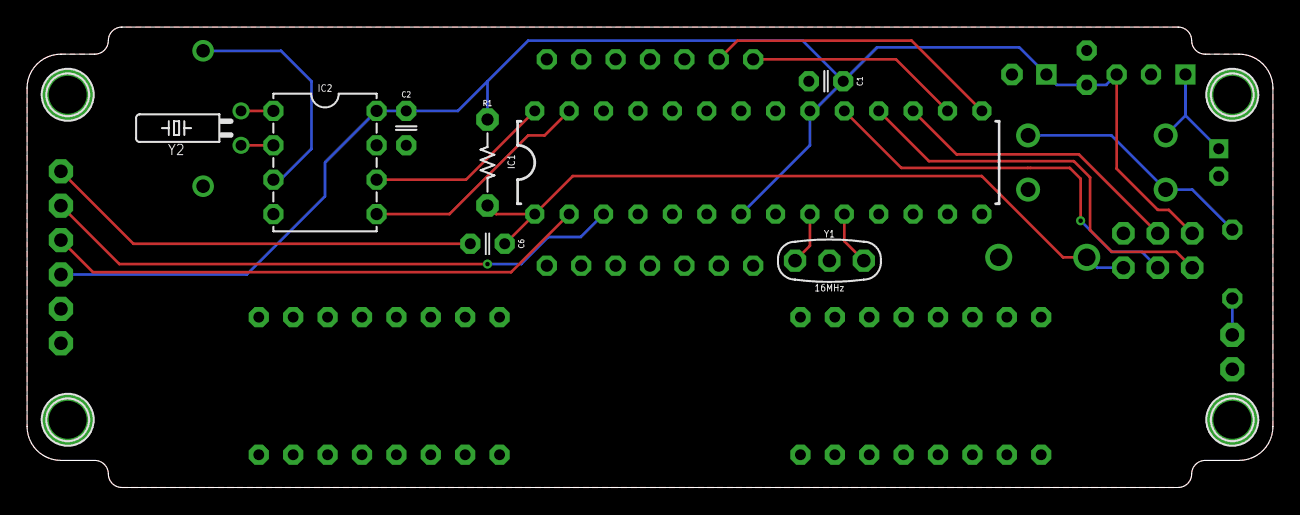
[picture p35: board tick-box-1591A-mk-2.2.brd from above]

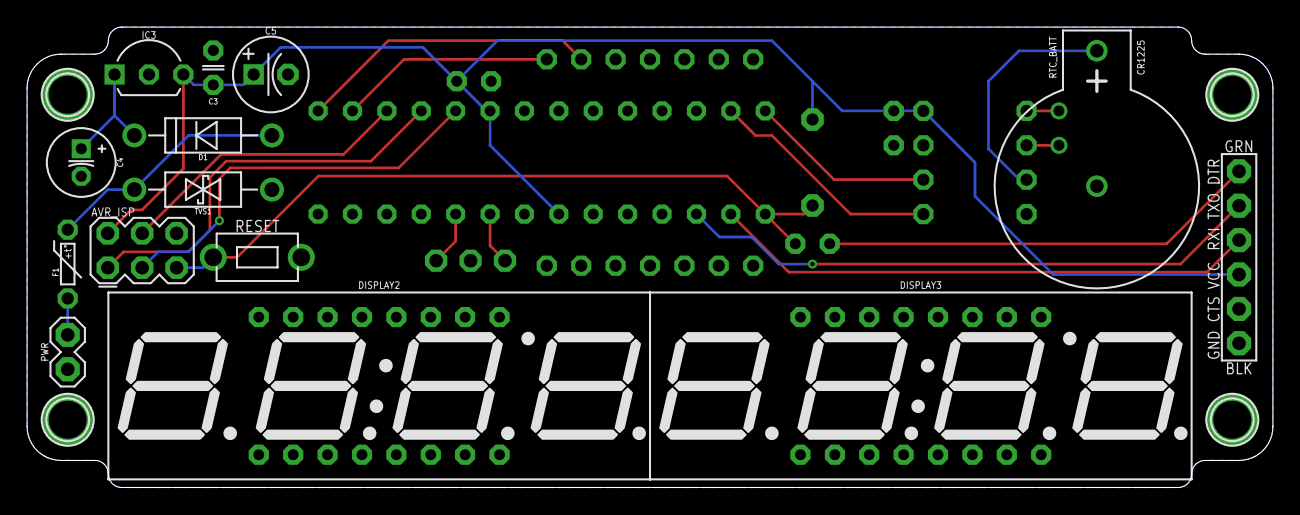
[picture p36: board tick-box-1591A-mk-2.2.brd from below]

Board: 2 copper layers, 92.0 x 34.0 mm, 27 parts (15 on the bottom side), 31 nets.
