seancaulfield/tick/hardware/tick-box-1591A-mk-4.0.brd

## EAGLE design hardware/tick-box-1591A-mk-4.0.brd (2015-03-20)

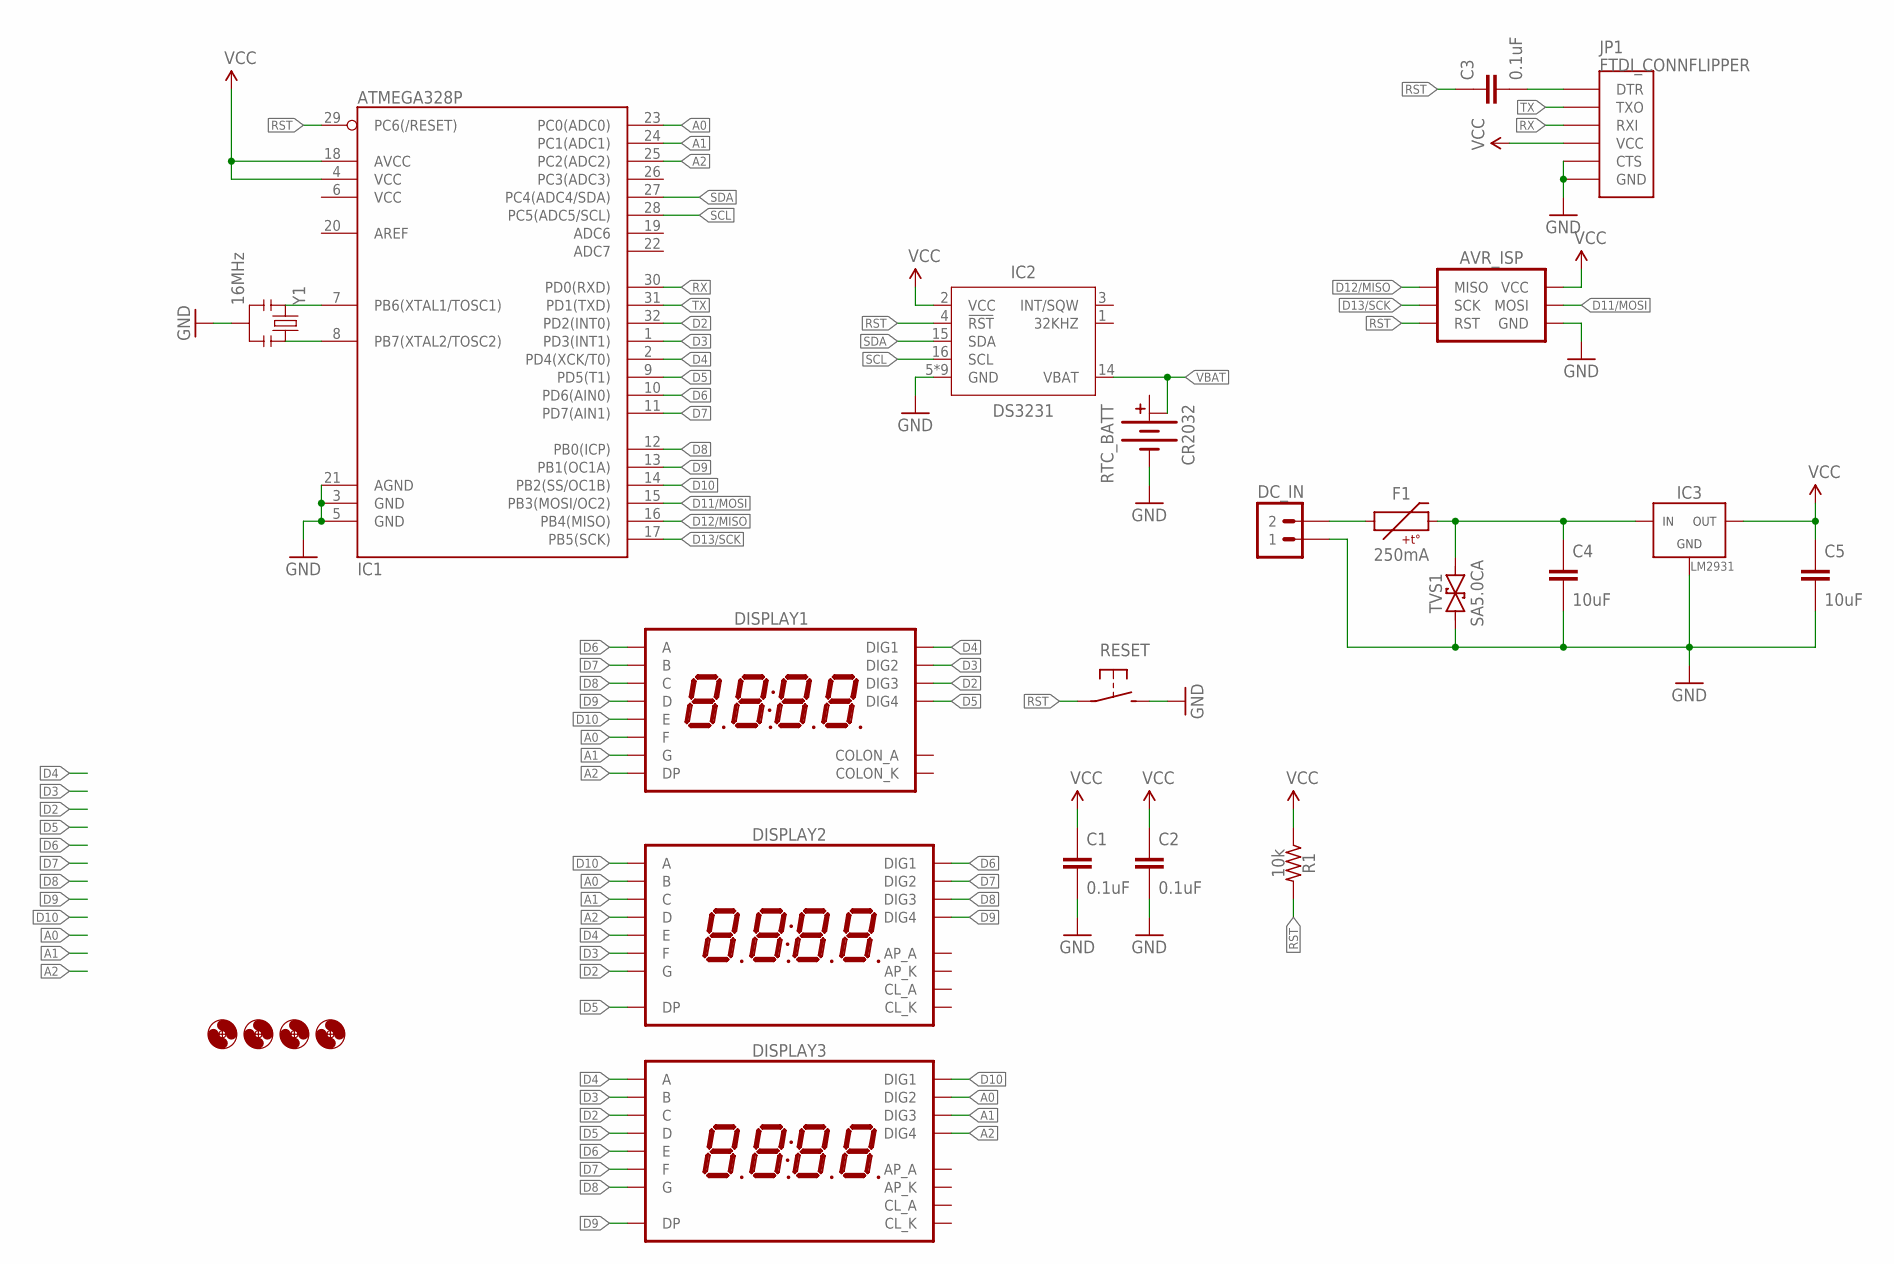
[picture p37: schematic tick-box-1591A-mk-4.0.sch]

Parts:
AVR_ISP: AVR_SPI_PRG_6PTH; 2X3
C1, C2, C3: 0.1uF; C0603
C4, C5: 10uF; C1206
DC_IN: M02PTH; 1X02
DISPLAY1: 7SEG_4DIGIT_COLON14.2MM-CC-NS; 7SEG_4DIG_NS
DISPLAY2, DISPLAY3: 7SEG_4DIGIT_COLON_APOS; 7SEG_4DIG_10MM
F1: 250mA; PTC-1206
H1, H2, H3, H4: HOLE#2; HOLE-#2
IC1: ATMEGA328P; TQFP32-08
IC2: DS3231; SO16W
IC3: LM2931; SO08
JP1: FTDI_CONNFLIPPER; FTDI_CONN_FLIP
R1: 10k; R0603
RESET: SPST-NO-TACT3MM-PTH-SMALL-PADS; DTS-3-SMALL-PADS
RTC_BATT: CR2032; BATTCON_20MM_MINE
TVS1: SA5.0CA; SMA-DIODE-TVS-BIDIR
Y1: 16MHz; CSTCE_V_RESONATOR

Connections:
A0: DISPLAY1.P$12 (F), DISPLAY2.16 (B), DISPLAY3.2 (DIG2), IC1.23 (PC0(ADC0))
A1: DISPLAY1.P$5 (G), DISPLAY2.13 (C), DISPLAY3.6 (DIG3), IC1.24 (PC1(ADC1))
A2: DISPLAY1.P$3 (DP), DISPLAY2.3 (D), DISPLAY3.8 (DIG4), IC1.25 (PC2(ADC2))
D2: DISPLAY1.P$10 (DIG3), DISPLAY2.15 (G), DISPLAY3.13 (C), IC1.32 (PD2(INT0))
D3: DISPLAY1.P$11 (DIG2), DISPLAY2.11 (F), DISPLAY3.16 (B), IC1.1 (PD3(INT1))
D4: DISPLAY1.P$14 (DIG1), DISPLAY2.5 (E), DISPLAY3.14 (A), IC1.2 (PD4(XCK/T0))
D5: DISPLAY1.P$6 (DIG4), DISPLAY2.7 (DP), DISPLAY3.3 (D), IC1.9 (PD5(T1))
D6: DISPLAY1.P$13 (A), DISPLAY2.1 (DIG1), DISPLAY3.5 (E), IC1.10 (PD6(AIN0))
D7: DISPLAY1.P$9 (B), DISPLAY2.2 (DIG2), DISPLAY3.11 (F), IC1.11 (PD7(AIN1))
D8: DISPLAY1.P$4 (C), DISPLAY2.6 (DIG3), DISPLAY3.15 (G), IC1.12 (PB0(ICP))
D9: DISPLAY1.P$2 (D), DISPLAY2.8 (DIG4), DISPLAY3.7 (DP), IC1.13 (PB1(OC1A))
D10: DISPLAY1.P$1 (E), DISPLAY2.14 (A), DISPLAY3.1 (DIG1), IC1.14 (PB2(SS/OC1B))
D11/MOSI: AVR_ISP.4 (MOSI), IC1.15 (PB3(MOSI/OC2))
D12/MISO: AVR_ISP.1 (MISO), IC1.16 (PB4(MISO))
D13/SCK: AVR_ISP.3 (SCK), IC1.17 (PB5(SCK))
GND: AVR_ISP.6 (GND), C1.2, C2.2, C4.2, C5.2, DC_IN.1, IC1.3 (GND), IC1.5 (GND), IC1.21 (AGND), IC2.5 (GND), IC2.6 (GND), IC2.7 (GND), IC2.8 (GND), IC2.9 (GND), IC2.10 (GND), IC2.11 (GND), IC2.12 (GND), IC2.13 (GND), IC3.2 (GND), IC3.3 (GND), IC3.4 (GND), IC3.5 (GND), IC3.6 (GND), IC3.7 (GND), JP1.CTS, JP1.GND, RESET.2, RTC_BATT.BOTTOM (-), TVS1.1, Y1.2
unnamed: IC1.7 (PB6(XTAL1/TOSC1)), Y1.3
unnamed: IC1.8 (PB7(XTAL2/TOSC2)), Y1.1
unnamed: DC_IN.2, F1.1
unnamed: C4.1, F1.2, IC3.8 (IN), TVS1.2
unnamed: C3.2, JP1.DTR
RST: AVR_ISP.5 (RST), C3.1, IC1.29 (PC6(/RESET)), IC2.4 (!RST), R1.2, RESET.1
RX: IC1.30 (PD0(RXD)), JP1.RXI
SCL: IC1.28 (PC5(ADC5/SCL)), IC2.16 (SCL)
SDA: IC1.27 (PC4(ADC4/SDA)), IC2.15 (SDA)
TX: IC1.31 (PD1(TXD)), JP1.TXO
VBAT: IC2.14 (VBAT), RTC_BATT.TOP@2 (+1)
VCC: AVR_ISP.2 (VCC), C1.1, C2.1, C5.1, IC1.4 (VCC), IC1.18 (AVCC), IC2.2 (VCC), IC3.1 (OUT), JP1.VCC, R1.1

Board: 2 copper layers, 24 parts (6 on the bottom side), 28 nets, no tracks yet.
