seancaulfield/tick/hardware/tick-box-1591A-mk-3.1.brd

## EAGLE design hardware/tick-box-1591A-mk-3.1.brd (2015-03-17)

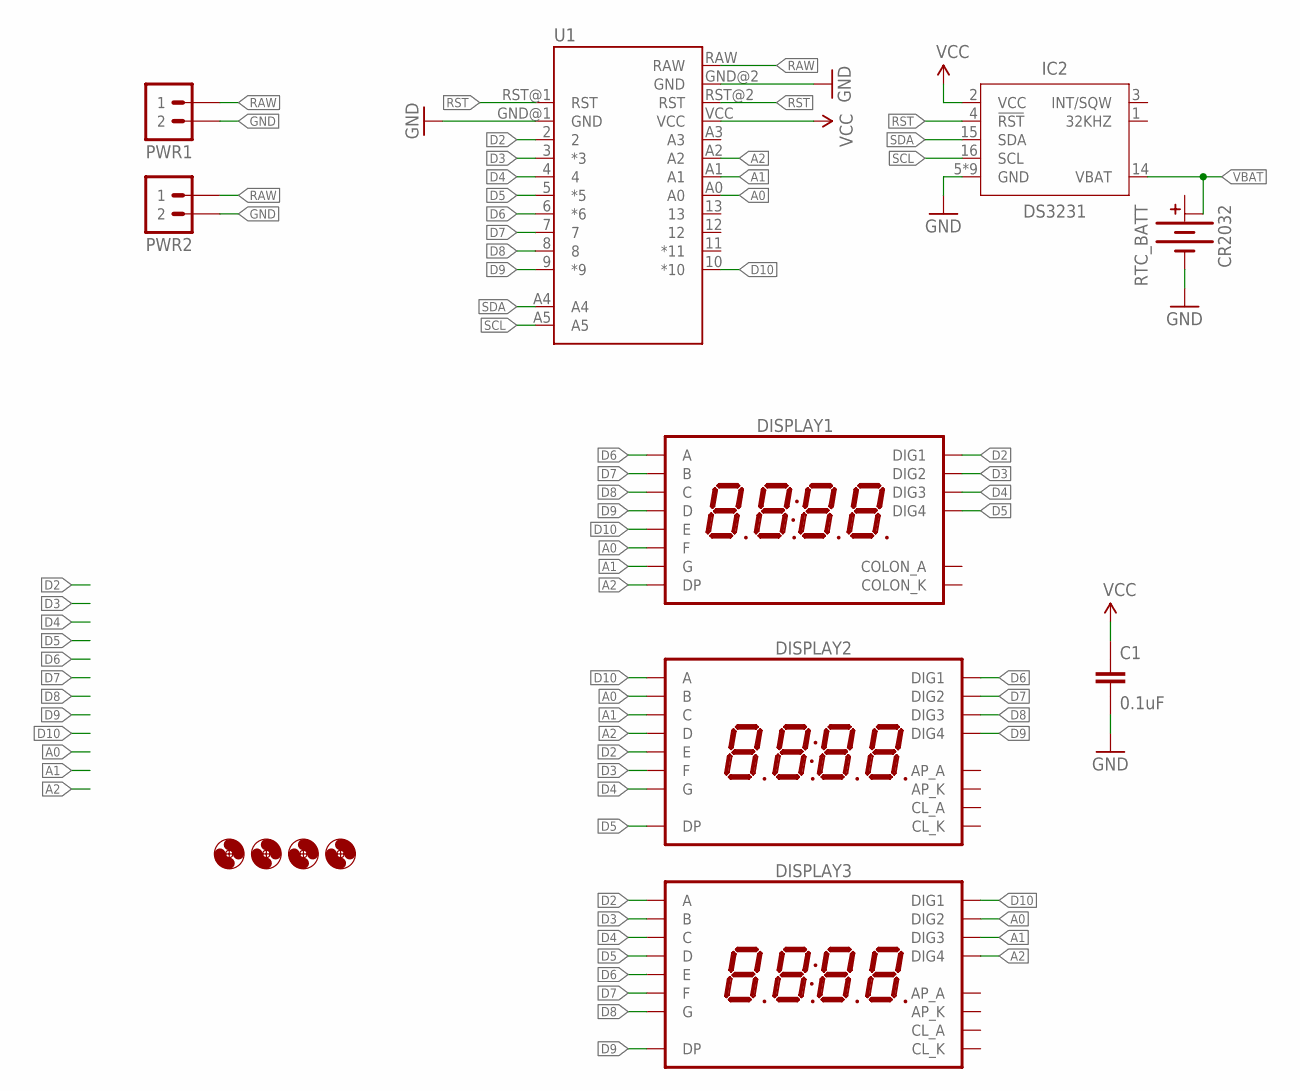
[picture p38: schematic tick-box-1591A-mk-3.1.sch]

Parts:
C1: 0.1uF; C025-024X044
DISPLAY1: 7SEG_4DIGIT_COLON14.2MM-CC-NS; 7SEG_4DIG_NS
DISPLAY2, DISPLAY3: 7SEG_4DIGIT_COLON_APOS; 7SEG_4DIG_10MM
H1, H2, H3, H4: HOLE#2; HOLE-#2
IC2: DS3231; SO16W
PWR1, PWR2: M02PTH-CENTERED; 1X02-CENTER
RTC_BATT: CR2032; BATTCON_20MM_MINE
U1: ARDUINO_PRO_MINI_TICK

Connections:
A0: DISPLAY1.P$12 (F), DISPLAY2.16 (B), DISPLAY3.2 (DIG2), U1.A0
A1: DISPLAY1.P$5 (G), DISPLAY2.13 (C), DISPLAY3.6 (DIG3), U1.A1
A2: DISPLAY1.P$3 (DP), DISPLAY2.3 (D), DISPLAY3.8 (DIG4), U1.A2
D2: DISPLAY1.P$14 (DIG1), DISPLAY2.5 (E), DISPLAY3.14 (A), U1.2
D3: DISPLAY1.P$11 (DIG2), DISPLAY2.11 (F), DISPLAY3.16 (B), U1.3 (*3)
D4: DISPLAY1.P$10 (DIG3), DISPLAY2.15 (G), DISPLAY3.13 (C), U1.4
D5: DISPLAY1.P$6 (DIG4), DISPLAY2.7 (DP), DISPLAY3.3 (D), U1.5 (*5)
D6: DISPLAY1.P$13 (A), DISPLAY2.1 (DIG1), DISPLAY3.5 (E), U1.6 (*6)
D7: DISPLAY1.P$9 (B), DISPLAY2.2 (DIG2), DISPLAY3.11 (F), U1.7
D8: DISPLAY1.P$4 (C), DISPLAY2.6 (DIG3), DISPLAY3.15 (G), U1.8
D9: DISPLAY1.P$2 (D), DISPLAY2.8 (DIG4), DISPLAY3.7 (DP), U1.9 (*9)
D10: DISPLAY1.P$1 (E), DISPLAY2.14 (A), DISPLAY3.1 (DIG1), U1.10 (*10)
GND: C1.2, IC2.5 (GND), IC2.6 (GND), IC2.7 (GND), IC2.8 (GND), IC2.9 (GND), IC2.10 (GND), IC2.11 (GND), IC2.12 (GND), IC2.13 (GND), PWR1.2, PWR2.2, RTC_BATT.BOTTOM (-), U1.GND@1 (GND), U1.GND@2 (GND)
RAW: PWR1.1, PWR2.1, U1.RAW
RST: IC2.4 (!RST), U1.RST@1 (RST), U1.RST@2 (RST)
SCL: IC2.16 (SCL), U1.A5
SDA: IC2.15 (SDA), U1.A4
VBAT: IC2.14 (VBAT), RTC_BATT.TOP@2 (+1)
VCC: C1.1, IC2.2 (VCC), U1.VCC

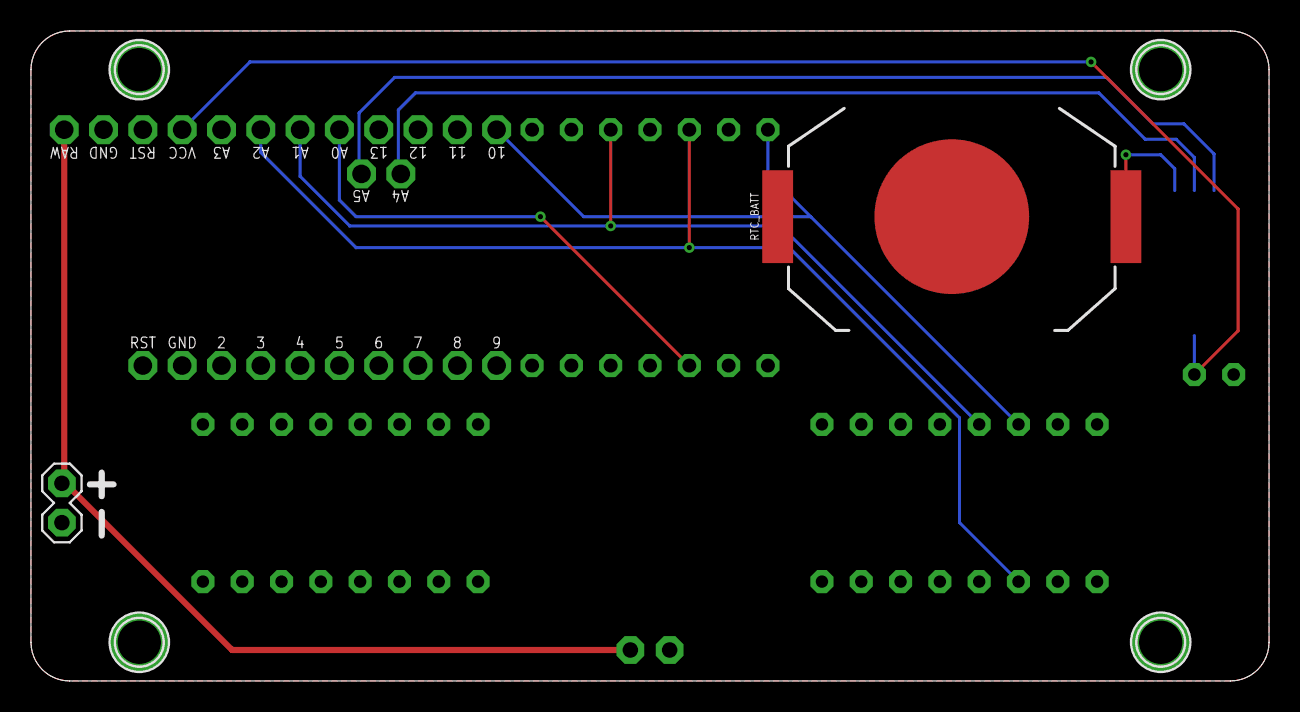
[picture p39: board tick-box-1591A-mk-3.1.brd from above]

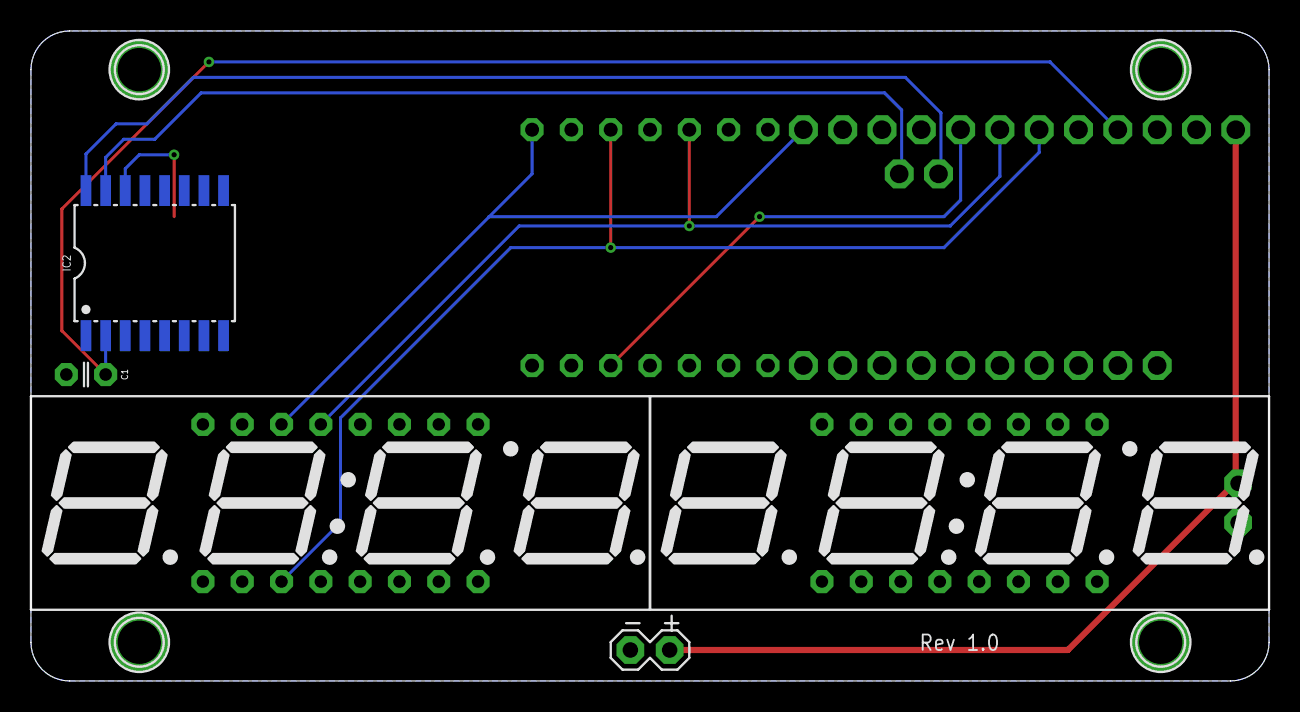
[picture p40: board tick-box-1591A-mk-3.1.brd from below]

Board: 2 copper layers, 80.0 x 42.0 mm, 13 parts (6 on the bottom side), 19 nets.
