seancaulfield/tick/firmware/charlieplexer/charlie.h

#ifndef __UNICORN_KIDNEYS_H
#define __UNICORN_KIDNEYS_H

#include <Arduino.h>
#if 0
#include <stdint.h>

class CharlieDigit {
  public:
    CharlieDigit(uint8_t a, uint8_t b, uint8_t c, uint8_t d, uint8_t e, uint8_t f, uint8_t g, uint8_t p, uint8_t k);
    void off();
    void write(uint8_t c);
  private:
    uint8_t a;
    uint8_t b;
    uint8_t c;
    uint8_t d;
    uint8_t e;
    uint8_t f;
    uint8_t g;
    uint8_t p;
    uint8_t k;
};

#endif

#endif
