seancaulfield/tick/(commit log)

2014-12-15 initialization commit
    [tick-controller-mk-2.brd, tick-controller-mk-2.sch, tick-display-mk-2.1-mini.brd, tick-display-mk-2.1-mini.sch, tick-display-mk-2.2-mini.brd, tick-display-mk-2.2-mini.sch, tick-display-mk-2.3-mini.brd, tick-display-mk-2.3-mini.sch]
2014-12-19 shift register based version
    [tick-display-mk-3-mini.brd, tick-display-mk-3-mini.sch]
2014-12-20 scaled down even more
    [tick-display-mk-3-mini.brd, tick-display-mk-3-mini.sch]
2015-01-23 again with the not sure what the fuck i was thinking
    [tick-display-mk-3-mini.brd, tick-display-mk-3-mini.sch]
2015-01-23 look clocks are hard
    [tick-display-mk-4-mini.brd, tick-display-mk-4-mini.sch, tick-mk-2.brd, tick-mk-2.sch]
2015-02-16 tinkering with shit
    [tick-controller-mk-3.brd, tick-controller-mk-3.sch, tick-display-mk-3.1.brd, tick-display-mk-3.1.sch, tick-display-mk-3.brd, tick-display-mk-3.sch, tick-display-mk-4.brd, tick-display-mk-4.sch]
2015-02-16 charlieplexing shield attempt
    [tick-shield-mk-1.brd, tick-shield-mk-1.sch]
2015-02-17 shieldify all the things
    [tick-shield-mk-1.brd, tick-shield-mk-1.sch]
2015-02-19 going for a fully integrated board now using charlieplexing
    [tick-mk-4.1.brd, tick-mk-4.1.sch, tick-mk-4.brd, tick-mk-4.sch, tick-shield-mk-1.brd]
2015-02-20 routed and RTC chip added
    [tick-mk-4.1.brd, tick-mk-4.1.sch]
2015-02-20 adding onboard regulator
    [tick-mk-4.2.brd, tick-mk-4.2.sch]
2015-02-21 swapping most SMD components to PTH ones except for the ICs
    [tick-mk-4.2.brd, tick-mk-4.2.sch]
2015-02-22 layout complete for rev 4.2
    [tick-mk-4.2.brd, tick-mk-4.2.sch]
2015-02-22 rev 4.3 tweaked i2c lines and replaced resonator with crystal and caps
    [tick-mk-4.3.brd, tick-mk-4.3.sch]
2015-02-22 branching a new version to use a different core chip type (pth based probably)
    [tick-mk-4.4.brd, tick-mk-4.4.sch]
2015-02-22 pth version done, way easier than expected
    [tick-mk-4.4.brd, tick-mk-4.4.sch]
2015-02-23 smt barrels of fun
    [tick-mk-4.5.brd, tick-mk-4.5.sch]
2015-02-23 reverting v4.4 and adding 4.6 for compromise between saner layout and all pth/on-hand parts design
    [tick-mk-4.6.brd, tick-mk-4.6.sch]
2015-02-23 i unno
    [tick-mk-4.6.brd]
2015-02-23 twiddled with dimensions to fit a hammond 1591XXC enclosure
    [tick-mk-4.6.brd, tick-mk-4.6.sch]
2015-02-23 redoing YET AGAIN going back to the max7219 chips i have an asston of
    [tick-mk-4.7.brd, tick-mk-4.7.sch]
2015-02-25 commit before pull
    [tick-mk-4.7.brd, tick-mk-4.7.sch]
2015-02-27 more layout tinkering for the max7129 soic version. broke out into a board with only the two display drivers on it for now, will add other componets once this layout part is done.
    [tick-mk-4.7.1.brd, tick-mk-4.7.1.sch, tick-mk-4.7.sch]
2015-02-28 relayout of pth version using only atmega for charlieplexing
    [tick-mk-4.6.1.brd, tick-mk-4.6.1.sch]
2015-02-28 adding second ground plane to bottom layer and tweaking a few lines on the silkscreen layer
    [tick-mk-4.6.1.brd, tick-mk-4.6.1.sch]
2015-02-28 yet another redo, this time to swap to using UART/arduino for code uploading (so I can use that to synchronize the time) and to free up an analog pin to read the backup battery level
    [tick-mk-4.6.2.brd, tick-mk-4.6.2.sch]
2015-03-01 nets complete, now for layout
    [tick-mk-4.6.2.brd, tick-mk-4.6.2.sch]
2015-03-02 layout done but still need to add battery monitoring circuit
    [tick-mk-4.6.2.brd, tick-mk-4.6.2.sch]
2015-03-03 resistor divider to check battery level
    [tick-mk-4.6.2.brd, tick-mk-4.6.2.sch]
2015-03-04 finished this layout changed my mind again
    [tick-mk-4.6.2.brd]
2015-03-04 throwing a ds3231s at the problem
    [tick-mk-4.6.3.brd, tick-mk-4.6.3.sch]
2015-03-05 think i'm done fiddling
    [tick-mk-4.6.3.brd, tick-mk-4.6.3.sch]
2015-03-05 nope, switching to 0.1in headers for ftdi conn
    [tick-mk-4.6.4.brd, tick-mk-4.6.4.sch]
2015-03-05 headers swapped, layout de-fucked a bit more
    [tick-mk-4.6.4.brd, tick-mk-4.6.4.sch]
2015-03-06 tweaks to silkscreen and traces
    [tick-mk-4.6.4.brd]
2015-03-06 more bottom silk tweaks since oshpark isn't rendering the board right
    [tick-mk-4.6.4.brd, tick-mk-4.6.4.sch]
2015-03-06 description update and further widening of bottom silk layer vector graphics in case that's oshapark's problem
    [tick-mk-4.6.4.brd, tick-mk-4.6.4.sch]
2015-03-09 a whole bunch of versions and not sure which work. check 'em all in and sort it out later
    [tick-box-1591A-mk-1.0.brd, tick-box-1591A-mk-1.0.sch, tick-box-1591b-mk-1.0.brd, tick-box-1591b-mk-1.0.sch, tick-box-1591b-shield-mk-1.0.brd, tick-box-1591b-shield-mk-1.0.sch, tick-mini-mk-1.0.brd, tick-mini-mk-1.0.sch]
2015-03-10 well that made it work for now, but ugh, need to fix this
    [tick.h, tick.ino]
2015-03-16 clocks are hard, some more stabs
    [tick-box-1591A-mk-1.0.brd, tick-box-1591b-shield-mk-1.0.brd, tick-box-1591b-shield-mk-1.0.sch]
2015-03-16 clocks are hard, some more stabs pt 2 the electric buggering
    [tick-box-1591A-mk-2.0.brd, tick-box-1591A-mk-2.0.sch, tick-box-1591b-standalone-mk-1.0.brd]
2015-03-17 more shit for my shitty self
    [tick-box-1591A-mk-3.0.brd, tick-box-1591A-mk-3.0.sch, tick-box-1591A-mk-3.1.brd, tick-box-1591A-mk-3.1.sch]
2015-03-20 more attempts at a hammond 1591A sized clock
    [tick-box-1591A-mk-2.1.brd, tick-box-1591A-mk-2.1.sch, tick-box-1591A-mk-4.0.brd, tick-box-1591A-mk-4.0.sch]
2015-03-21 layout done
    [tick-box-1591A-mk-2.2.brd, tick-box-1591A-mk-2.2.sch]
2015-03-22 reorganizing firmware to have a few different variants for the boards
2015-03-22 more layout tweaks for smt design
    [tick-box-1591A-mk-2.2.brd]
2015-03-22 Fixes: RX/TX swapped, RST disconnected, UART moved.
    [tick-mk-4.6.5.brd, tick-mk-4.6.5.sch]
2015-05-11 more charlieplexing FAIL code
    [charlie.cpp, charlie.h, charlieplexer.ino, testing.ino, usec.h]
2015-05-26 another fucking miniversion
    [tick-mini-mk-2.0.brd, tick-mini-mk-2.0.sch, tick-mini-mk-2.1.brd, tick-mini-mk-2.1.sch]
2015-05-27 more twiddling and otherwise not making progress
    [tick-mini-mk-2.2.brd, tick-mini-mk-2.2.sch]
2015-06-22 i swear i will make this sucker work
    [tick-mini-mk-3.0.brd, tick-mini-mk-3.0.sch, tick-mini-mk-3.1.brd, tick-mini-mk-3.1.sch, tick-mini-mk-4.0.brd, tick-mini-mk-4.0.sch, tick-mini-mk-4.1.brd, tick-mini-mk-4.1.sch]
2015-07-18 more versions
    [tick-mk-4.6.6.brd, tick-mk-4.6.6.sch, tick-mk-5.0.0.brd, tick-mk-5.0.0.sch, tick-mk-5.0.1.brd, tick-mk-5.0.1.sch]
2015-08-10 ds3231 breakouts
    [tick-ds3231-breakout-mk-1.0.brd, tick-ds3231-breakout-mk-1.0.sch, tick-ds3231-breakout-mk-2.0.brd, tick-ds3231-breakout-mk-2.0.sch, tick-ds3231-breakout-mk-2.1.brd, tick-ds3231-breakout-mk-2.1.sch]
2015-08-10 more boards
    [tick-mini-mk-4.2.brd, tick-mini-mk-4.2.sch, tick-mini-mk-4.3.brd, tick-mini-mk-4.3.sch, tick-mini-shield-mk-1.0.brd, tick-mini-shield-mk-1.0.sch, tick-shield-mk-2.0.brd, tick-shield-mk-2.0.sch]
2015-11-30 new versions for reasons
    [tick-mk-5.0.brd, tick-mk-5.0.sch, tick-mk-5.1.brd, tick-mk-5.1.sch]
2015-12-01 new board using adafruit metro
    [tick-box-1591A-mk-5.0.brd, tick-box-1591A-mk-5.0.sch]
2016-02-06 initial commit of esp8266 based version
    [tick-wifi-mk-1.0.brd, tick-wifi-mk-1.0.sch]
2016-02-07 version to use feather
    [tick-wifi-mk-1.1.brd, tick-wifi-mk-1.1.sch]
2016-02-07 fix some derp my-C-is-soooo-rusty mistakes
    [config_file.cpp, wifi_tick.ino]
2016-02-10 layout finished for wifail board
    [tick-wifi-mk-1.1.brd, tick-wifi-mk-1.1.sch]
2016-02-27 new board
    [tick-wifi-mk-1.2.brd, tick-wifi-mk-1.2.sch]
2016-02-27 poc for ht16k33 i2c display controller operating at 3.3V
2016-03-02 design for esp8266 huzzah i2d 7 segment display using ht16k33-28
    [tick-wifi-mini-mk-1.0.brd, tick-wifi-mini-mk-1.0.sch]
2016-03-18 two new revisions, but only 1.2 will work b/c i'm a moron
    [tick-wifi-mini-mk-1.1.brd, tick-wifi-mini-mk-1.1.sch, tick-wifi-mini-mk-1.2.brd, tick-wifi-mini-mk-1.2.sch]
2016-07-01 new hw rev
    [tick-wifi-mini-mk-1.3.brd, tick-wifi-mini-mk-1.3.sch]
2016-07-01 firmware to set DS1307 and DS3231 i2c RTCs using NTP data
2016-07-19 more wip
    [tick-wifi-mk-1.0.brd, tick-wifi-mk-1.0.sch, tick-wifi-mk-1.1.brd, tick-wifi-mk-1.1.sch]
2016-07-20 more wip again
    [tick-wifi-mk-1.1.brd, tick-wifi-mk-1.1.sch]
2016-07-26 new tick version
    [tick-wifi-mk-1.1.brd, tick-wifi-mk-1.1.sch]
2016-07-26 dicking around with layouts
    [tick-wifi-mk-0.9.brd, tick-wifi-mk-0.9.sch, tick-wifi-mk-1.1a.brd, tick-wifi-mk-1.1a.sch]
2016-08-18 how did this not get commited before?
    [tick-wifi-mk-0.9.brd]
2016-08-19 yet another attempt at a ht16k33 driver
    [tick-wifi-mini-mk-1.3.brd, tick-wifi-mini-mk-1.3.sch]
2016-08-26 fucking silkscreen error--flipped CLK and DAT markings
    [tick-wifi-mk-1.2.brd, tick-wifi-mk-1.2.sch]
2017-05-29 more bored boards
    [tick-pi-mk-1.0.brd, tick-pi-mk-1.0.sch]
2017-05-29 code for rpi based tick with custom pcb
2017-05-31 add ht16k33 i2c version
2017-07-01 moar boards
    [tick-pcf2129t-breakout-mk-1.0.brd, tick-pcf2129t-breakout-mk-1.0.sch, tinyduino-breakout-mk-5.1.brd]
2017-09-30 added retry logic around i2c errors
    [clock.py]
2017-11-02 more pi boards
    [tick-pi-mk-1.1.brd, tick-pi-mk-1.1.sch]
2017-11-09 blank display on shutdown, update udev rules for shutdown button
2017-11-09 remove my crappy devicetree failures
2019-09-27 fix issue where keeps blinking after signal
    [clock.py]
