seancaulfield/tick/(notices)

Notices in the files:
hardware/tick-wifi-mk-0.9.brd:
Licensed Under
Creative Commons
parts and their libraries:
A_butts: Released under the Creative Commons Attribution Share-Alike 4.0 License
A_butts: https://creativecommons.org/licenses/by-sa/4.0
A_butts: Released under the Creative Commons
